paulmirel/STELLA-1/STELLA_1.2/Documentation/lab_spec_documents/photos/IMG_4180.jpeg

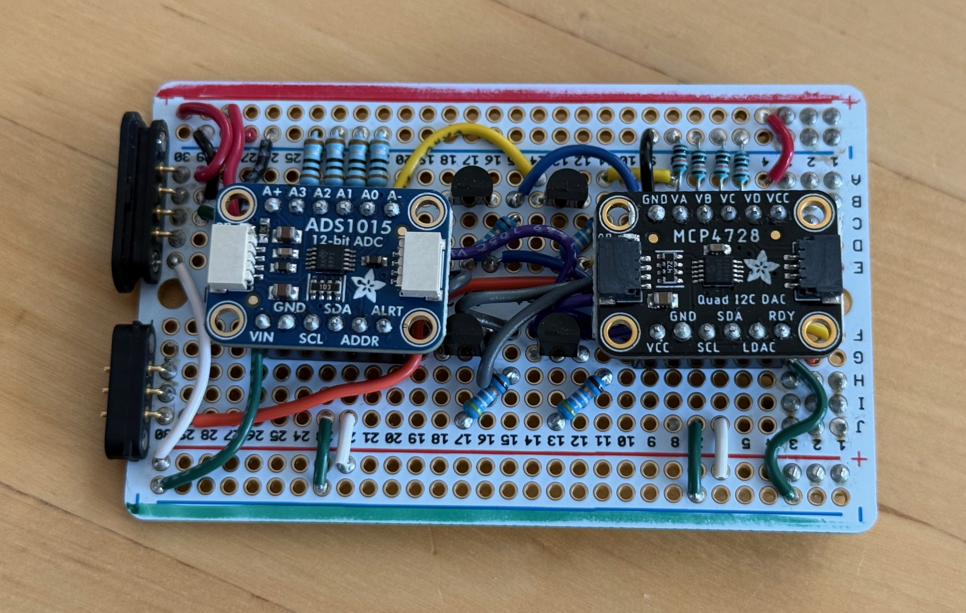
STELLA_1.2/Documentation/lab_spec_documents/photos/IMG_4180.jpeg
