paulmirel/STELLA-1/Everything_else/sparkfun_triad library earlier versions/AS7265X_sparkfun_circuitpython-main AWGrover/README.md

# AS7265X_sparkfun_micropython
CircuitPython driver for the AS7265X 18-channels spectral sensor

Install: 
* download the .zip
* copy the folder `AS7265X_sparkfun/` inside `CIRCUITPY/lib`.
* you can try the `examples/code.py` by copying it to `CIRCUITPY`

Usage is very similar to https://github.com/sparkfun/SparkFun_AS7265x_Arduino_Library

See the `__init__.py` and `examples/` for usage.

This is a python library for the AS7265X 18-channels spectral sensor designed to operate with Sparkfun's boards. It is based on 
[NPC1399's circuitpython library](https://github.com/NPC1399/AS7265X_sparkfun_micropython) which was based on
SparkFun_AS7265x_Arduino_Library : https://github.com/sparkfun/SparkFun_AS7265x_Arduino_Library.

Issues: https://github.com/awgrover/AS7265X_sparkfun_circuitpython
