paulmirel/STELLA-1/STELLA_1.2/Documentation/lab_spec_documents/photos/IMG_4187.jpeg

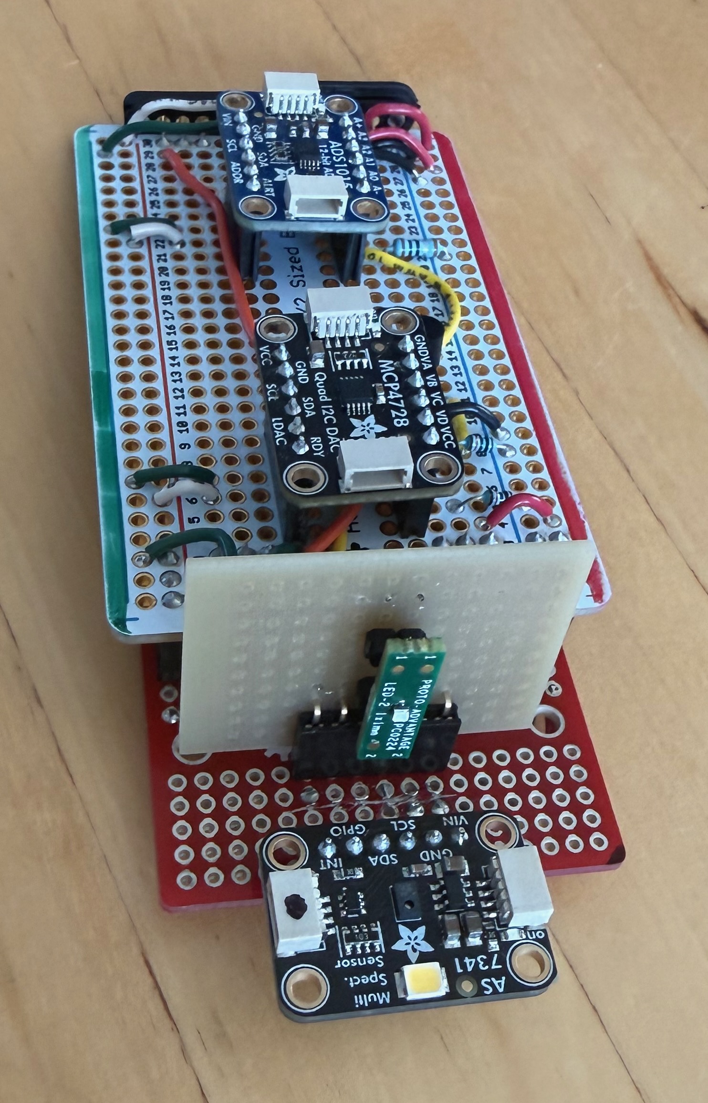
STELLA_1.2/Documentation/lab_spec_documents/photos/IMG_4187.jpeg
