paulmirel/STELLA-1/STELLA_1.2/Documentation/STELLA-1.2 package control lists 20251022.xlsx

Sheet: Control List
Document control list
Line | Type | Item | Module | Filename | Exists | Included in Z_S12 | Notes
1 | Document | Build Instructions Checklist | Main Unit | STELLA-1.2_main_board_build.pdf | TRUE | TRUE
2 | Document | Build Photos Series | Main Unit |  | FALSE | FALSE
3 | Document | Commercial Components List | Main Unit | in this document | TRUE | TRUE
4 | Document | Electronics Schematic | Main Unit | stella-1_2_schematic.pdf | TRUE | TRUE
5 | Document | Print Parts List | Main Unit | in this document | TRUE | TRUE
6 | Zip file | S12 Print parts | Main Unit | S12_print_parts.zip | TRUE | TRUE
7 | Document | Supported Sensors list | Software | in this document | TRUE | TRUE
8 | Code | Instrument Code, v0.2.7 alpha | Software | STELLA-1.2 version 0.2.7 alpha.zip | TRUE | TRUE
9 | Libraries | lib file | Software | lib.zip | TRUE | TRUE
10 | Document | Build Instructions Checklist | Remote Sensing Module |  | FALSE | FALSE
11 | Document | Commercial Components List | Remote Sensing Module | in this document | TRUE | TRUE
12 | Document | Electronics Schematic | Remote Sensing Module | S12-RS-remote-sensing-plugin-schematic.pdf | TRUE | TRUE
13 | Document | Print Parts List | Remote Sensing Module | in this document | TRUE | TRUE
14 | Zip file | Remote Sensing Print Parts | Remote Sensing Module | S12 RS print parts.zip | TRUE | TRUE
15 | Document | Build Instructions Checklist | Air Analyzer Module |  | FALSE | FALSE
16 | Document | Commercial Components List | Air Analyzer Module | in this document | TRUE | TRUE
17 | Document | Electronics Schematic | Air Analyzer Module |  | TRUE | TRUE
18 | Document | Print Parts List | Air Analyzer Module |  | FALSE | FALSE
19 | Zip file | Air Analyzer Print Parts | Air Analyzer Module |  | FALSE | FALSE
20 | Document | Electronics Schematic | Differential Liquid Spectroscopy Module |  | TRUE | TRUE

Sheet: Main Print List
Main Unit Print Parts List
 |  | color1 | color2 | color3 | color4
1 | S12 assembly fixture _ print w supports on build plate.STL | body
2 | S12 aux sensor retainer.STL | body
3 | S12 battery spacer.STL | body
4 | S12 clock spacer.STL | body
5 | S12 GPS window color change at 0.4 and 0.8 and 1.5.STL | body | clear | text | body
6 | S12 lower housing.STL | body
7 | S12 magnet coupler alignment fixture for main body w flats.STL | body
8 | S12 magnet coupler alignment fixture for plugins w pins.STL | body
9 | S12 QT alignment fixture.STL | body
10 | S12 REC window change color at 0.4 and 0.8 and 1.5.STL | body | clear | text | body
11 | S12 sd card swing door.STL | body
12 | S12 sdcard alignment fixture.STL | body
13 | S12 tail lights window change color at 0.4 and 0.8 and 1.5.STL | body | clear | text | body
14 | S12 UID side tag change color at 1.6.STL | body
15 | S12 UID side tag.STEP | body
16 | S12 upper housing change color at 0.8 and 1.6.STL | body | text

Sheet: Supported Devices
STELLA-1.2 supported devices list
Updated: | 20250714
 | Device | Address | Read time, ms | Link | Notes
1 | ads1015_12_bit_adc | 0x48 |  | https://www.adafruit.com/product/1083
2 | ads1115_16_bit_adc | 0x4a* |  | https://www.adafruit.com/product/1085
3 | as7265x_spectrometer | 0x49 | 900 | https://www.sparkfun.com/sparkfun-triad-spectroscopy-sensor-as7265x-qwiic.html | Reading the sensor temperatures takes 44ms, counts takes 260ms, fcal, 534ms
4 | as7331_spectrometer | 0x74 |  | https://www.sparkfun.com/sparkfun-spectral-uv-sensor-as7331-qwiic.html
5 | as7341_spectrometer | 0x39 |  | https://www.adafruit.com/product/4698
6 | bme280_air_sensor | 0x77 |  | https://www.adafruit.com/product/2652
7 | capacitive_soil_moisture_sensor | 0x37* |  | https://www.adafruit.com/product/4026
8 | ds2484_1_wire_thermometer | 0x18 |  | https://www.adafruit.com/product/5976 with https://www.sparkfun.com/temperature-sensor-waterproof-ds18b20.html
9 | gps_PA1616D | uart |  | housed in main unit: https://www.adafruit.com/product/5440
10 | hdc3022_air_sensor | 0x44 | 4 | https://www.adafruit.com/product/5989
11 | lis2mdl_magnetic_field_sensor * | 0x1e |  | https://www.adafruit.com/product/4413
12 | lis3mdl_magnetic_field_sensor * | 0x1c |  | https://www.adafruit.com/product/4517
13 | lsm303_acceleration_sensor * | 0x19 |  | https://www.adafruit.com/product/4413
14 | lsm6ds_accel_gyro_sensor * | 0x6a |  | https://www.adafruit.com/product/4517
15 | ltr390_uva_sensor | 0x53 |  | https://www.adafruit.com/product/4831
16 | max1704x_battery_monitor | 0x36 | 4 | built-in on the processor board
17 | mcp9808_air_thermometer | 0x1f* |  | https://www.adafruit.com/product/5027
18 | mlx90614_surface_thermometer | 0x5a | 2 | https://www.digikey.com/en/products/detail/melexis-technologies-nv/MLX90614ESF-BCC-000-SP/5416203
19 | mlx90640_thermal_camera | 0x33 |  | https://www.adafruit.com/product/4407
20 | pcf8523_real_time_clock | 0x68 |  | housed in main unit: https://www.adafruit.com/product/5189
21 | pcf8591_8_bit_adc_dac | 0x4f* |  | https://www.adafruit.com/product/4648
22 | pmsa0031_particulates_sensor | 0x12 |  | https://www.adafruit.com/product/4632
23 | qwiic buzzer | 0x34 |  | https://www.sparkfun.com/sparkfun-qwiic-buzzer.html
24 | scd30_co2_sensor | 0x61 |  | https://www.adafruit.com/product/4867
25 | scd4x_co2_sensor | 0x62 |  | https://www.adafruit.com/product/5187, https://www.adafruit.com/product/5190
26 | vl53l1x_4m_range_sensor | 0x29 |  | https://www.adafruit.com/product/3967
27 | mcp4725_1ch_12bit_dac | 0x63* |  | https://www.adafruit.com/product/935
 | * two elements in one unit | * mod address

Sheet: Main Menu Choices
Table 1
 | Choice name | length
 | Air Analyzer | 12
 | Liquid Color | 12
 | Liquid Fluor | 12
 | Spectrum Fan | 12
 | Time / Place | 12
 | Soil Moist’r | 12
 | Electronics | 11
 | Rmt Mapping | 11
1 | Rmt Sensing | 11
 | Soil Water | 10
 | Sky Light | 9
3 | Sensors | 7
 | * future use | 12
 | Heat | 4
 |  | 0
 | Status | More… | Return

Sheet: All Headers
line | Sensor | Part number | Parameter | Units | Header
1 | instrument |  | unique_identifier |  | unique_identifier
2 | instrument |  | unique_measurement_number |  | unique_measurement_number
3 | instrument |  | timestamp | iso8601utc | timestamp-!-iso8601utc
4 | instrument |  | batch_number |  | batch_number
5 | instrument |  | burst_counter |  | burst_counter
6 | instrument |  | decimal_time | hour | decimal_time-!-hour
7 | ads1015_12_bit_adc | ads1015 | channel_0_voltage | V | ads1015_channel_0_voltage-!-V
8 | ads1015_12_bit_adc | ads1015 | channel_1_voltage | V | ads1015_channel_1_voltage-!-V
9 | ads1015_12_bit_adc | ads1015 | channel_2_voltage | V | ads1015_channel_2_voltage-!-V
10 | ads1015_12_bit_adc | ads1015 | channel_3_voltage | V | ads1015_channel_3_voltage-!-V
11 | ads1015_12_bit_adc | ads1015 | channel_0_digital_number | counts | ads1015_channel_0_digital_number-!-counts
12 | ads1015_12_bit_adc | ads1015 | channel_1_digital_number | counts | ads1015_channel_1_digital_number-!-counts
13 | ads1015_12_bit_adc | ads1015 | channel_2_digital_number | counts | ads1015_channel_2_digital_number-!-counts
14 | ads1015_12_bit_adc | ads1015 | channel_3_digital_number | counts | ads1015_channel_3_digital_number-!-counts
15 | ads1015_12_bit_adc | ads1015 | gain |  | ads1015_gain-!-
16 | ads1115_16_bit_adc | ads1115 | channel_0_voltage | V | ads1115_channel_0_voltage-!-V
17 | ads1115_16_bit_adc | ads1115 | channel_1_voltage | V | ads1115_channel_1_voltage-!-V
18 | ads1115_16_bit_adc | ads1115 | channel_2_voltage | V | ads1115_channel_2_voltage-!-V
19 | ads1115_16_bit_adc | ads1115 | channel_3_voltage | V | ads1115_channel_3_voltage-!-V
20 | ads1115_16_bit_adc | ads1115 | channel_0_digital_number | counts | ads1115_channel_0_digital_number-!-counts
21 | ads1115_16_bit_adc | ads1115 | channel_1_digital_number | counts | ads1115_channel_1_digital_number-!-counts
22 | ads1115_16_bit_adc | ads1115 | channel_2_digital_number | counts | ads1115_channel_2_digital_number-!-counts
23 | ads1115_16_bit_adc | ads1115 | channel_3_digital_number | counts | ads1115_channel_3_digital_number-!-counts
24 | ads1115_16_bit_adc | ads1115 | gain |  | ads1115_gain-!-
25 | bme280_air_sensor | bme280 | barometric_pressure | hPa | bme280_barometric_pressure-!-hPa
26 | bme280_air_sensor | bme280 | altitude_relative | m | bme280_altitude_relative-!-m
27 | bme280_air_sensor | bme280 | humidity_relative | percent | bme280_humidity_relative-!-percent
28 | bme280_air_sensor | bme280 | temperature_ambient | C | bme280_temperature_ambient-!-C
29 | capacitive_soil_moisture_sensor | capacitive_soil | moisture_signal |  | capacitive_soil_moisture_signal-!-
30 | conductive_soil_moisture_sensor | conductive_soil | moisture_signal |  | conductive_soil_moisture_signal-!-
31 | ds2484_1_wire_thermometer | ds2484 | temperature_material | C | ds2484_temperature_material-!-C
32 | gps_PA1616D | gps | fix | boolean | gps_fix-!-boolean
33 | gps_PA1616D | gps | latitude | degrees | gps_latitude-!-degrees
34 | gps_PA1616D | gps | longitude | degrees | gps_longitude-!-degrees
35 | gps_PA1616D | gps | altitude | m | gps_altitude-!-m
36 | gps_PA1616D | gps | timestamp | iso8601utc | gps_timestamp-!-iso8601utc
37 | hdc3022_air_sensor | hdc3022 | temperature_ambient | C | hdc3022_temperature_ambient-!-C
38 | hdc3022_air_sensor | hdc3022 | humidity_relative | percent | hdc3022_humidity_relative-!-percent
39 | hrlv-ez-mb1013_rangefinder | hrlv-ez-mb1013 | range | m | hrlv-ez-mb1013_range-!-m
40 | lis2mdl_magnetic_field_sensor | lis2mdl | magnetic_field_x | uT | lis2mdl_magnetic_field_x-!-uT
41 | lis2mdl_magnetic_field_sensor | lis2mdl | magnetic_field_y | uT | lis2mdl_magnetic_field_y-!-uT
42 | lis2mdl_magnetic_field_sensor | lis2mdl | magnetic_field_z | uT | lis2mdl_magnetic_field_z-!-uT
43 | lis3mdl_magnetic_field_sensor | lis3mdl | magnetic_field_x | uT | lis3mdl_magnetic_field_x-!-uT
44 | lis3mdl_magnetic_field_sensor | lis3mdl | magnetic_field_y | uT | lis3mdl_magnetic_field_y-!-uT
45 | lis3mdl_magnetic_field_sensor | lis3mdl | magnetic_field_z | uT | lis3mdl_magnetic_field_z-!-uT
46 | lsm303_acceleration_sensor | lsm303 | acceleration_x | m_per_s_sq | lsm303_acceleration_x-!-m_per_s_sq
47 | lsm303_acceleration_sensor | lsm303 | acceleration_y | m_per_s_sq | lsm303_acceleration_y-!-m_per_s_sq
48 | lsm303_acceleration_sensor | lsm303 | acceleration_z | m_per_s_sq | lsm303_acceleration_z-!-m_per_s_sq
49 | lsm6ds_accel_gyro_sensor | lsm6ds | acceleration_x | m_per_s_sq | lsm6ds_acceleration_x-!-m_per_s_sq
50 | lsm6ds_accel_gyro_sensor | lsm6ds | acceleration_y | m_per_s_sq | lsm6ds_acceleration_y-!-m_per_s_sq
51 | lsm6ds_accel_gyro_sensor | lsm6ds | acceleration_z | m_per_s_sq | lsm6ds_acceleration_z-!-m_per_s_sq
52 | lsm6ds_accel_gyro_sensor | lsm6ds | rotation_x | degrees_per_s | lsm6ds_rotation_x-!-degrees_per_s
53 | lsm6ds_accel_gyro_sensor | lsm6ds | rotation_x | degrees_per_s | lsm6ds_rotation_x-!-degrees_per_s
54 | lsm6ds_accel_gyro_sensor | lsm6ds | rotation_x | degrees_per_s | lsm6ds_rotation_x-!-degrees_per_s
55 | ltr390_uva_sensor | ltr390 | illumination | counts | ltr390_illumination-!-counts
56 | ltr390_uva_sensor | ltr390 | illumination | lux | ltr390_illumination-!-lux
57 | ltr390_uva_sensor | ltr390 | uva | counts | ltr390_uva-!-counts
58 | ltr390_uva_sensor | ltr390 | uv_index |  | ltr390_uv_index-!-
59 | max1704x_battery_monitor | max1704x | battery_voltage | V | max1704x_battery_voltage-!-V
60 | max1704x_battery_monitor | max1704x | battery_energy | percent | max1704x_battery_energy-!-percent
61 | mcp9808_air_thermometer | mcp9808 | temperature_ambient | C | mcp9808_temperature_ambient-!-C
62 | mlx90614_surface_thermometer | mlx90614 | temperature_surface | C | mlx90614_temperature_surface-!-C
63 | mlx90614_surface_thermometer | mlx90614 | temperature_local | C | mlx90614_temperature_local-!-C
64 | pcf8591_8_bit_adc_dac | pcf8591 | channel_0_digital_number | counts | pcf8591_channel_0_digital_number-!-counts
65 | pcf8591_8_bit_adc_dac | pcf8591 | channel_1_digital_number | counts | pcf8591_channel_1_digital_number-!-counts
66 | pcf8591_8_bit_adc_dac | pcf8591 | channel_2_digital_number | counts | pcf8591_channel_2_digital_number-!-counts
67 | pcf8591_8_bit_adc_dac | pcf8591 | channel_3_digital_number | counts | pcf8591_channel_3_digital_number-!-counts
68 | pcf8591_8_bit_adc_dac | pcf8591 | channel_0_voltage | V | pcf8591_channel_0_voltage-!-V
69 | pcf8591_8_bit_adc_dac | pcf8591 | channel_1_voltage | V | pcf8591_channel_1_voltage-!-V
70 | pcf8591_8_bit_adc_dac | pcf8591 | channel_2_voltage | V | pcf8591_channel_2_voltage-!-V
71 | pcf8591_8_bit_adc_dac | pcf8591 | channel_3_voltage | V | pcf8591_channel_3_voltage-!-V
72 | pmsa0031_particulates_sensor | pmsa0031 | air_quality_index_for_particulates |  | pmsa0031_air_quality_index_for_particulates-!-
73 | pmsa0031_particulates_sensor | pmsa0031 | pm2.5_over_pm10_ratio |  | pmsa0031_pm2.5_over_pm10_ratio-!-
74 | pmsa0031_particulates_sensor | pmsa0031 | pm1 | ug_per_m_cubed | pmsa0031_pm1-!-ug_per_m_cubed
75 | pmsa0031_particulates_sensor | pmsa0031 | pm2.5 | ug_per_m_cubed | pmsa0031_pm2.5-!-ug_per_m_cubed
76 | pmsa0031_particulates_sensor | pmsa0031 | pm10 | ug_per_m_cubed | pmsa0031_pm10-!-ug_per_m_cubed
77 | pmsa0031_particulates_sensor | pmsa0031 | particle_count_0.3m | count_per_100mL | pmsa0031_particle_count_0.3m-!-count_per_100mL
78 | pmsa0031_particulates_sensor | pmsa0031 | particle_count_0.5m | count_per_100mL | pmsa0031_particle_count_0.5m-!-count_per_100mL
79 | pmsa0031_particulates_sensor | pmsa0031 | particle_count_1m | count_per_100mL | pmsa0031_particle_count_1m-!-count_per_100mL
80 | pmsa0031_particulates_sensor | pmsa0031 | particle_count_2.5m | count_per_100mL | pmsa0031_particle_count_2.5m-!-count_per_100mL
81 | pmsa0031_particulates_sensor | pmsa0031 | particle_count_5m | count_per_100mL | pmsa0031_particle_count_5m-!-count_per_100mL
82 | pmsa0031_particulates_sensor | pmsa0031 | particle_count_10m | count_per_100mL | pmsa0031_particle_count_10m-!-count_per_100mL
83 | scd30_co2_sensor | scd30 | co2_ambient | ppm | scd30_co2_ambient-!-ppm
84 | scd30_co2_sensor | scd30 | co2_uncertainty | ppm | scd30_co2_uncertainty-!-ppm
85 | scd30_co2_sensor | scd30 | temperature_ambient | C | scd30_temperature_ambient-!-C
86 | scd30_co2_sensor | scd30 | humidity_relative | percent | scd30_humidity_relative-!-percent
87 | scd4x_co2_sensor | scd4x | co2_ambient | ppm | scd4x_co2_ambient-!-ppm
88 | scd4x_co2_sensor | scd4x | co2_uncertainty | ppm | scd4x_co2_uncertainty-!-ppm
89 | scd4x_co2_sensor | scd4x | temperature_ambient | C | scd4x_temperature_ambient-!-C
90 | scd4x_co2_sensor | scd4x | humidity_relative | percent | scd4x_humidity_relative-!-percent
91 | vl53l1x_4m_range_sensor | vl53l1x | distance | m | vl53l1x_distance-!-m
92 | analog_in | analog | input_0_digital_number | counts | analog_input_0_digital_number-!-counts
93 | analog_in | analog | input_0_voltage | V | analog_input_0_voltage-!-V
94 | mq-4_methane_sensor | mq-4 | methane_relative | ppm | mq-4_methane_relative-!-ppm
95 | spectral_headers | spectral | spectral_sensor_part_number |  | spectral_sensor_part_number
96 | spectral_headers | spectral | wavelength | nm | spectral_wavelength-!-nm
97 | spectral_headers | spectral | bandwidth | nm | spectral_bandwidth-!-nm
98 | spectral_headers | spectral | photodetector_digital_number | counts | spectral_photodetector_digital_number-!-counts
99 | spectral_headers | spectral | irradiance | uW_per_cm_sq | spectral_irradiance-!-uW_per_cm_sq
100 | spectral_headers | spectral | uncertainty_in_irradiance | uW_per_cm_sq | spectral_uncertainty_in_irradiance-!-uW_per_cm_sq
101 | spectral_headers | spectral | gain |  | spectral_gain-!-
102 | spectral_headers | spectral | integration_time | ms | spectral_integration_time-!-ms
103 | spectral_headers | spectral | detector_chip_number |  | spectral_detector_chip_number-!-
104 | spectral_headers | spectral | detector_chip_temperature | C | spectral_detector_chip_temperature-!-C
105 | spectral_headers | spectral | irradiance_future_source_calibrated | uW_per_cm_sq | spectral_irradiance_future_source_calibrated-!-uW_per_cm_sq
106 | spectral_headers | spectral | uncertainty_in_irradiance_future_source_calibrated | uW_per_cm_sq | spectral_uncertainty_in_irradiance_future_source_calibrated-!-uW_per_cm_sq
 | Created: 20250718
 | Updated: 20250729

Sheet: Sensor Page Fields
line | Sensor | Manufacturer | Name | Part number | First Column | Second Column | Third Column | About
 | ads1015_12_bit_adc | Texas Instruments | ADC 12 bit | ads1015 | Channel N | raw counts | voltage V
 | ads1115_16_bit_adc | Texas Instruments | ADC 16 bit | ads1115 | Channel N | raw counts | voltage V
 | bme280_air_sensor | Bosch Sensortec | Ambient Air | bme280 | Pressure | value | +/- 1 hPa | The BME280 measures pressure with a piezo-resistive Winston bridge, humidity with a capacitance change MEMs device, and temperature with a conduction band gap diode.
 | bme280_air_sensor | Bosch Sensortec | Ambient Air | bme280 | Altitude, relative | value | resolution 0.1 m
 | bme280_air_sensor | Bosch Sensortec | Ambient Air | bme280 | Temperature | value | +/- 0.5 C
 | bme280_air_sensor | Bosch Sensortec | Ambient Air | bme280 | Humidity | value | +/- 3 %
 | capacitive_soil_moisture_sensor | Adafruit Industries | Soil Moisture | capacitive_soil | Moisture Signal | value | uncalibrated | Adafruit uses the capacitive touch measurement system built into the ATSAMD10 chip, which will give you a reading ranging from about 200 (very dry) to 2000 (very wet).
 | conductive_soil_moisture_sensor | SparkFun Electronics | Soil Moisture | conductive_soil | Moisture Signal | value | uncalibrated | The two exposed pads function as probes, together acting as a variable resistor. The more water in the soil, the better the conductivity between the pads will be, resulting in lower resistance and a higher signal output.
 | ds2484_1_wire_thermometer | Dallas Semiconductor | Thermometer | DS18B20 | Temperature | value | +/- 0.5 C | The DS18B20-PAR digital thermometer provides 9 to 12–bit centigrade temperature measurements and does not need an external power supply because it derives power directly from the data line (“parasite power”). It communicates over a 1-Wire bus, which by definition requires only one data line (and ground) for communication with a central microprocessor. It has an operating temperature range of –55°C to +100°C and is accurate to ±0.5°C over a range of –10°C to +85°C.
 | gps_PA1616D | CD Technology | GPS | PA1616D | Has Fix | boolean |  | The CDTop CD-PA1616D module utilizes the MediaTek new generation GNSS Chipset MT3333 that support various location and navigation applications, including autonomous GPS, GLONASS, GALILEO, QZSS, SBAS(note) ranging (WAAS, EGNOS, GAGAN, MSAS),QZSS,DGPS(RTCM) and AGPS. It support up to 210 PRN channels with 99 search channels and 33 simultaneous tracking channels. It is the industry’s highest level of sensitivity (-165dBm) and instant Time-to-First Fix (TTFF). Precise GNSS signal processing give the ultra-precise positioning under low receptive, high velocity conditions. Up to 12 multi-tone active interference canceller (ISSCC2011 award).
 | gps_PA1616D | CD Technology | GPS | PA1616D | latitude | value | degrees +/-3 m
 | gps_PA1616D | CD Technology | GPS | PA1616D | longitude | value | degrees +/-3 m
 | gps_PA1616D | CD Technology | GPS | PA1616D | altitude | value | +/-3 m
 | gps_PA1616D | CD Technology | GPS | PA1616D | timestamp | value | iso8601
 | gps_PA1616D | CD Technology | GPS | PA1616D | number of satellites | value
 | gps_PA1616D | CD Technology | GPS | PA1616D | warm start battery | OK or LOW
 | hdc3022_air_sensor | Texas Instruments | Ambient Air | hdc3022 | Temperature | value | +/- 0.1 C | The HDC3022 measures relative humidity through variations in the capacitance of a polymer dielectric. Both the temperature and humidity sensors are 100% tested and trimmed on a production setup that is NIST traceable and verified with equipment that is calibrated to ISO/IEC 17025 standards.
 | hdc3022_air_sensor | Texas Instruments | Ambient Air | hdc3022 | Humidity | value | +/- 0.5 %
 | hrlv-ez-mb1013_rangefinder | Espressif | ADC 12 bits | ESP32-S3 | Raw
 | hrlv-ez-mb1013_rangefinder | Maxbotics | Ultrasonic Range | hrlv-ez-mb1013 | Range | value | +/- TBD m (calculate 1% of signal) | 42kHz ultrasonic sensor measures distance to objects. Distance = time from pulse send to echo received / speed of sound in air. Since the speed of sound in air varies with temperature, the probe is temperature compensated. For distance measurement, the useful range of the sensor is from 0.3m to 2.5m
 | lis2mdl_magnetic_field_sensor | STMicroelectronics | Magnetic Field | lis2mdl | magnetic_field_x | value | +/- 6 uT | The LIS2MDL is a high-performance 3-axis digital magnetic sensor. It has a magnetic field dynamic range of ±50 gauss = 5000 uT
 | lis2mdl_magnetic_field_sensor | STMicroelectronics | Magnetic Field | lis2mdl | magnetic_field_y | value | +/- 6 uT
 | lis2mdl_magnetic_field_sensor | STMicroelectronics | Magnetic Field | lis2mdl | magnetic_field_z | value | +/- 6 uT
 | lis3mdl_magnetic_field_sensor | STMicroelectronics | Magnetic Field | lis3mdl | magnetic_field_x | value | +/- 1 uT | The LIS3MDL is a high-performance 3-axis magnetic sensor with user-selectable full scales of ±4/±8/±12/±16 gauss. (400 to 1600 uT)
 | lis3mdl_magnetic_field_sensor | STMicroelectronics | Magnetic Field | lis3mdl | magnetic_field_y | value | +/- 1 uT
 | lis3mdl_magnetic_field_sensor | STMicroelectronics | Magnetic Field | lis3mdl | magnetic_field_z | value | +/- 1 uT
 | lsm303_acceleration_sensor | STMicroelectronics | Accelerometer | lsm303 | acceleration_x | value | m/s^2 | The LSM303 is a high-performance 3-axis digital linear acceleration sensor with linear acceleration full scales of ±2g/±4g/±8g/16g
 | lsm303_acceleration_sensor | STMicroelectronics | Accelerometer | lsm303 | acceleration_y | value | m/s^2
 | lsm303_acceleration_sensor | STMicroelectronics | Accelerometer | lsm303 | acceleration_z | value | m/s^2
 | lsm6ds_accel_gyro_sensor | STMicroelectronics | Accel-Gyro | lsm6ds | acceleration_x | value | m/s^2
 | lsm6ds_accel_gyro_sensor | STMicroelectronics | Accel-Gyro | lsm6ds | acceleration_y | value | m/s^2
 | lsm6ds_accel_gyro_sensor | STMicroelectronics | Accel-Gyro | lsm6ds | acceleration_z | value | m/s^2
 | lsm6ds_accel_gyro_sensor | STMicroelectronics | Accel-Gyro | lsm6ds | rotation_x | value | degrees_per_s
 | lsm6ds_accel_gyro_sensor | STMicroelectronics | Accel-Gyro | lsm6ds | rotation_x | value | degrees_per_s
 | lsm6ds_accel_gyro_sensor | STMicroelectronics | Accel-Gyro | lsm6ds | rotation_x | value | degrees_per_s
 | ltr390_uva_sensor |  |  | ltr390 | illumination | raw | value lux
 | ltr390_uva_sensor |  |  | ltr390 | uva | counts | value uv index
 | max1704x_battery_monitor |  |  | max1704x | battery_voltage | V
 | max1704x_battery_monitor |  |  | max1704x | battery_energy | percent
 | mcp9808_air_thermometer |  |  | mcp9808 | temperature_ambient | C
 | mlx90614_surface_thermometer |  |  | mlx90614 | temperature_surface | C
 | mlx90614_surface_thermometer |  |  | mlx90614 | temperature_local | C
 | pcf8591_8_bit_adc_dac |  |  | pcf8591 | Channel N | raw counts | voltage V
 | pmsa0031_particulates_sensor |  |  | pmsa0031 | AQIp | value | particulates only
 | pmsa0031_particulates_sensor |  |  | pmsa0031 | pm2.5/pm10 | value
 | pmsa0031_particulates_sensor |  |  | pmsa0031 | pm1 | value | ug/m^3
 | pmsa0031_particulates_sensor |  |  | pmsa0031 | pm2.5 | value | ug/m^3
 | pmsa0031_particulates_sensor |  |  | pmsa0031 | pm10 | value | ug/m^3
 | pmsa0031_particulates_sensor |  |  | pmsa0031 | particle_count_1m | value | count/100mL
 | pmsa0031_particulates_sensor |  |  | pmsa0031 | particle_count_2.5m | value | count/100mL
 | pmsa0031_particulates_sensor |  |  | pmsa0031 | particle_count_10m | value | count/100mL
 | scd30_co2_sensor |  |  | scd30 | CO2 | value | +/- TBD ppm
 | scd30_co2_sensor |  |  | scd30 | temperature_ambient | value | +/- TBD C
 | scd30_co2_sensor |  |  | scd30 | humidity_relative | value | +/- TBD %
 | scd4x_co2_sensor |  |  | scd4x | co2_ambient | value | +/- TBD ppm
 | scd4x_co2_sensor |  |  | scd4x | temperature_ambient | value | +/- TBD C
 | scd4x_co2_sensor |  |  | scd4x | humidity_relative | value | +/- TBD %
 | vl53l1x_4m_range_sensor |  |  | vl53l1x | distance | value | +/- 0.001 m
 | mq-4_methane_sensor |  |  | mq-4 | CH4 methane |  | ppm, relative

Sheet: TBD Thermal Image Headers
Table 1

Sheet: Main Components List
S12 Main Unit Components List
Line | Item | Quantity | Vendor/ Manufacturer | Part Number | $ each | qty to make N | packed
1 | Permaproto board, full size | 1 | Adafruit | 1606 | 11 |  | FALSE
2 | Feather ESP32-S3 | 1 | Adafruit | 5477 | 18 |  | FALSE
3 | rotary encoder with knob | 1 | Adafruit | 377 | 5 |  | FALSE
4 | Eyespi breakout board | 1 | Adafruit | 5613 | 2 |  | FALSE
5 | Eyespi cable, 100mm | 1 | Adafruit | 5239 | 1 |  | FALSE
6 | Capactive touch TFT display | 1 | Adafruit | 2090 | 30 |  | FALSE
7 | SD card module | 1 | Adafruit | 4682 | 4 |  | FALSE
8 | 8GB micro SD card | 1 | Adafruit | 1294 | 10 |  | FALSE
9 | Ultimate GPS breakout | 1 | Adafruit | 5440 | 30 |  | FALSE
10 | PCF8523 RTC clock module | 1 | Adafruit | 5189 | 5 |  | FALSE
11 | CR1220 coin cell battery | 2 | Adafruit | 380 | 2 |  | FALSE
12 | TPS61023 5V 1A boost | 1 | Adafruit | 4654 | 4 |  | FALSE
13 | 2200 mAh cylindrical battery — choose 1 of 3 | 1 | Adafruit | 1781 | 10 |  | FALSE
14 | 4400 mAh battery pack — choose 1 of 3 | 1 | Adafruit | 354 | 20 |  | FALSE
15 | 6600 mAh battery pack — choose 1 of 3 | 1 | Adafruit | 353 | 25 |  | FALSE
16 | magnet connector pair, RA, 4 positions | 1 | Adafruit | 5358 | 7 |  | FALSE
17 | magnet connector pair, RA, 3 positions | 1 | Adafruit | 5360 | 6 |  | FALSE
18 | Push on push off button switch | 1 | Digikey | CW181-ND | 2 |  | FALSE
19 | 0.1uF capacitor | 1 | Digikey | C315C104M5U5TA7303 | 1 |  | FALSE
20 | 10kΩ resistor | 3 | Digikey | RNF18FTD10K0CT-ND | 1 |  | FALSE

Sheet: RS Components List
Remote Sensing Plugin Components List
Line | Item | Quantity | Vendor/ Manufacturer | Part Number | $ each | packed
1 | Half size protoboard | 1 | Adafruit | 1609 | 5 | FALSE
2 | magnet connector pair, RA, 4 positions | 1 | Adafruit | 5358 | 7 | FALSE
3 | magnet connector pair, RA, 3 positions | 1 | Adafruit | 5360 | 6 | FALSE
4 | Precision Air Temperature and Humidity Sensor | 1 | Adafruit | 5989 | 9 | FALSE
5 | Ultrasonic Rangefinder - LV-EZ1 | 1 | Adafruit | 172 | 29 | FALSE
6 | Thermal Infrared Remote Surface Thermometer | 1 | Digikey | MLX90614ESF-BCC-000-SP-ND | 22 | FALSE
7 | 0.1uF capacitor | 1 | Digikey | C315C104M5U5TA7303 | 1 | FALSE
8 | 10kΩ resistor | 3 | Digikey | S10KCACT-ND | 1 | FALSE
9 | Triad Spectral Sensor, VIS and NIR | 1 | SparkFun | SEN-15050 | 70 | FALSE

Sheet: RS Print List
Remote Sensing Plugin Print Parts List
1 | S12 remote sensing plugin main housing | typically green
2 | S12 remote sensing plugin swing cover | recommend black

Sheet: AA Components List
Remote Sensing Plugin Components List
Line | Item | Quantity | Vendor/ Manufacturer | Part Number | $ each | packed
1 | Half size protoboard | 1 | Adafruit | 1609 | 5 | FALSE
2 | magnet connector pair, RA, 4 positions | 1 | Adafruit | 5358 | 7 | FALSE
3 | magnet connector pair, RA, 3 positions | 1 | Adafruit | 5360 | 6 | FALSE
4 | CO2 Sensor | 1 | Adafruit | 5187 or 5190 | 45 or 50 | FALSE
5 | Particulates Sensor | 1 | Adafruit | 4632 | 45 | FALSE
6 | Precision Air Temperature and Humidity Sensor | 1 | Adafruit | 5989 | 9 | FALSE
7 | Barometer w Temperature and Humidity | 1 | Adafruit | 2652 | 15 | FALSE
8 | 4.7kΩ resistor | 1 | Digikey | S4.7KCACT-ND | 1 | FALSE
9 | 100KΩ resistor | 2 | Digikey | S100KCACT-ND | 1 | FALSE
10 | methane sensor MQ-4 | 1 | SparkFun | SEN-09404 | 6 | FALSE
11 | methane sensor adapter board | 1 | SparkFun | BOB-08891 | 2 | FALSE
