paulmirel/STELLA-1/STELLA_1.2/Documentation/fixture_print_parts/full board magnet coupler fixture plate.STL

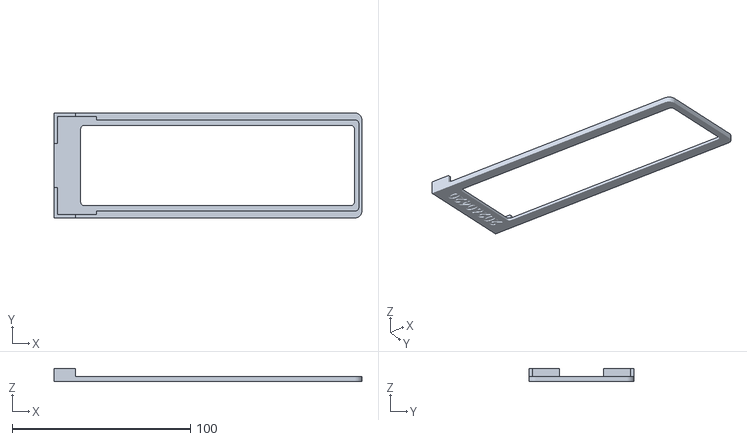
[picture p52: CAD file, 2026-04-20]
STELLA_1.2/Documentation/fixture_print_parts/full board magnet coupler fixture plate.STL
173.0 x 59.0 x 7.50
