paulmirel/STELLA-1/STELLA_1.2/Documentation/S12_print_parts/S12 remote sensing plugin main housing.STL

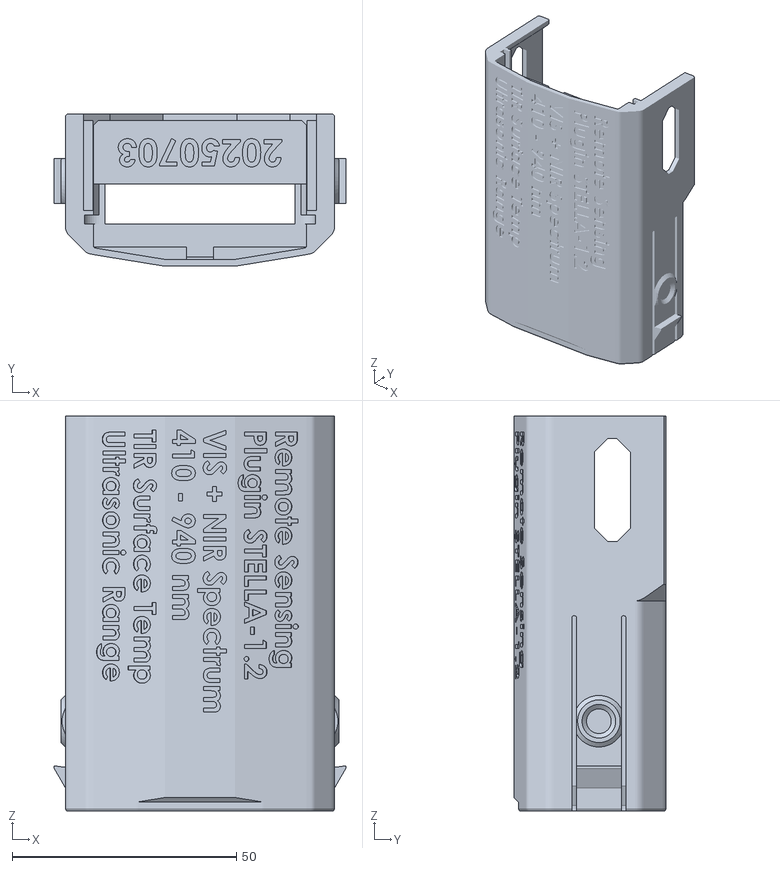
[picture p53: CAD file, 2025-10-20]
STELLA_1.2/Documentation/S12_print_parts/S12 remote sensing plugin main housing.STL
65.0 x 34.0 x 88.0
