paulmirel/STELLA-1/STELLA_1.2/Documentation/S12_print_parts/S12 assembly fixture _ print w supports on build plate.STL

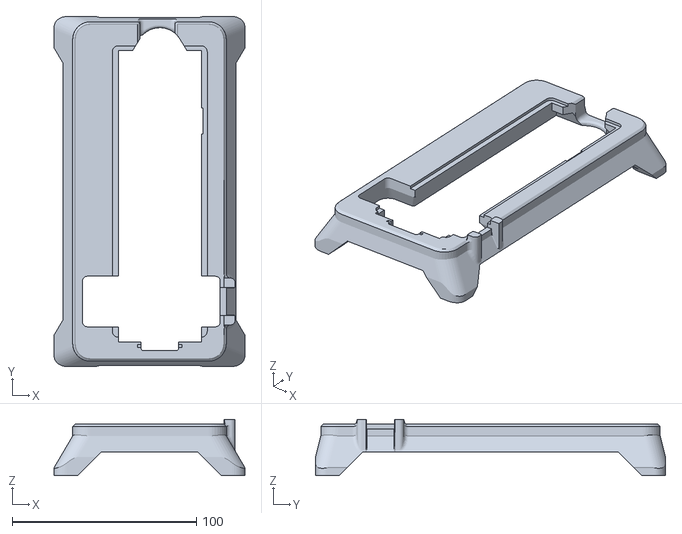
[picture p54: CAD file, 2025-10-20]
STELLA_1.2/Documentation/S12_print_parts/S12 assembly fixture _ print w supports on build plate.STL
103.6 x 189.9 x 30.5
