paulmirel/STELLA-1/STELLA_1.2/Documentation/lab_spec_documents/LS STL print files/LS-C2 detector block for cuvette - assembly fixture.STL

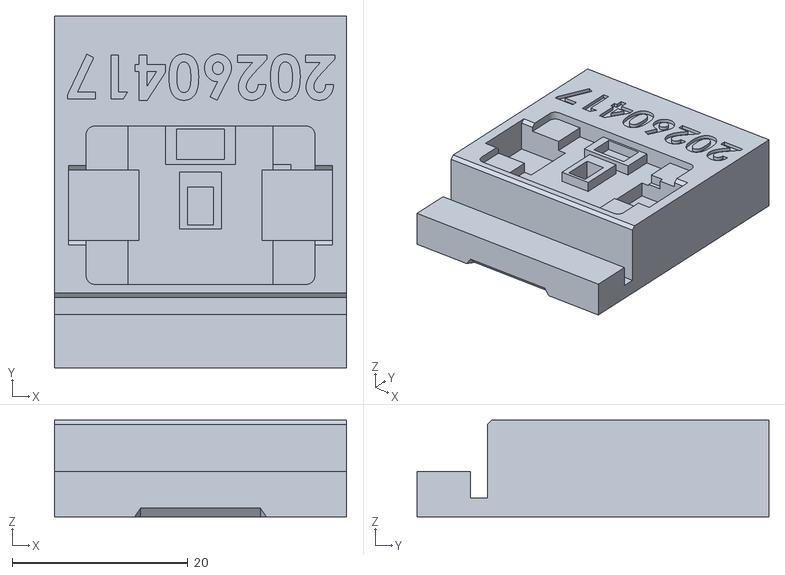
[picture p55: CAD file, 2026-04-18]
STELLA_1.2/Documentation/lab_spec_documents/LS STL print files/LS-C2 detector block for cuvette - assembly fixture.STL
33.2 x 40.0 x 11.0
