paulmirel/STELLA-1/STELLA_1.2/Documentation/S12_print_parts/S12 magnet coupler alignment fixture for main body w flats.STL

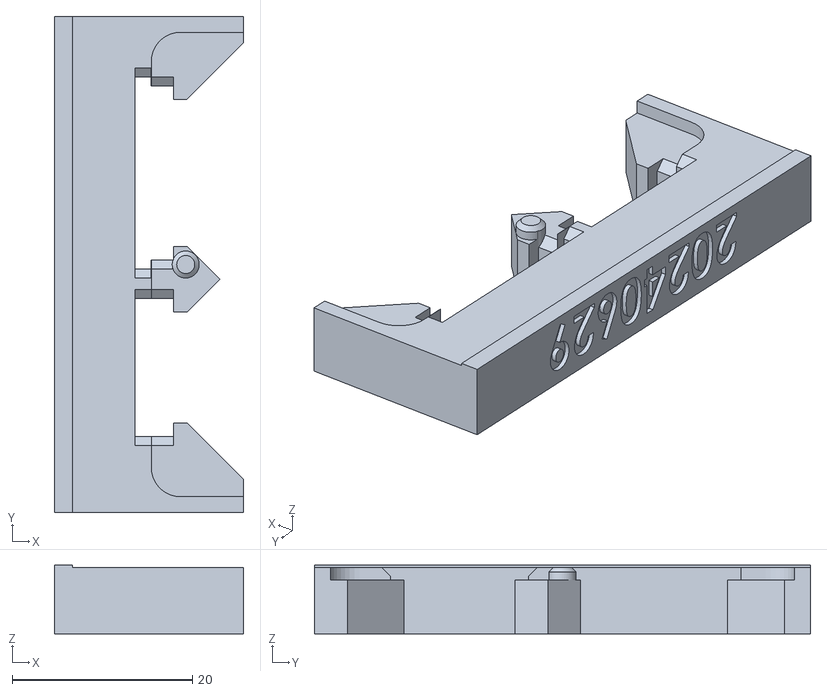
[picture p56: CAD file, 2025-10-20]
STELLA_1.2/Documentation/S12_print_parts/S12 magnet coupler alignment fixture for main body w flats.STL
21.0 x 55.0 x 7.65
