paulmirel/STELLA-1/Everything_else/Circuitpython_10_libraries/adafruit-circuitpython-bundle-10.x-mpy-20260924/examples/bno055/bno055_webgl_demo/static/cat_top.stl

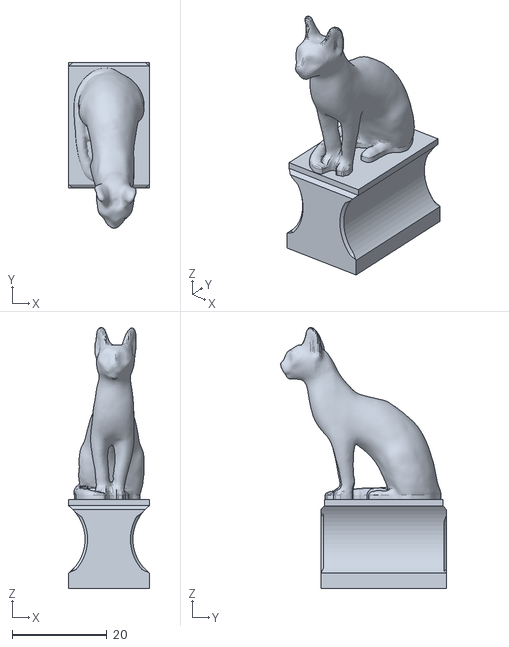
[picture p57: CAD file, 2026-01-07]
Everything_else/Circuitpython_10_libraries/adafruit-circuitpython-bundle-10.x-mpy-20260924/examples/bno055/bno055_webgl_demo/static/cat_top.stl
17.0 x 34.9 x 55.1
