paulmirel/STELLA-1/STELLA_1.2/Documentation/fixture_print_parts/magnet coupler alignment fixture mirror.STL

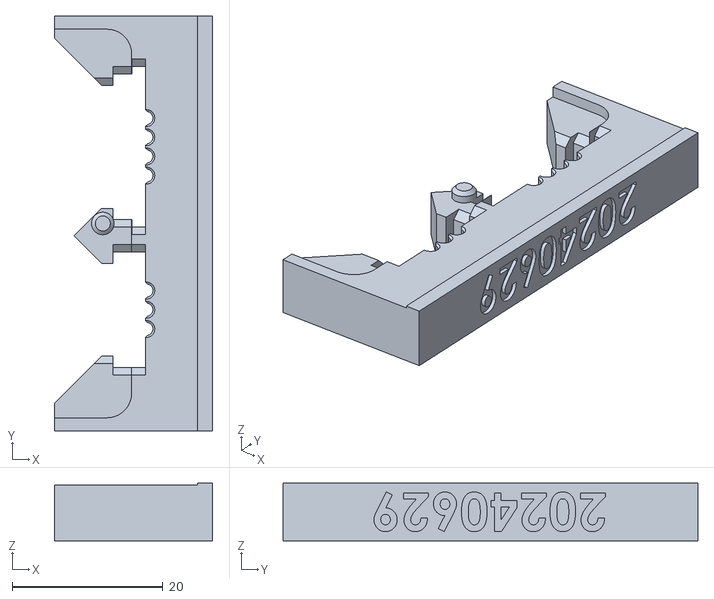
[picture p58: CAD file, 2026-04-20]
STELLA_1.2/Documentation/fixture_print_parts/magnet coupler alignment fixture mirror.STL
21.0 x 55.0 x 7.65
