paulmirel/STELLA-1/STELLA_1.2/Documentation/lab_spec_documents/LS STL print files/LS-C2 side led cover flag.STL

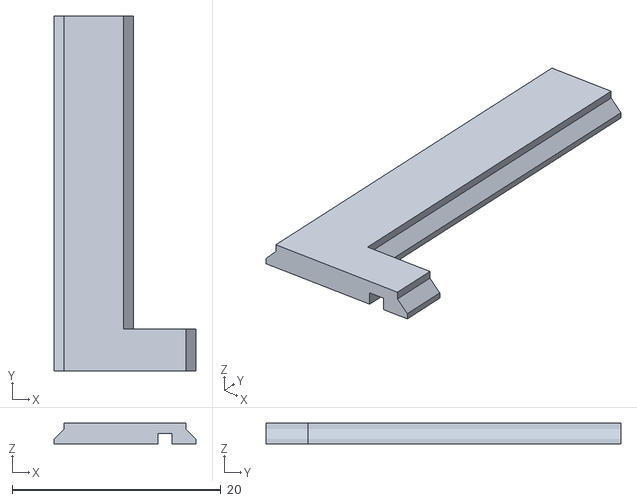
[picture p59: CAD file, 2026-04-22]
STELLA_1.2/Documentation/lab_spec_documents/LS STL print files/LS-C2 side led cover flag.STL
13.6 x 34.0 x 2.00
