paulmirel/STELLA-1/STELLA_1.2/Documentation/S12_print_parts/S12 remote sensing plugin swing cover.STL

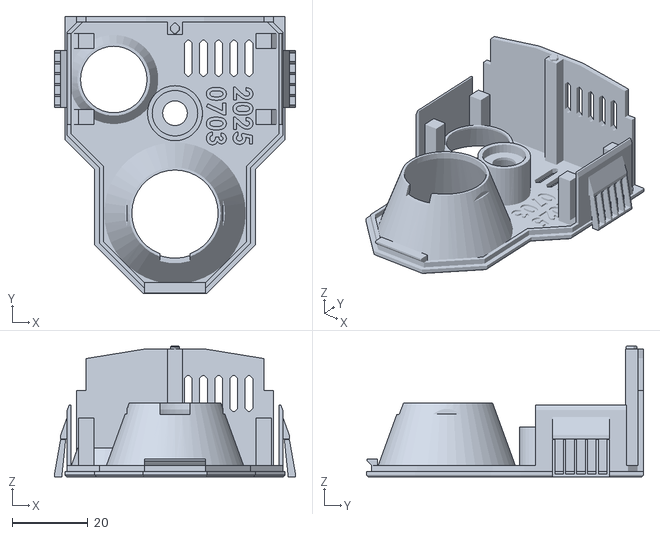
[picture p60: CAD file, 2025-10-20]
STELLA_1.2/Documentation/S12_print_parts/S12 remote sensing plugin swing cover.STL
63.5 x 73.0 x 34.5
