paulmirel/STELLA-1/Everything_else/Circuitpython_10_libraries/adafruit-circuitpython-bundle-10.x-mpy-20260924/examples/bno055/bno055_webgl_demo/static/bunny.obj

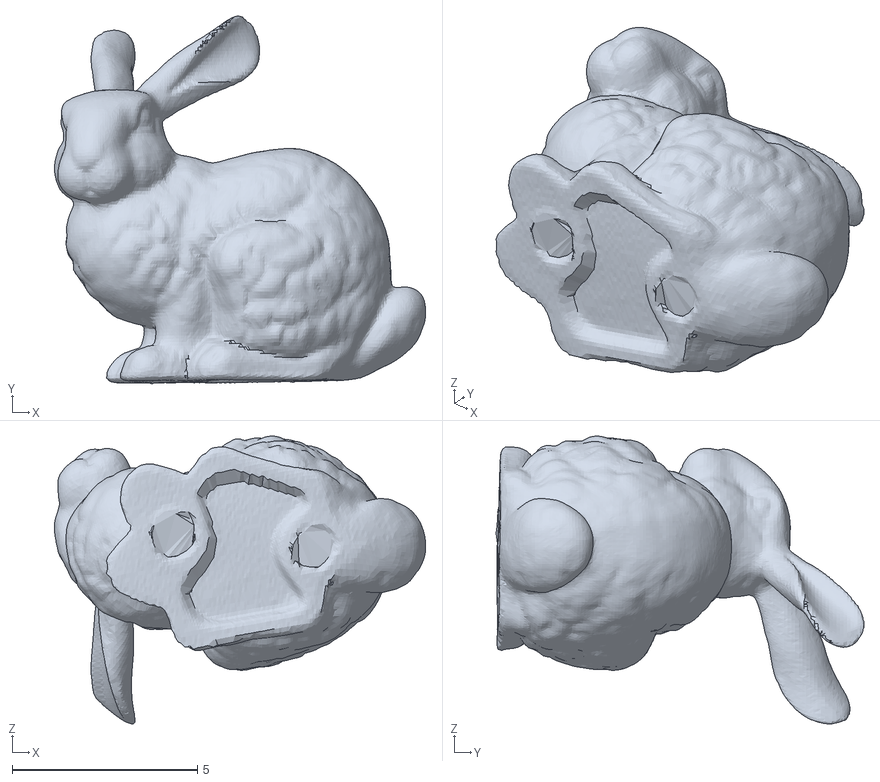
[picture p61: CAD file, 2026-01-07]
Everything_else/Circuitpython_10_libraries/adafruit-circuitpython-bundle-10.x-mpy-20260924/examples/bno055/bno055_webgl_demo/static/bunny.obj
10.0 x 9.94 x 7.77
