paulmirel/STELLA-1/STELLA_1.2/Documentation/lab_spec_documents/LS STL print files/LS-C2 detector block for cuvette.STL

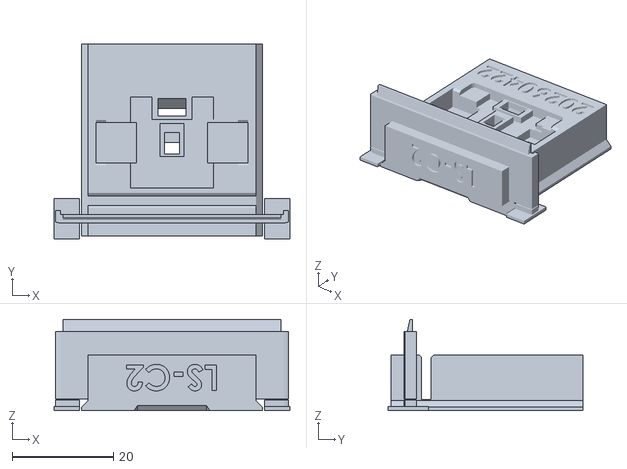
[picture p63: CAD file, 2026-04-22]
STELLA_1.2/Documentation/lab_spec_documents/LS STL print files/LS-C2 detector block for cuvette.STL
46.6 x 38.6 x 18.0
