paulmirel/STELLA-1/STELLA_1.2/Documentation/S12_print_parts/S12 aux sensor retainer.STL

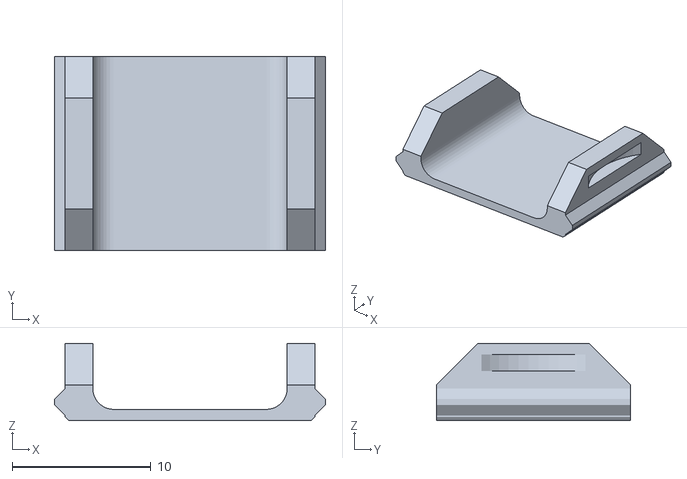
[picture p64: CAD file, 2025-10-20]
STELLA_1.2/Documentation/S12_print_parts/S12 aux sensor retainer.STL
19.5 x 14.0 x 5.55
