paulmirel/STELLA-1/STELLA_1.2/Documentation/fixture_print_parts/led2 stencil fixture.STL

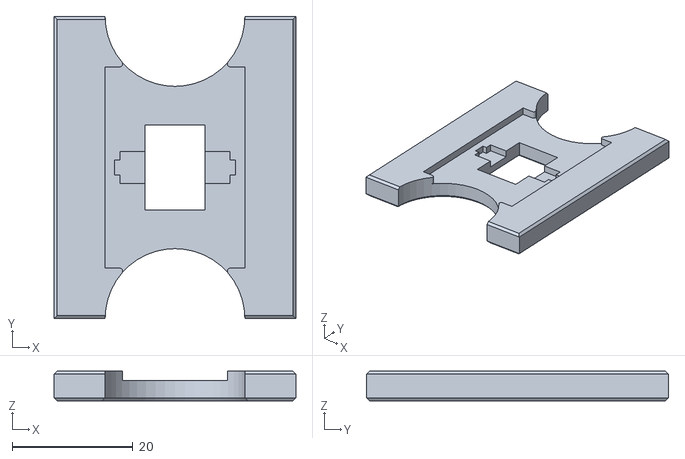
[picture p65: CAD file, 2026-04-19]
STELLA_1.2/Documentation/fixture_print_parts/led2 stencil fixture.STL
40.0 x 50.0 x 4.90
