paulmirel/STELLA-1/STELLA_1.2/Documentation/lab_spec_documents/LS STL print files/led2 dip pins fixture.STL

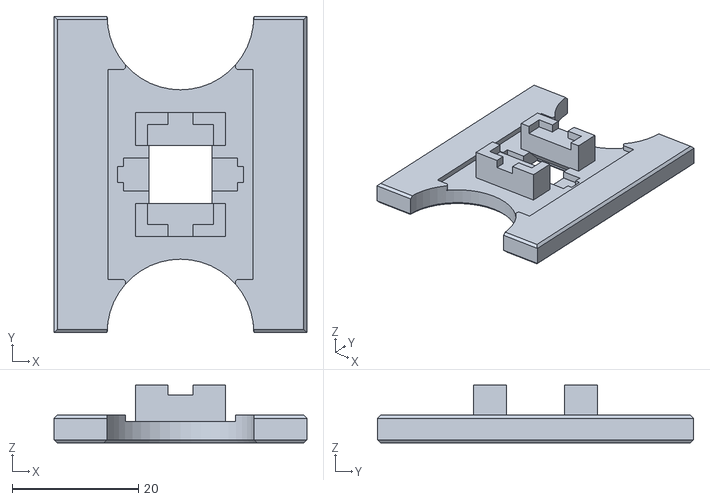
[picture p66: CAD file, 2026-04-19]
STELLA_1.2/Documentation/lab_spec_documents/LS STL print files/led2 dip pins fixture.STL
40.0 x 50.0 x 9.15
