paulmirel/STELLA-1/STELLA_1.2/Documentation/S12_print_parts/S12 sd card swing door.STL

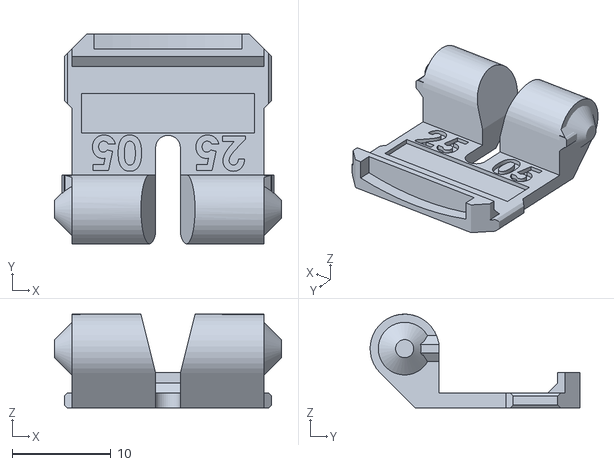
[picture p67: CAD file, 2025-10-20]
STELLA_1.2/Documentation/S12_print_parts/S12 sd card swing door.STL
23.0 x 21.2 x 9.50
