paulmirel/STELLA-1/STELLA_1.2/Documentation/lab_spec_documents/LS STL print files/LS-C2 cuvette swing lid.STL

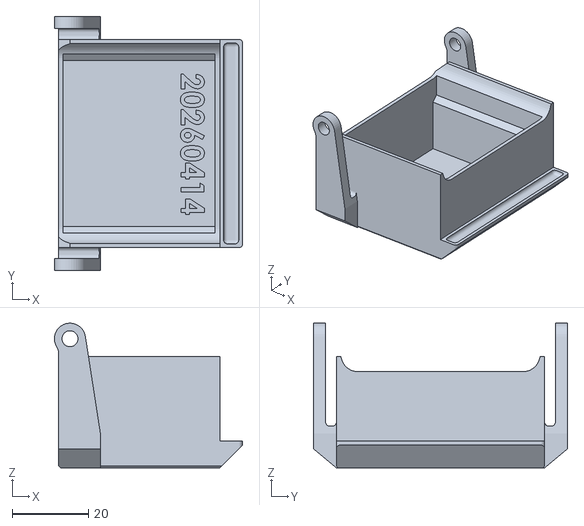
[picture p68: CAD file, 2026-04-19]
STELLA_1.2/Documentation/lab_spec_documents/LS STL print files/LS-C2 cuvette swing lid.STL
49.5 x 66.8 x 38.0
