paulmirel/STELLA-1/STELLA_1.2/Documentation/S12_print_parts/S12 GPS window color change at 0.4 and 0.8 and 1.5.STL

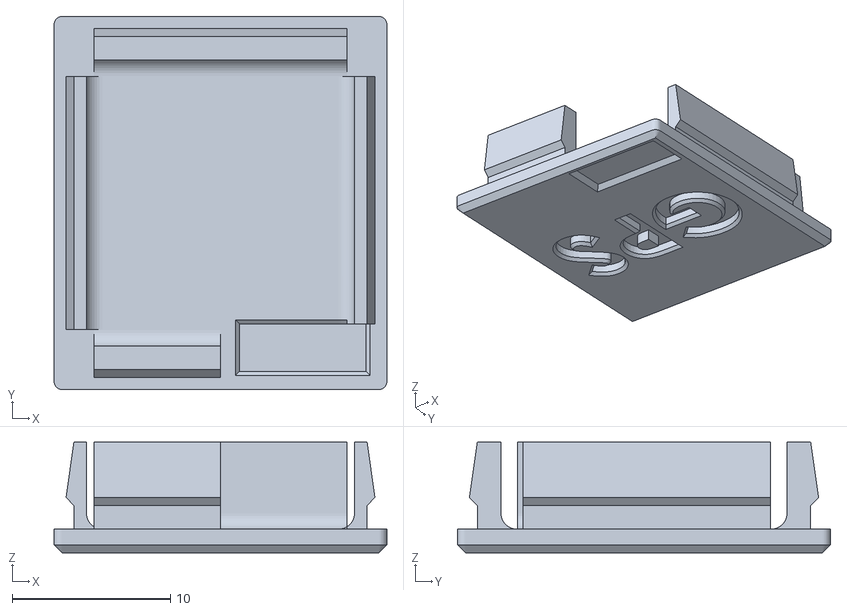
[picture p69: CAD file, 2025-10-20]
STELLA_1.2/Documentation/S12_print_parts/S12 GPS window color change at 0.4 and 0.8 and 1.5.STL
21.1 x 23.6 x 7.00
