paulmirel/STELLA-1/STELLA_1.2/Documentation/lab_spec_documents/LS STL print files/LS-P2 end cover.STL

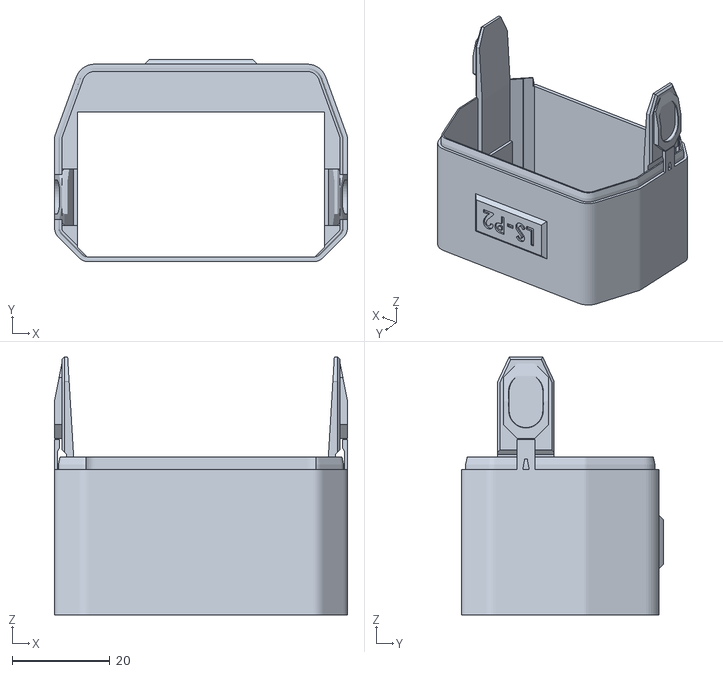
[picture p70: CAD file, 2026-04-19]
STELLA_1.2/Documentation/lab_spec_documents/LS STL print files/LS-P2 end cover.STL
60.0 x 41.5 x 52.8
