paulmirel/STELLA-1/STELLA_1.2/Documentation/S12_print_parts/S12 sdcard alignment fixture.STL

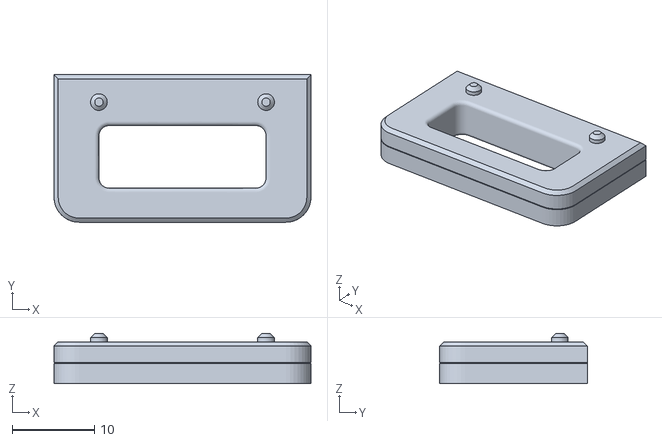
[picture p71: CAD file, 2025-10-20]
STELLA_1.2/Documentation/S12_print_parts/S12 sdcard alignment fixture.STL
31.2 x 17.9 x 6.10
