paulmirel/STELLA-1/STELLA_1.2/Documentation/S12_print_parts/S12 tail lights window change color at 0.4 and 0.8 and 1.5.STL

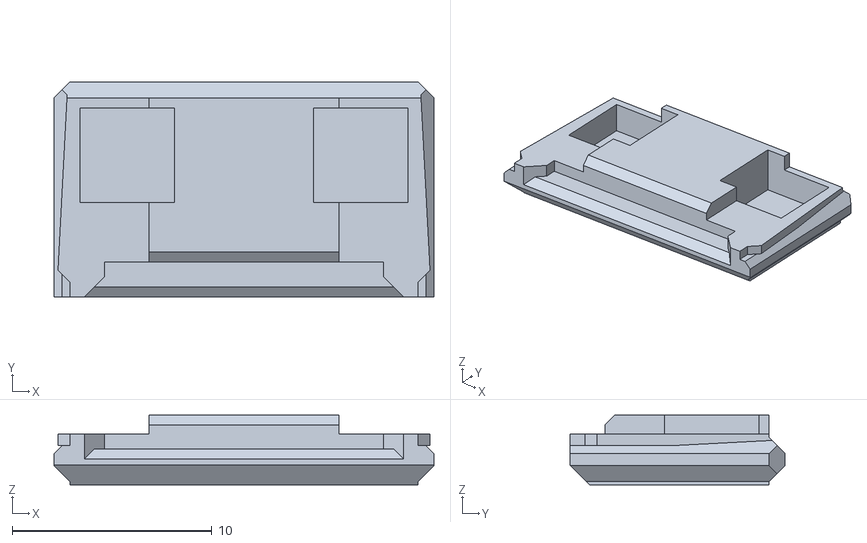
[picture p72: CAD file, 2025-10-20]
STELLA_1.2/Documentation/S12_print_parts/S12 tail lights window change color at 0.4 and 0.8 and 1.5.STL
19.0 x 10.8 x 3.50
