paulmirel/STELLA-1/STELLA_1.2/Documentation/lab_spec_documents/LS STL print files/LS-C2 cuvette block.STL

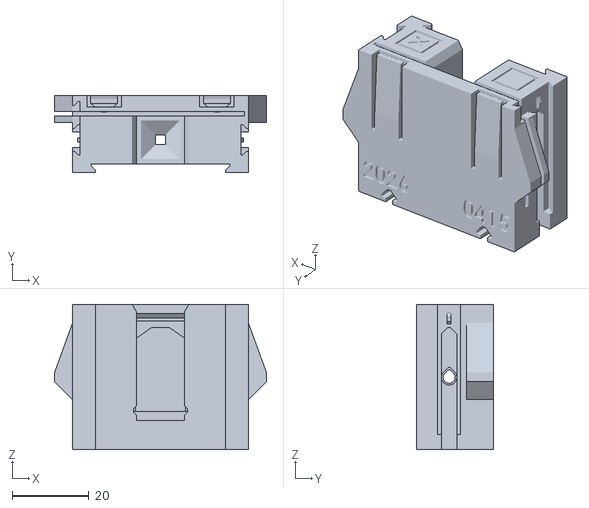
[picture p73: CAD file, 2026-04-18]
STELLA_1.2/Documentation/lab_spec_documents/LS STL print files/LS-C2 cuvette block.STL
55.4 x 20.0 x 38.0
