paulmirel/STELLA-1/STELLA_1.2/Documentation/S12_print_parts/S12 lower housing.STL

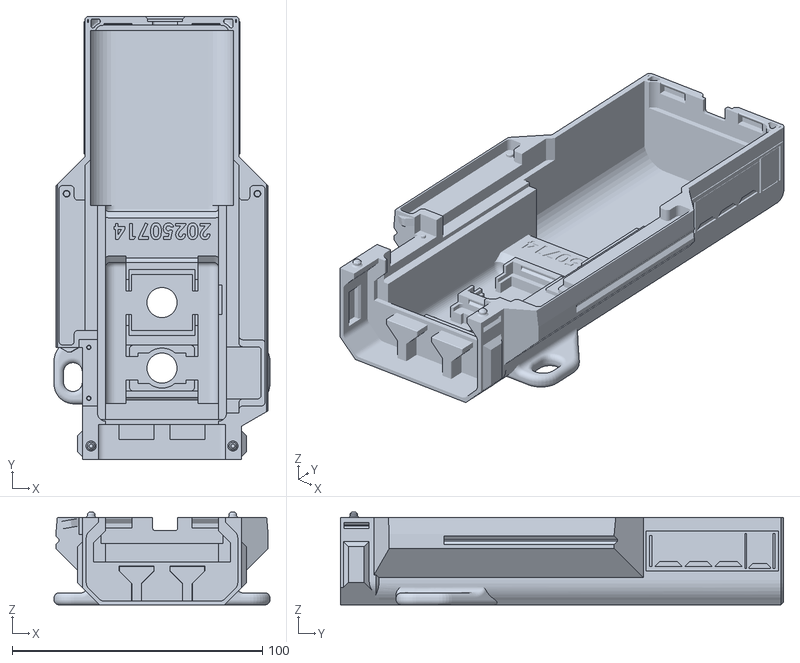
[picture p74: CAD file, 2025-10-20]
STELLA_1.2/Documentation/S12_print_parts/S12 lower housing.STL
86.2 x 177.0 x 37.0
