paulmirel/STELLA-1/STELLA_1.2/Documentation/lab_spec_documents/LS STL print files/LS-P2 sensor retainer.STL

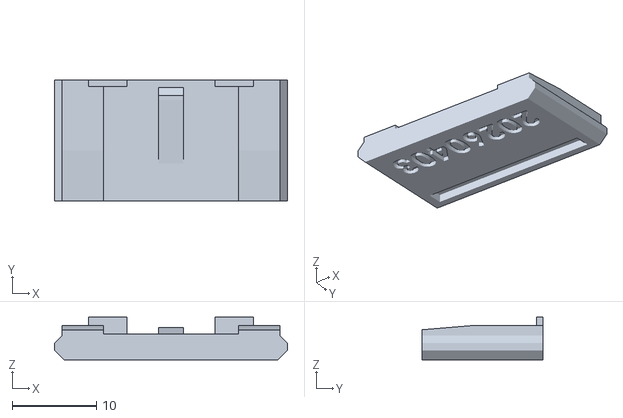
[picture p75: CAD file, 2026-04-18]
STELLA_1.2/Documentation/lab_spec_documents/LS STL print files/LS-P2 sensor retainer.STL
27.6 x 14.4 x 5.06
