paulmirel/STELLA-1/STELLA_1.2/Documentation/S12_print_parts/S12 qwiic buzzer retainer.STL

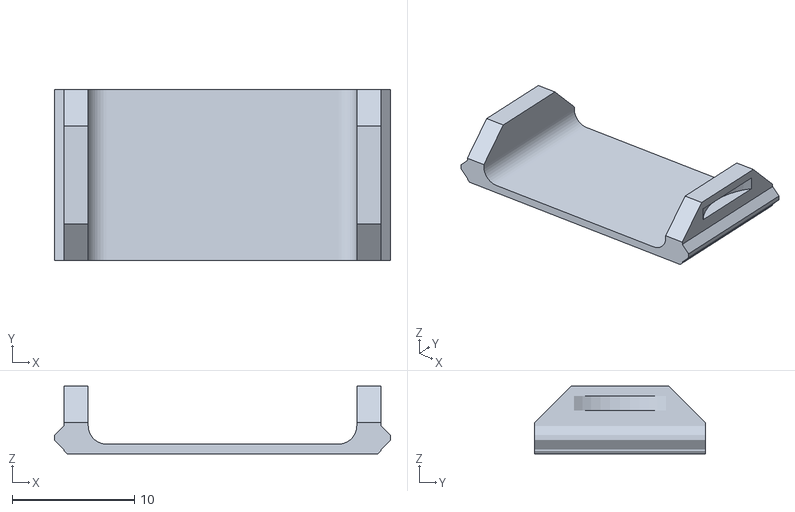
[picture p76: CAD file, 2025-10-20]
STELLA_1.2/Documentation/S12_print_parts/S12 qwiic buzzer retainer.STL
27.5 x 14.0 x 5.55
