paulmirel/STELLA-1/STELLA_1.2/Documentation/lab_spec_documents/LS STL print files/LS-C2 blackout shutter.STL

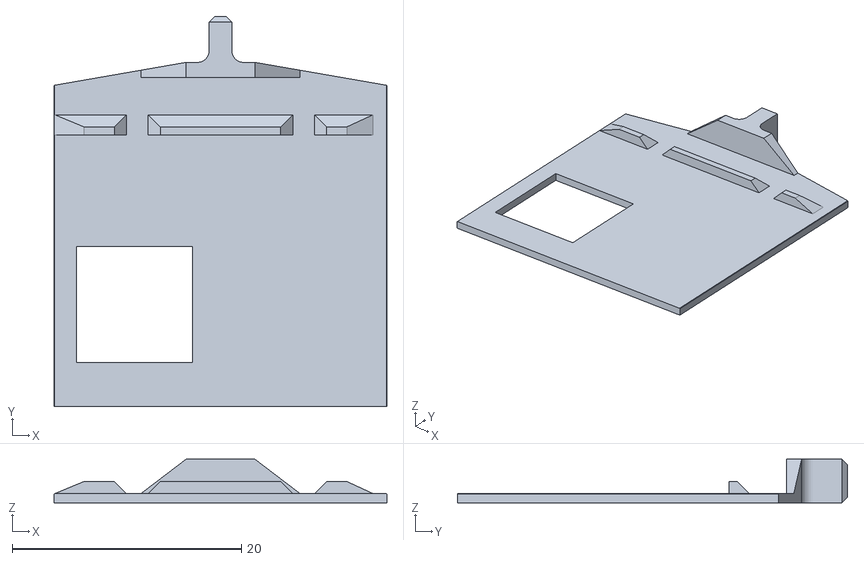
[picture p77: CAD file, 2026-04-18]
STELLA_1.2/Documentation/lab_spec_documents/LS STL print files/LS-C2 blackout shutter.STL
29.0 x 34.0 x 3.80
