paulmirel/STELLA-1/STELLA_1.2/Documentation/S12_print_parts/S12 REC window change color at 0.4 and 0.8 and 1.5.STL

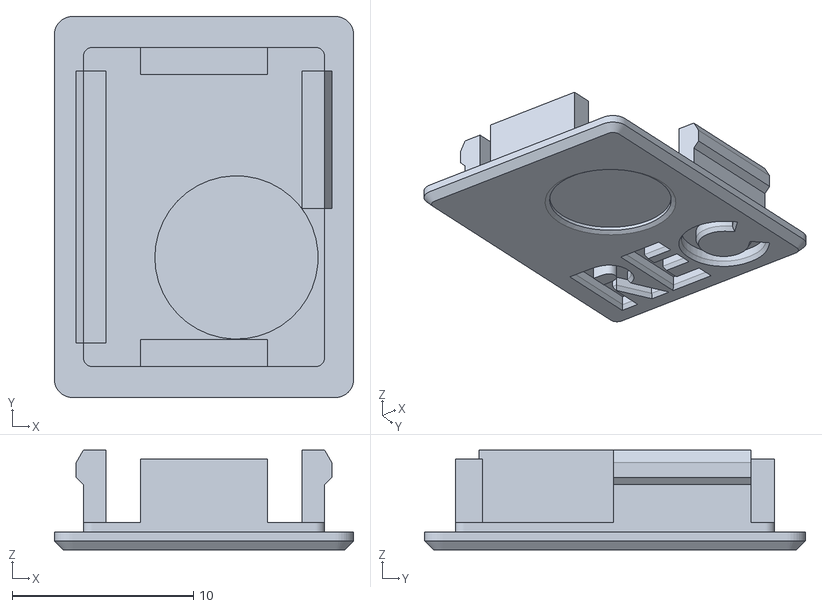
[picture p78: CAD file, 2025-10-20]
STELLA_1.2/Documentation/S12_print_parts/S12 REC window change color at 0.4 and 0.8 and 1.5.STL
16.5 x 21.0 x 5.50
