paulmirel/STELLA-1/STELLA_1.2/Documentation/lab_spec_documents/LS STL print files/LS_housing_base.STL

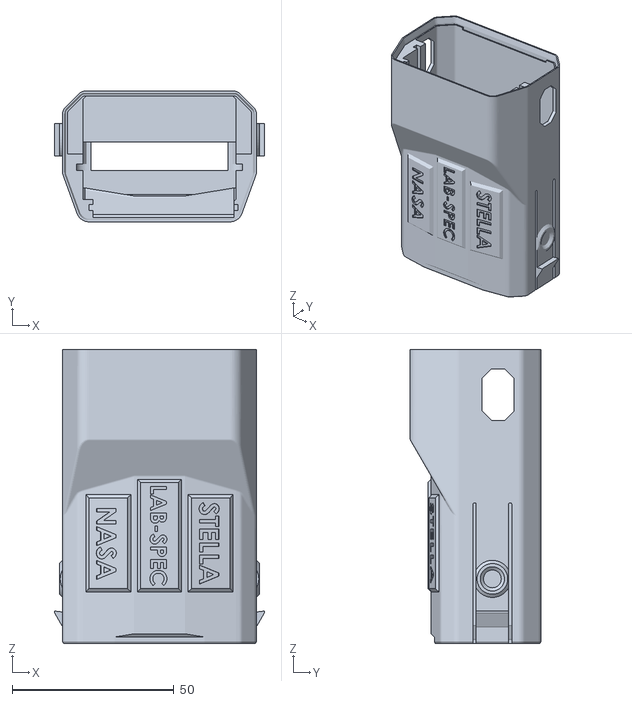
[picture p79: CAD file, 2026-04-18]
STELLA_1.2/Documentation/lab_spec_documents/LS STL print files/LS_housing_base.STL
65.0 x 40.5 x 91.0
