paulmirel/STELLA-1/STELLA_1.2/Documentation/S12_print_parts/S12 QT alignment fixture.STL

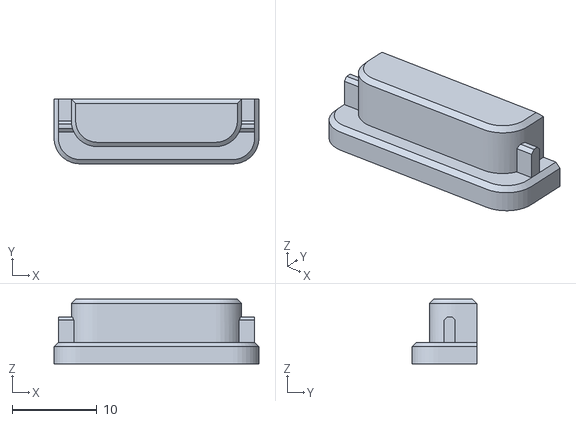
[picture p80: CAD file, 2025-10-20]
STELLA_1.2/Documentation/S12_print_parts/S12 QT alignment fixture.STL
24.1 x 7.62 x 7.62
