paulmirel/STELLA-1/STELLA_1.2/Documentation/lab_spec_documents/LS STL print files/LS-C2 cuvette pedestal.STL

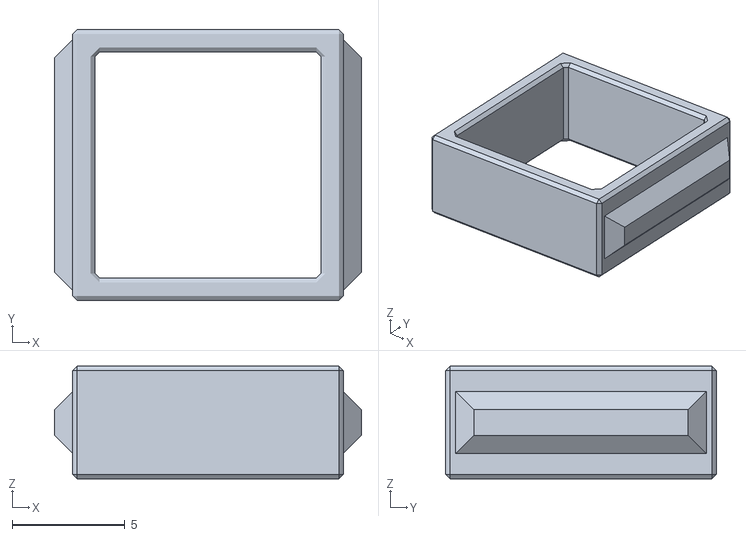
[picture p81: CAD file, 2026-04-18]
STELLA_1.2/Documentation/lab_spec_documents/LS STL print files/LS-C2 cuvette pedestal.STL
13.6 x 12.0 x 5.00
