paulmirel/STELLA-1/STELLA_1.2/Documentation/S12_print_parts/S12 battery spacer.STL

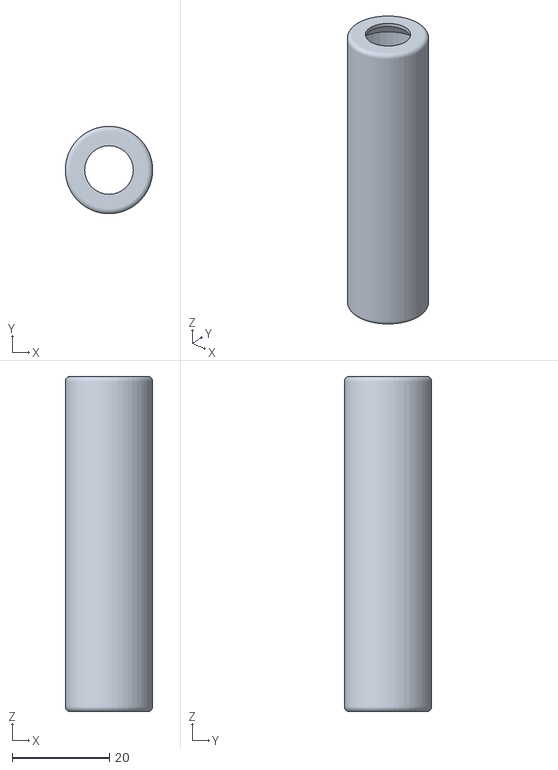
[picture p82: CAD file, 2025-10-20]
STELLA_1.2/Documentation/S12_print_parts/S12 battery spacer.STL
18.0 x 18.0 x 69.0
