paulmirel/STELLA-1/STELLA_1.2/Documentation/lab_spec_documents/LS STL print files/LS-P2 hinge pin.STL

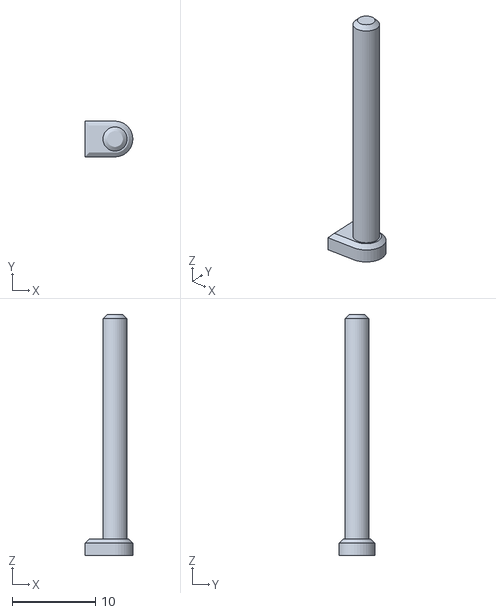
[picture p84: CAD file, 2026-04-18]
STELLA_1.2/Documentation/lab_spec_documents/LS STL print files/LS-P2 hinge pin.STL
5.75 x 4.30 x 29.0
