paulmirel/STELLA-1/STELLA_1.2/Documentation/S12_print_parts/S12 UID side tag change color at 1.6.STL

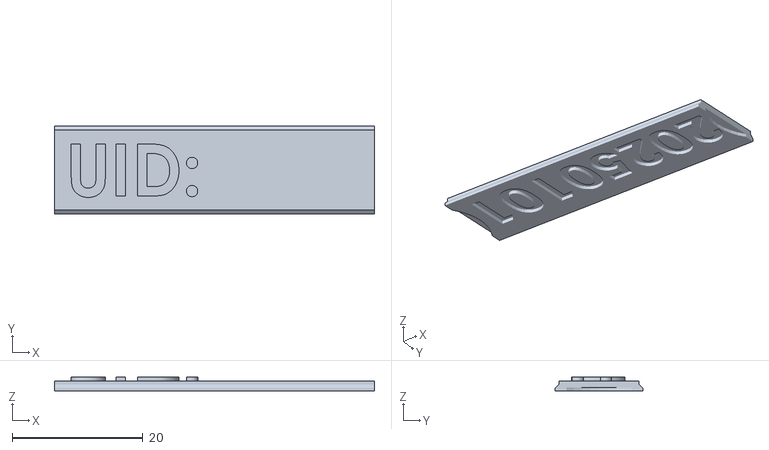
[picture p85: CAD file, 2025-10-20]
STELLA_1.2/Documentation/S12_print_parts/S12 UID side tag change color at 1.6.STL
49.0 x 13.5 x 2.10
