paulmirel/STELLA-1/STELLA_1.2/Documentation/lab_spec_documents/LS STL print files/LS-P2 test position - triple source.STL

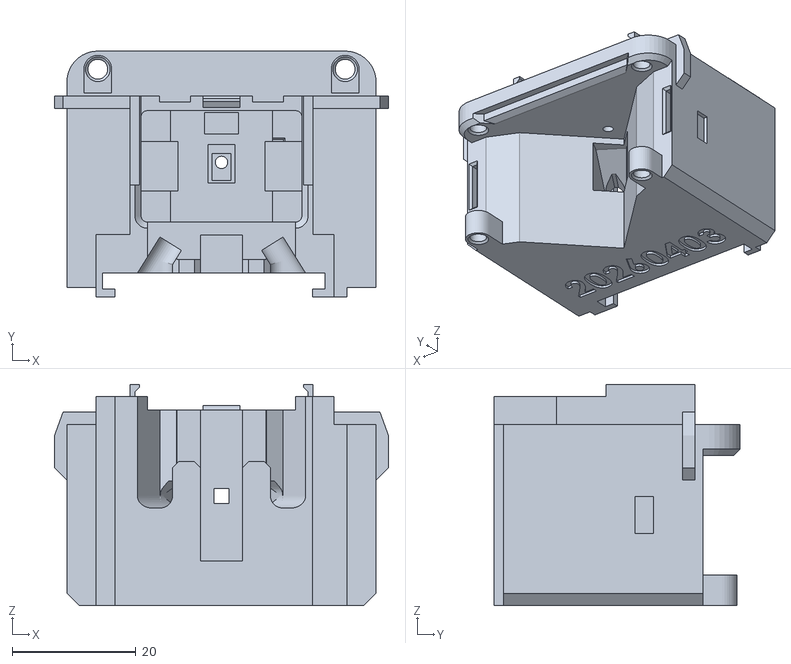
[picture p86: CAD file, 2026-04-18]
STELLA_1.2/Documentation/lab_spec_documents/LS STL print files/LS-P2 test position - triple source.STL
54.0 x 39.8 x 35.8
