paulmirel/STELLA-1/STELLA_1.2/Documentation/lab_spec_documents/LS STL print files/LS-P2 swing door.STL

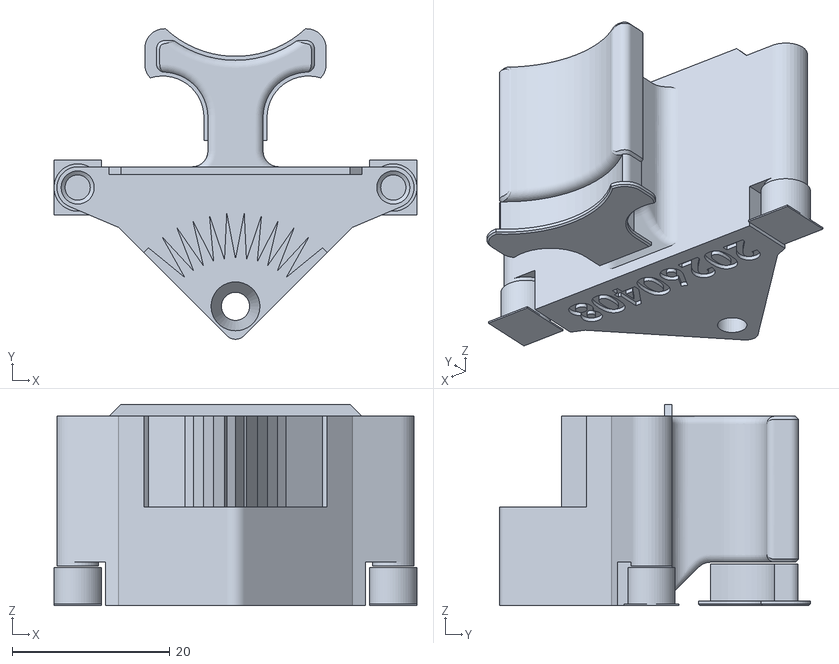
[picture p87: CAD file, 2026-04-18]
STELLA_1.2/Documentation/lab_spec_documents/LS STL print files/LS-P2 swing door.STL
46.0 x 39.4 x 25.5
