paulmirel/STELLA-1/STELLA_1.2/Documentation/lab_spec_documents/LS STL print files/LS-C2 cuvette block foot pair.STL

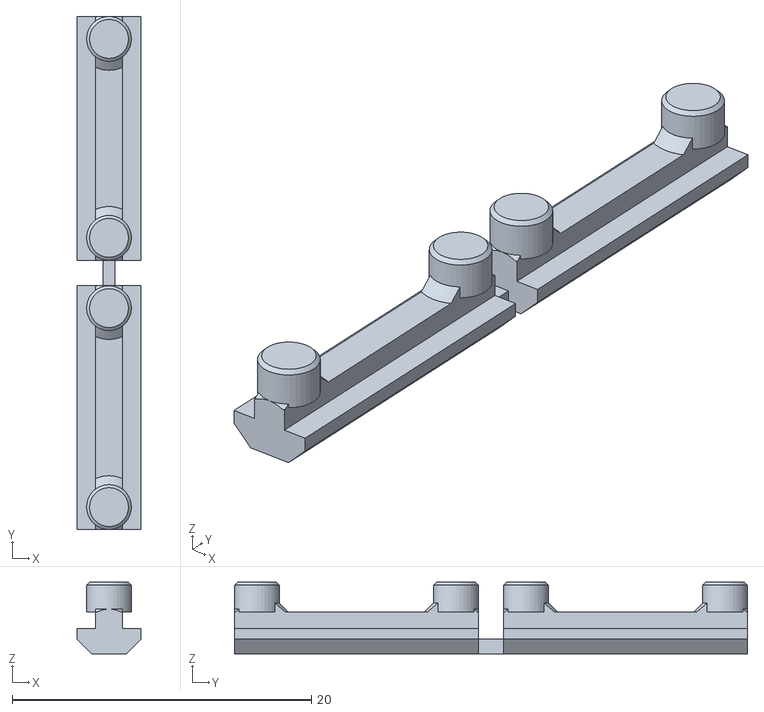
[picture p88: CAD file, 2026-04-18]
STELLA_1.2/Documentation/lab_spec_documents/LS STL print files/LS-C2 cuvette block foot pair.STL
4.30 x 34.3 x 4.80
