paulmirel/STELLA-1/STELLA_1.2/Documentation/S12_print_parts/S12 clock spacer.STL

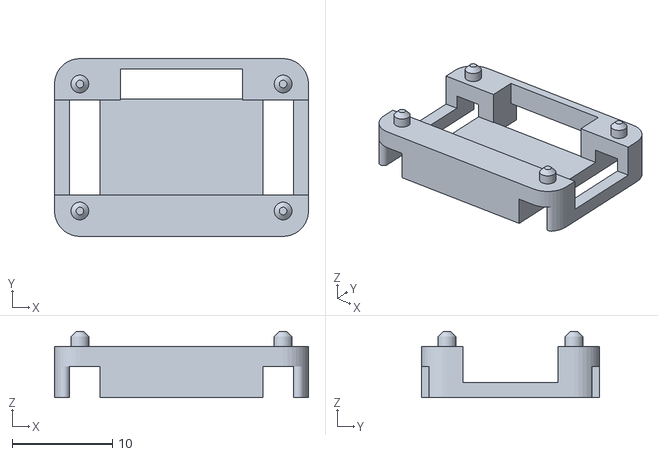
[picture p89: CAD file, 2025-10-20]
STELLA_1.2/Documentation/S12_print_parts/S12 clock spacer.STL
25.4 x 17.8 x 6.60
