paulmirel/STELLA-1/STELLA_1.2/Documentation/S12_print_parts/S12 upper housing change color at 0.8 and 1.6.STL

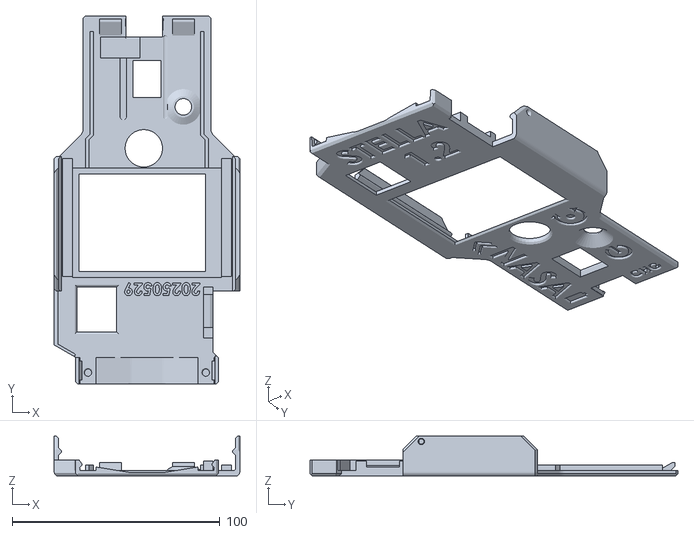
[picture p90: CAD file, 2025-10-20]
STELLA_1.2/Documentation/S12_print_parts/S12 upper housing change color at 0.8 and 1.6.STL
89.4 x 177.0 x 19.0
