paulmirel/STELLA-1/(list of files, cad)

Other CAD files:
STELLA_1.2/Documentation/fixture_print_parts/magnet coupler alignment fixture.STL
STELLA_1.2/Documentation/S12_print_parts/S12 UID side tag.STEP
STELLA_1.2/Documentation/S12_print_parts/S12 magnet coupler alignment fixture for plugins w pins.STL
