paulmirel/STELLA-1/STELLA_1.2/Documentation/STELLA-1.2-main-unit-schematic.pdf

### located off board

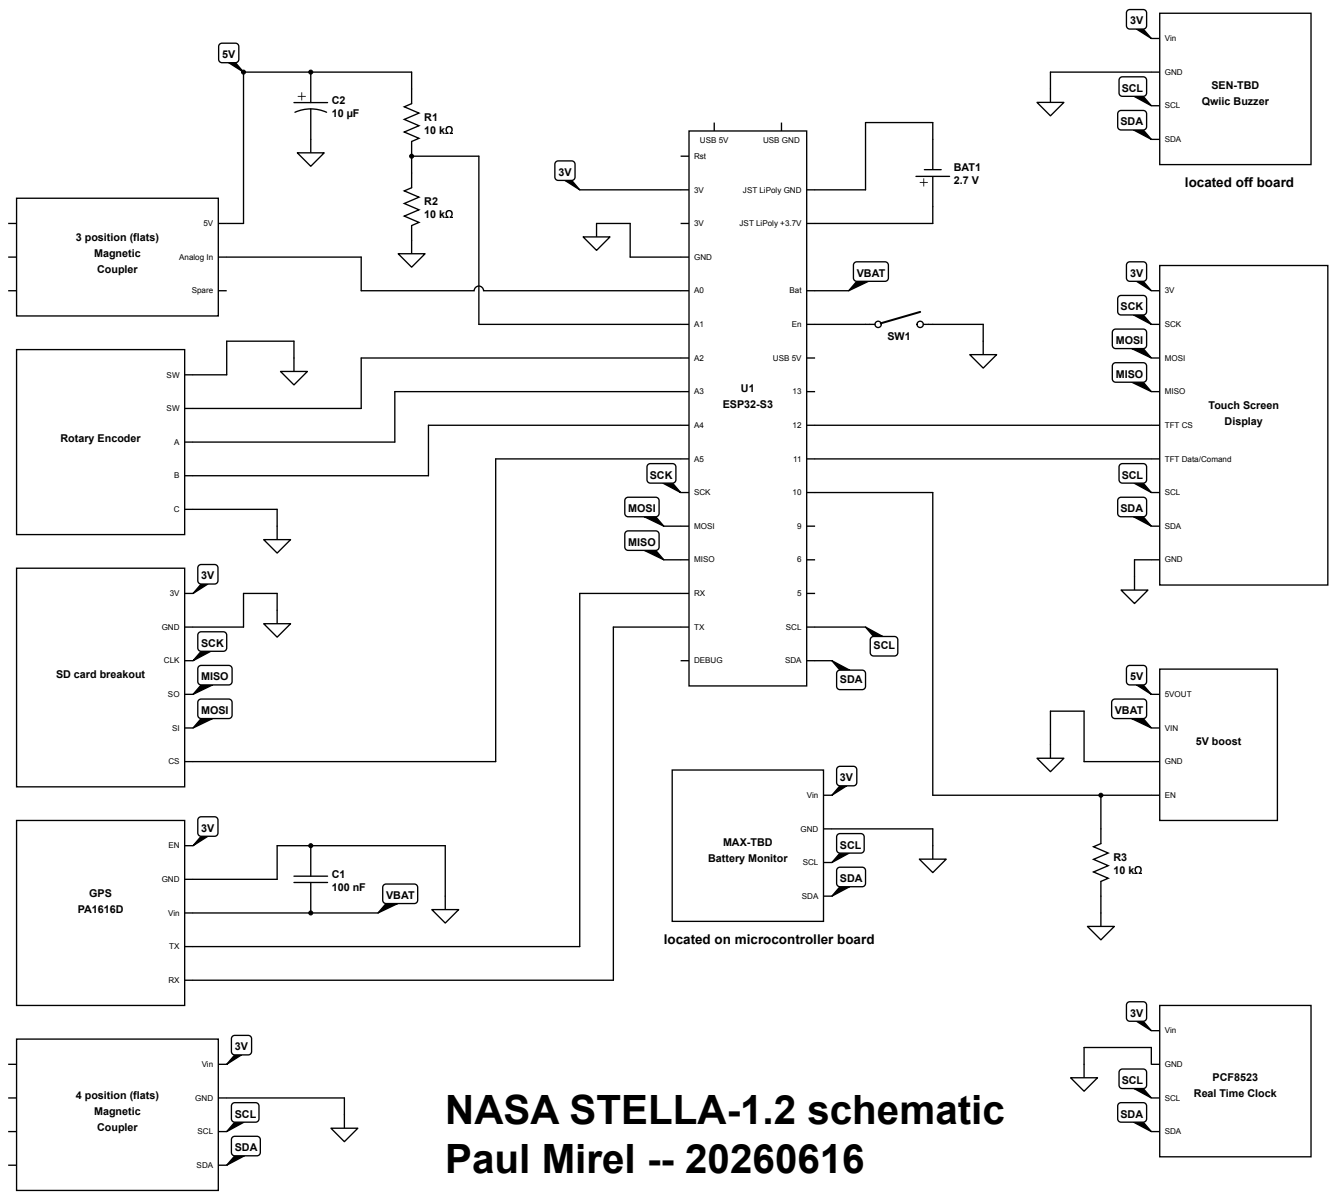
[picture p138: page 1]
SCL; ESP32-S3; Rst; GND; Bat; USB 5V; SCK; MOSI; MISO; DEBUG; SDA; USB GND; JST LiPoly +3.7V; BAT1 2.7 V; VBAT; Vin; MAX-TBD; Battery Monitor; 4 position (flats); Magnetic; Coupler; GPS; SEN-TBD; Qwiic Buzzer; 3 position (flats); Analog In; Spare; Rotary Encoder; CLK; 5V boost; VIN; 5VOUT; Touch Screen; Display; TFT CS

JST LiPoly GND

TFT Data/Comand

SD card breakout

located on microcontroller board

PCF8523
Real Time Clock

NASA STELLA-1.2 schematic
Paul Mirel -- 20260616
