paulmirel/STELLA-1/STELLA_1.2/Documentation/STELLA-1.2-remote-sensing-plugin-schematic.pdf

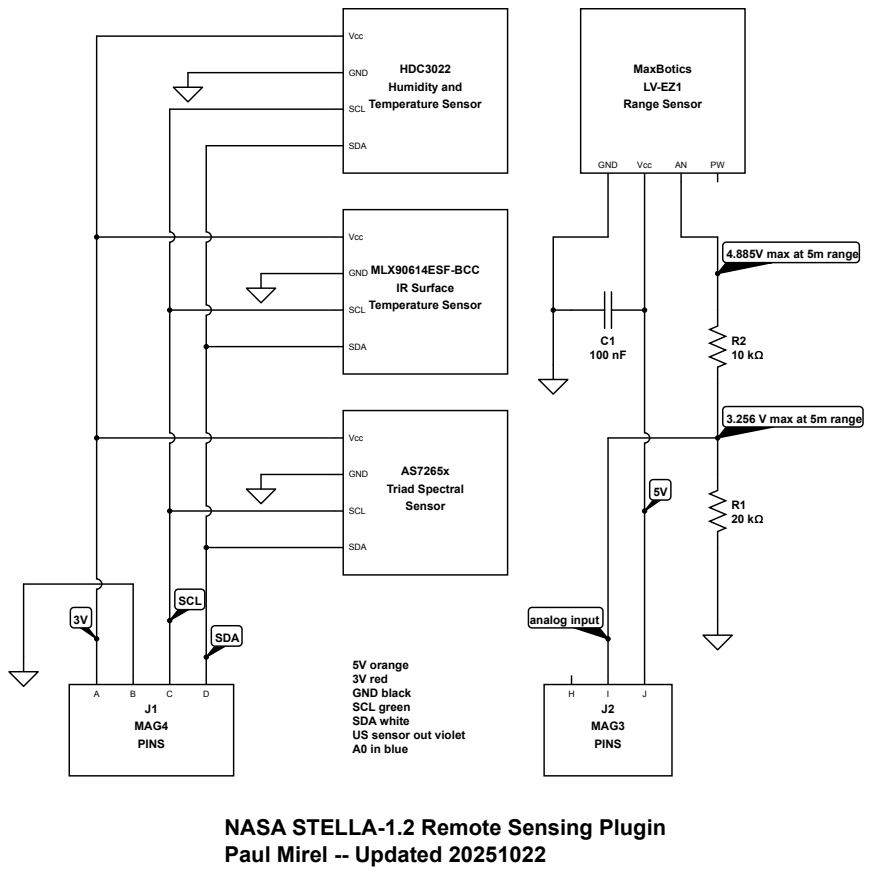
[picture p139: page 1]
MAG3; PINS; MAG4; SDA; SCL; MLX90614ESF-BCC; IR Surface; Temperature Sensor; Vcc; GND; HDC3022; Humidity and; Triad Spectral; Sensor; MaxBotics; Range Sensor; analog input

4.885V max at 5m range

3.256 V max at 5m range

5V orange
3V red
GND black
SCL green
SDA white
US sensor out violet
A0 in blue

NASA STELLA-1.2 Remote Sensing Plugin
Paul Mirel -- Updated 20251022
