paulmirel/STELLA-1/STELLA_1.2/Documentation/STELLA-1.2_main_unit_hybrid_layout_schematic.pdf

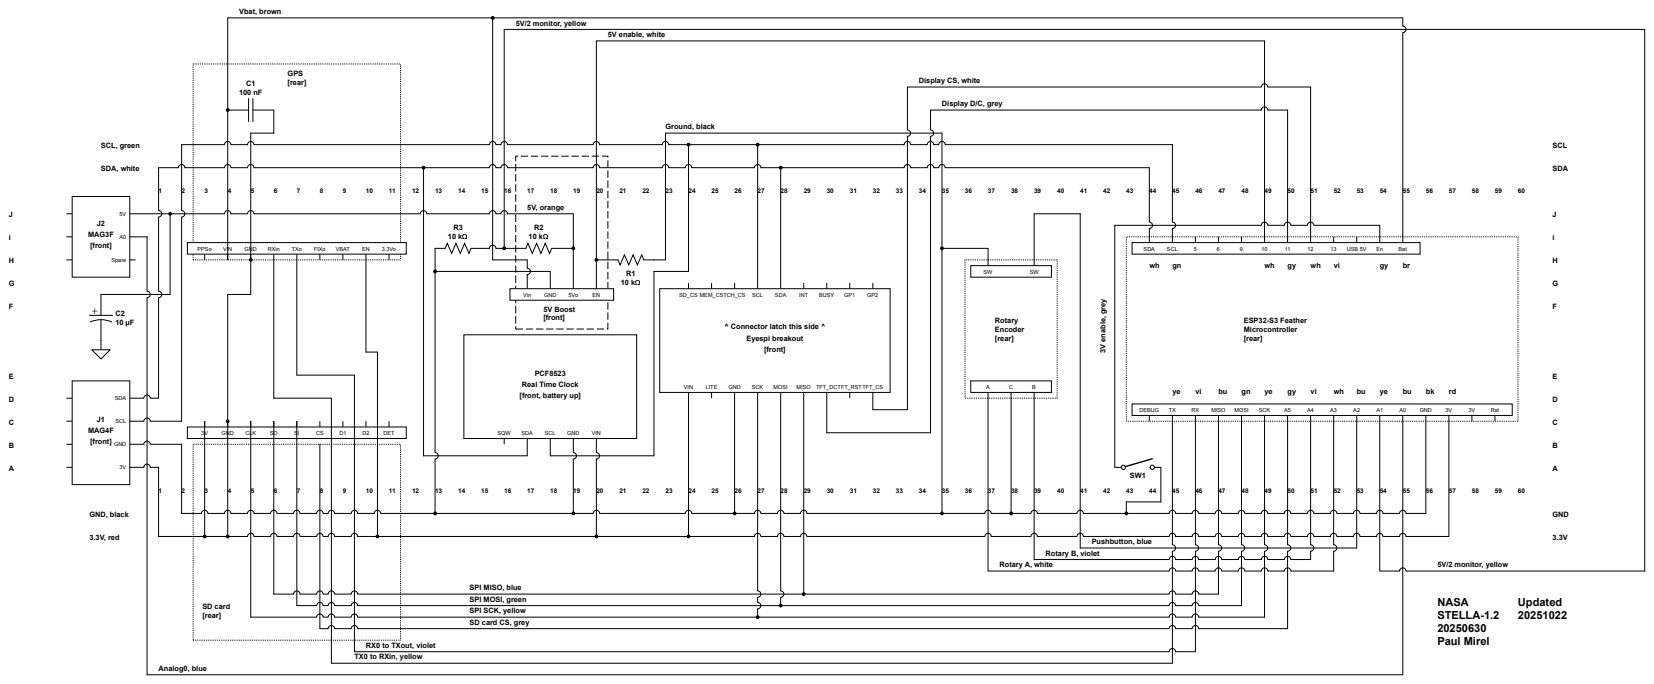
[picture p140: page 1]

^ Connector latch this side ^

SPI MISO, blue
SPI MOSI, green
SPI SCK, yellow
SD card CS, grey
