paulmirel/STELLA-1/Everything_else/z-early-designs/s12-aa-air-analyzer-plugin.pdf

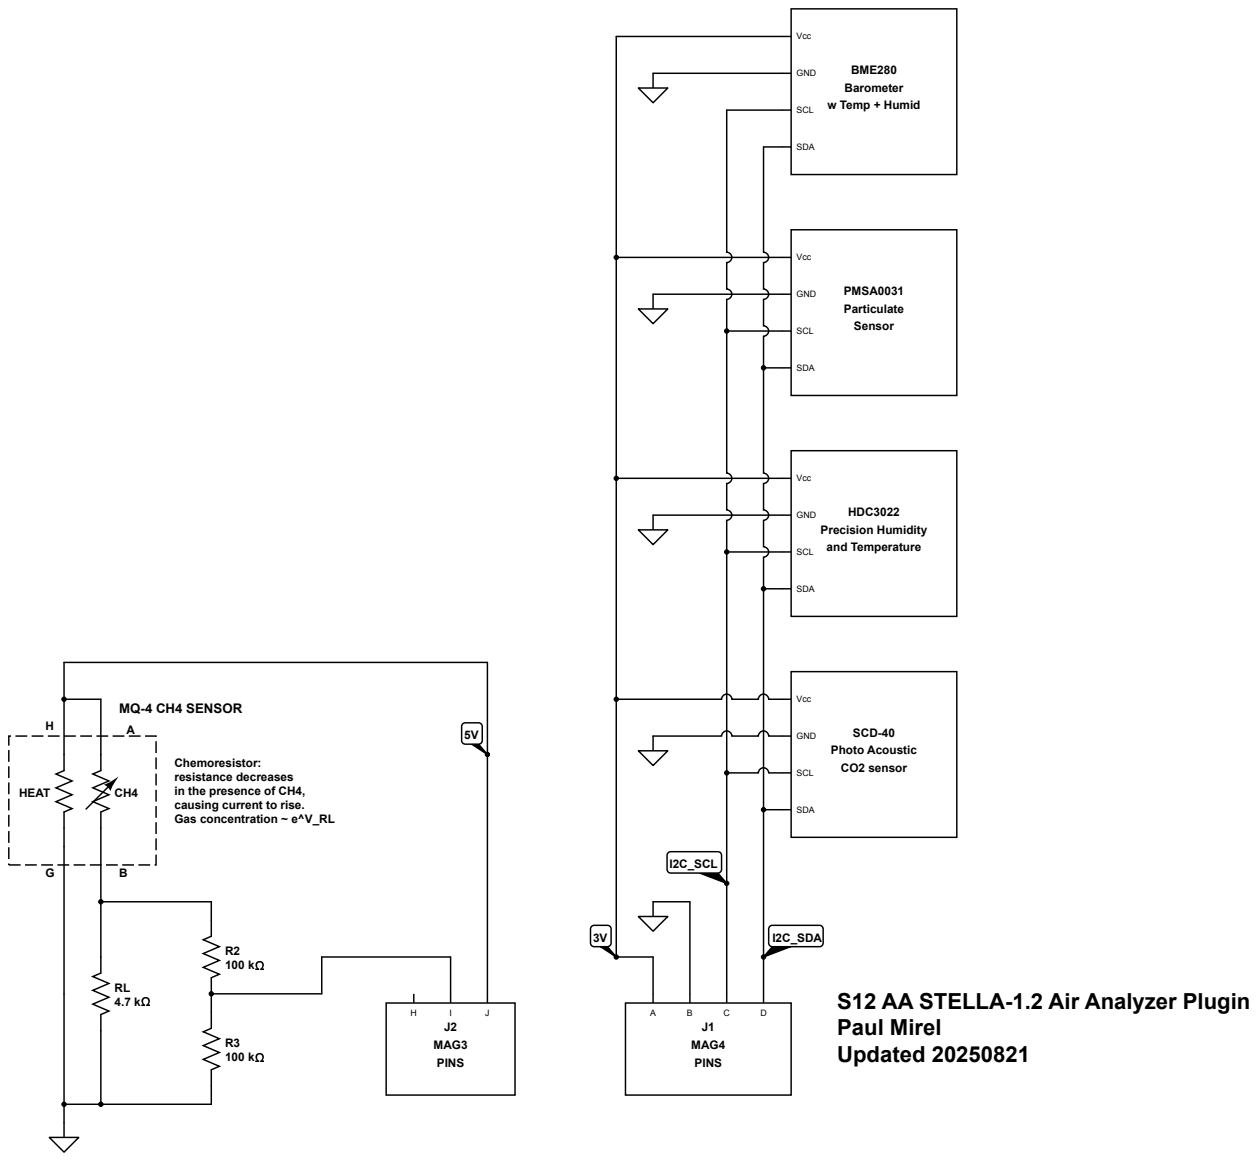
[picture p141: page 1]
MAG3; PINS; MAG4; I2C_SDA; SCD-40; Photo Acoustic; CO2 sensor; Vcc; GND; SCL; SDA; PMSA0031; Particulate; Sensor; I2C_SCL; HEAT; MQ-4 CH4 SENSOR; HDC3022; Precision Humidity; and Temperature; BME280; Barometer; w Temp + Humid

Chemoresistor:
resistance decreases
in the presence of CH4,
causing current to rise.
Gas concentration ~ e^V_RL

S12 AA STELLA-1.2 Air Analyzer Plugin
Paul Mirel
Updated 20250821
