paulmirel/STELLA-1/Everything_else/z-early-designs/s12-dls-plugin.pdf

# Lower Board

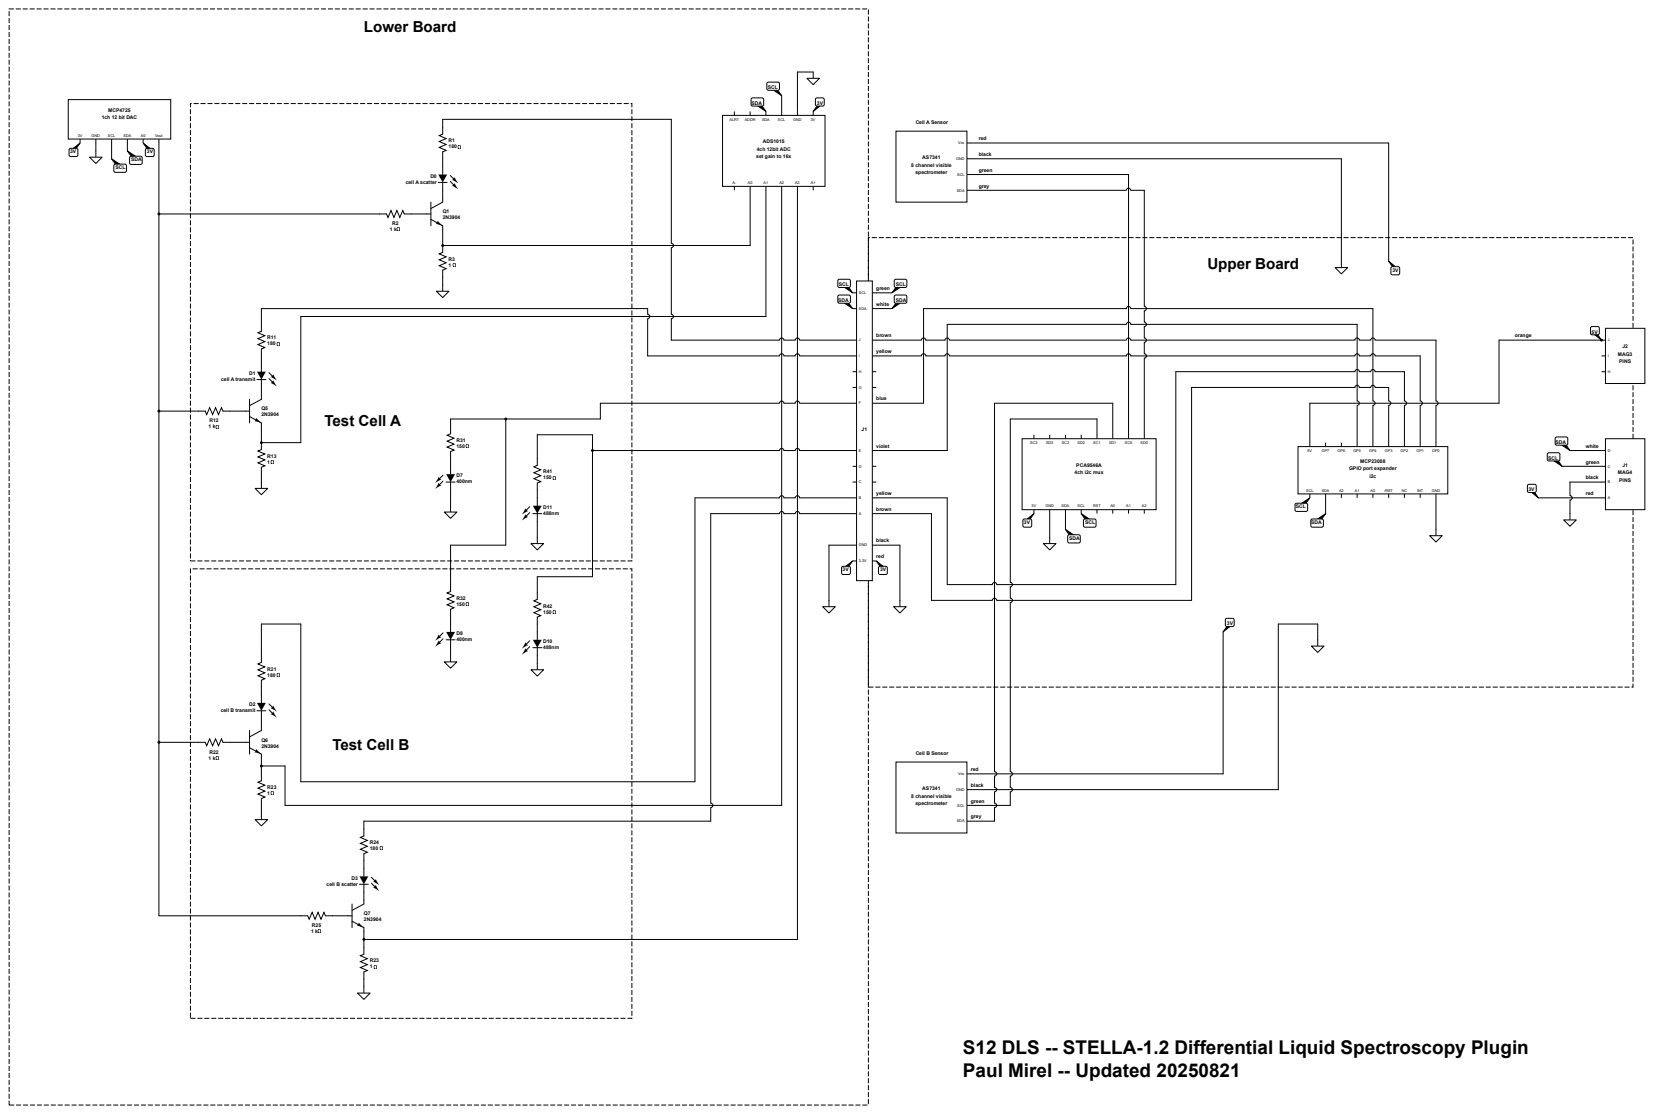
[picture p142: page 1]

S12 DLS -- STELLA-1.2 Differential Liquid Spectroscopy Plugin
Paul Mirel -- Updated 20250821
