paulmirel/STELLA-1/STELLA_1.2/Documentation/lab_spec_documents/stella-lab-spec-plugin-schematic.pdf

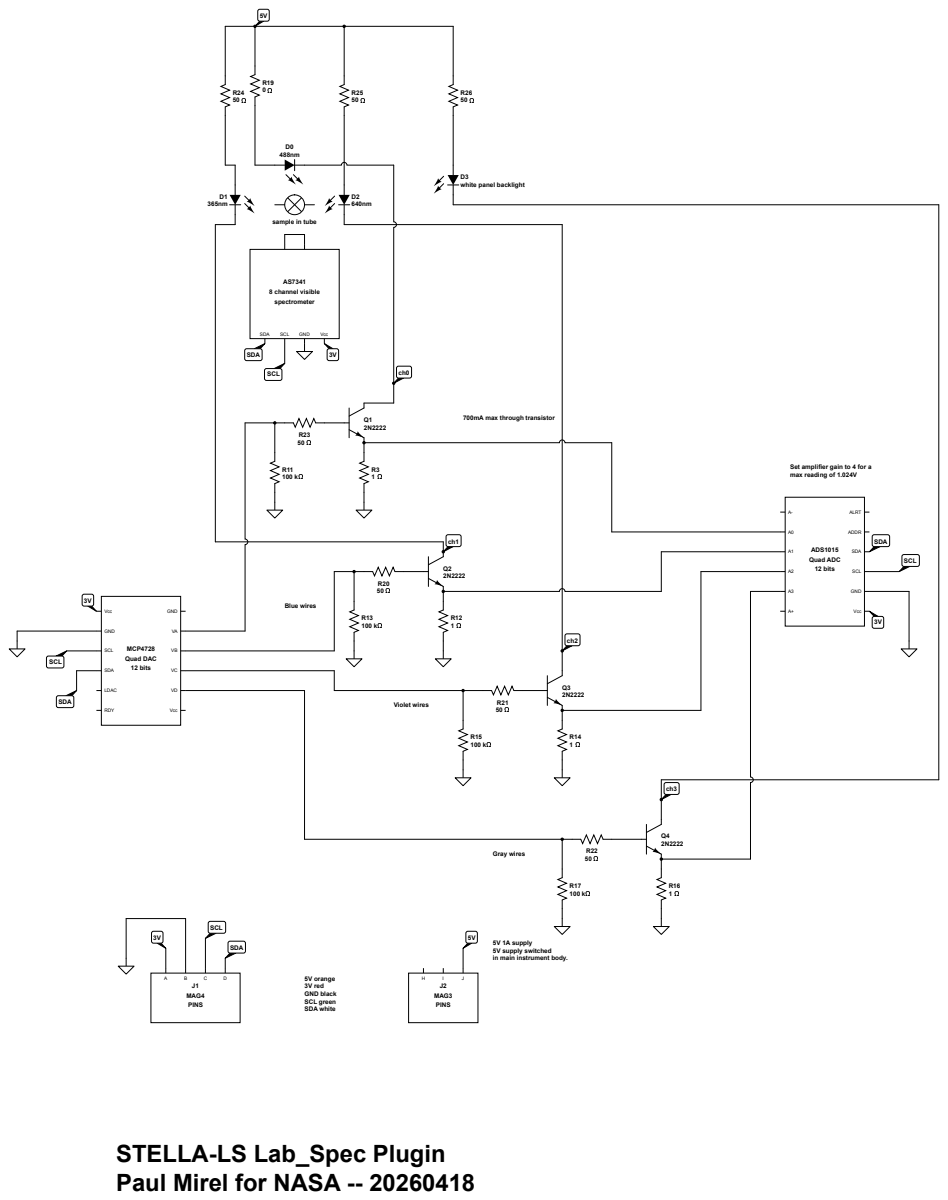
[picture p143: page 1]

Set amplifier gain to 4 for a
max reading of 1.024V

5V 1A supply
5V supply switched
in main instrument body.

STELLA-LS Lab_Spec Plugin
Paul Mirel for NASA -- 20260418
