paulmirel/STELLA-1/STELLA-1.2/lab_spec_documents/LS PDF drawings/LS - lab spec main board.pdf

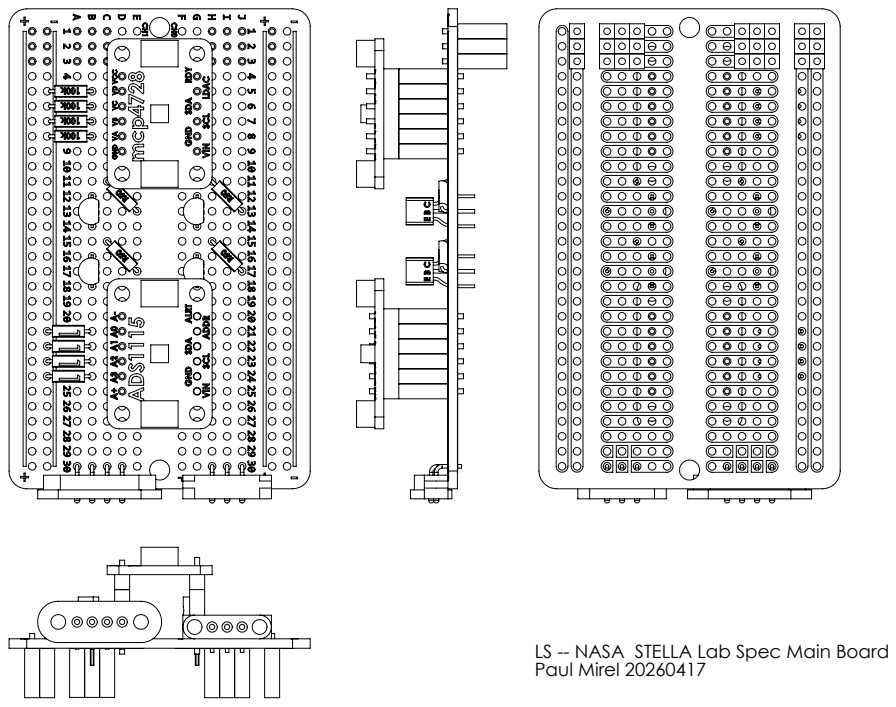
[picture p144: page 1]

LS -- NASA STELLA Lab Spec Main Board
Paul Mirel 20260417
