paulmirel/STELLA-1/STELLA-1.2/lab_spec_documents/LS PDF drawings/LS-C2 cuvette cantilever board w assembly fixture.pdf

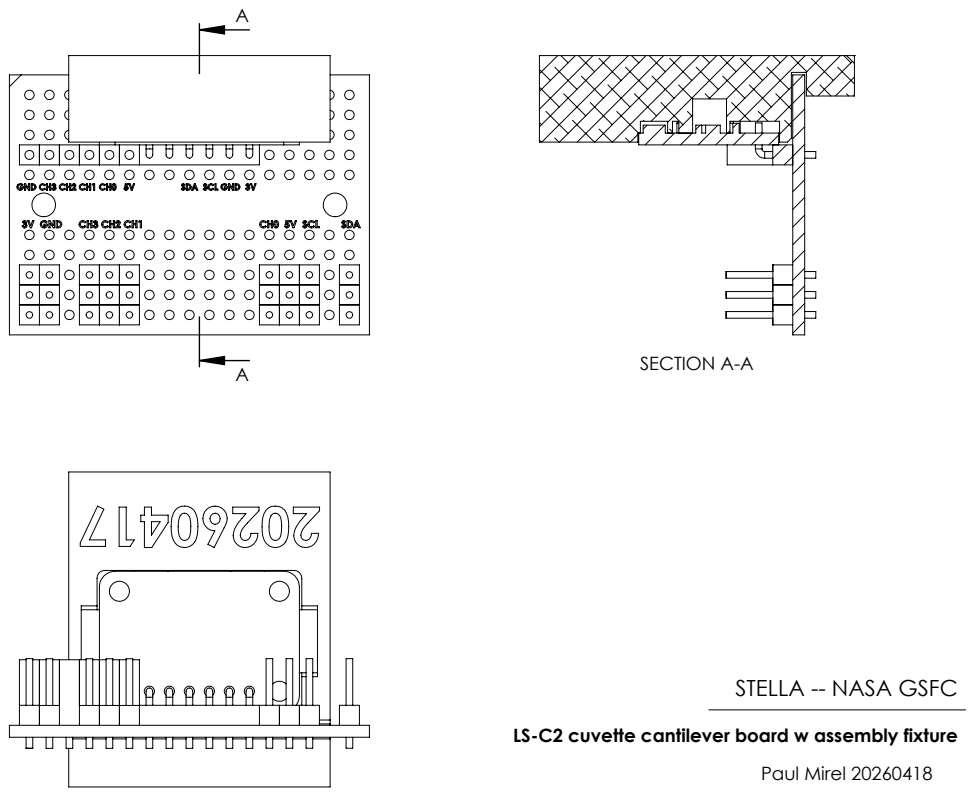
[picture p145: page 1]
SECTION A-A; Paul Mirel 20260418

STELLA -- NASA GSFC

LS-C2 cuvette cantilever board w assembly fixture
