paulmirel/STELLA-1/STELLA-1.2/lab_spec_documents/LS PDF drawings/LS-C2 cuvette drop board.pdf

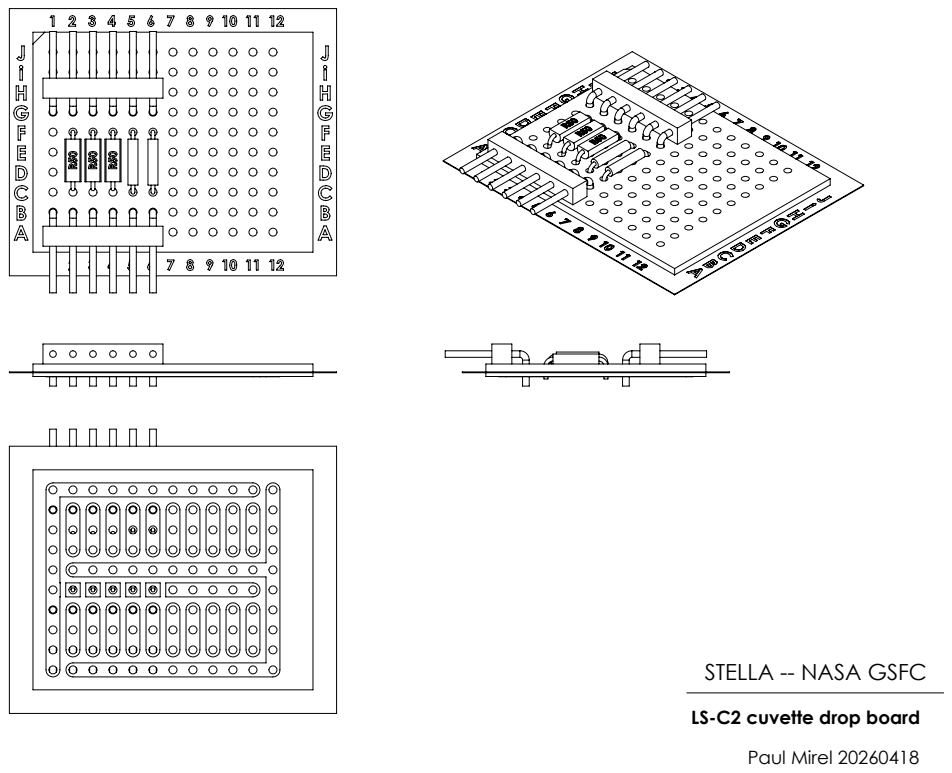
[picture p148: page 1]

STELLA -- NASA GSFC
LS-C2 cuvette drop board
Paul Mirel 20260418
