paulmirel/STELLA-1/STELLA-1.2/lab_spec_documents/LS PDF drawings/LS-C2 cuvette excitation board.pdf

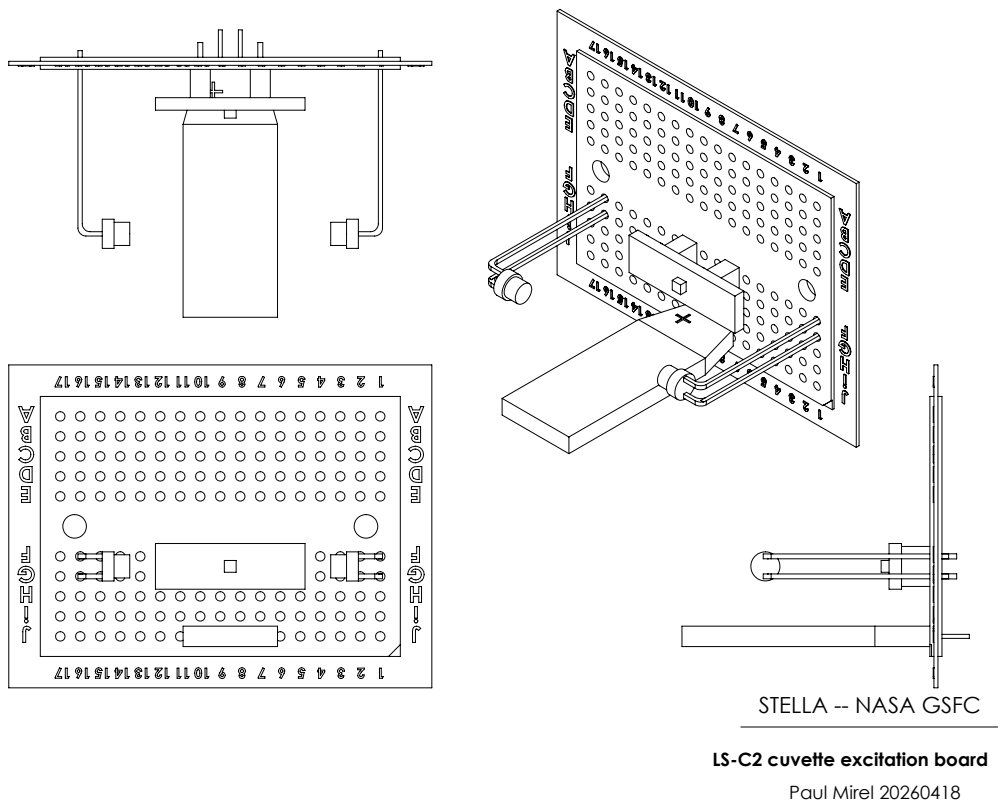
[picture p149: page 1]
Paul Mirel 20260418

STELLA -- NASA GSFC

LS-C2 cuvette excitation board
