paulmirel/STELLA-1/STELLA-1.2/lab_spec_documents/LS PDF drawings/LS-P2 cantilever board.pdf

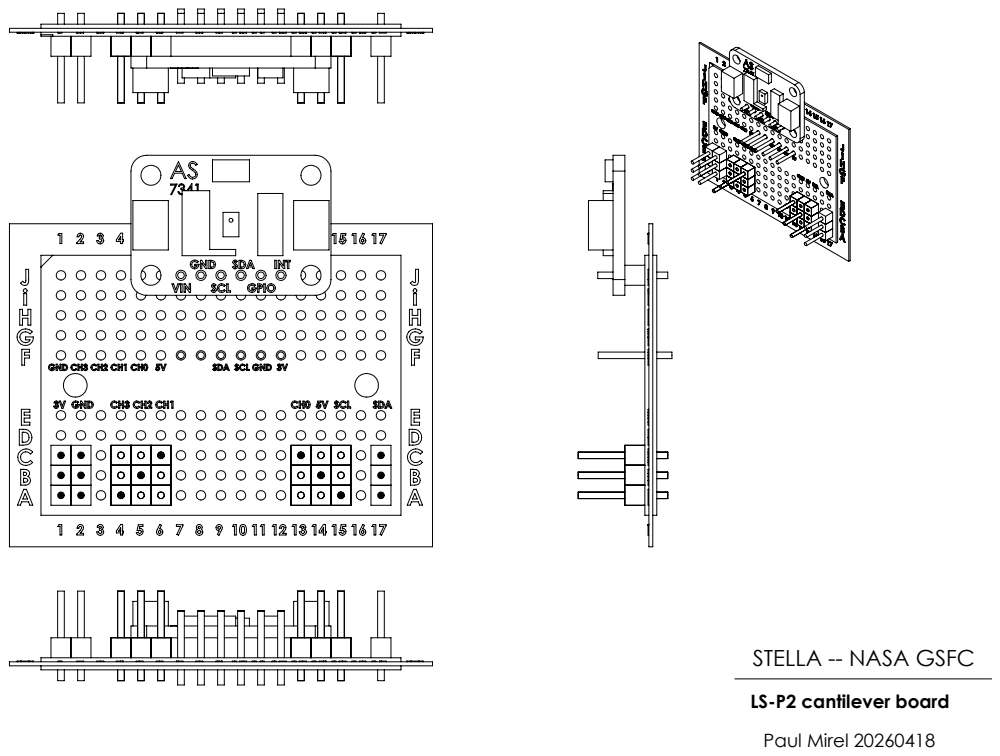
[picture p150: page 1]

STELLA -- NASA GSFC
LS-P2 cantilever board
Paul Mirel 20260418
