paulmirel/STELLA-1/STELLA-1.2/lab_spec_documents/LS PDF drawings/LS-P2 excitation board.pdf

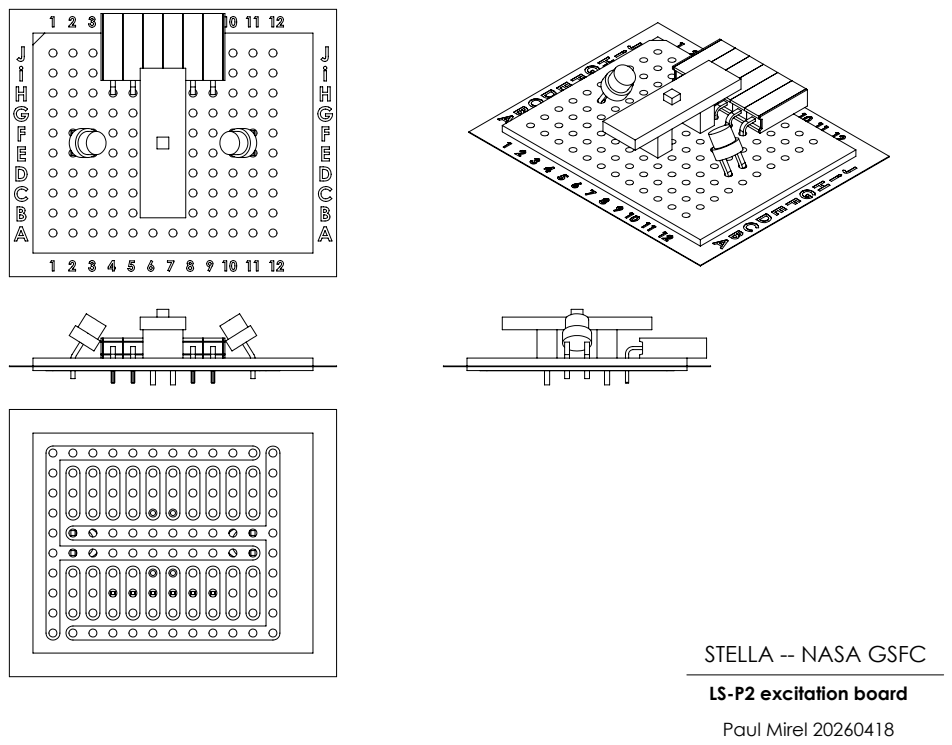
[picture p151: page 1]

STELLA -- NASA GSFC
LS-P2 excitation board
Paul Mirel 20260418
