paulmirel/STELLA-1/STELLA-1.2/lab_spec_documents/LS PDF drawings/LS-P2 optical geometry.pdf

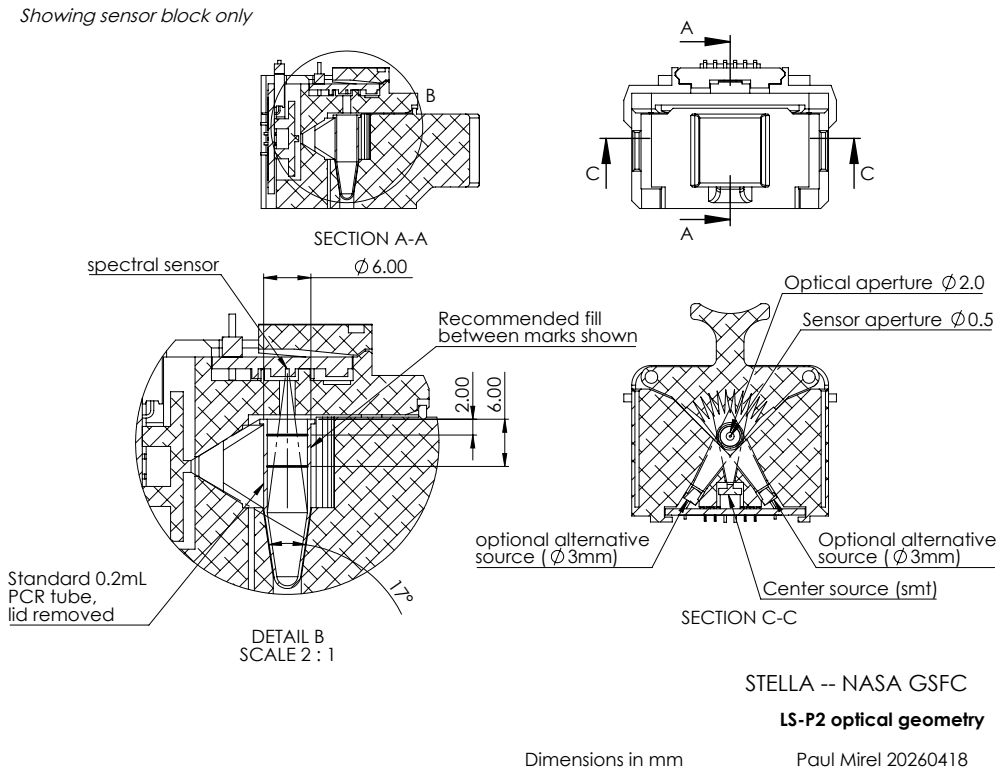
[picture p152: page 1]
SECTION A-A; DETAIL B SCALE 2 : 1; spectral sensor; SECTION C-C; optional alternative source ( 3mm); Optical aperture 2.0 Sensor aperture 0.5; Standard 0.2mL PCR tube, lid removed

Showing sensor block only

Recommended fill
between marks shown

Optional alternative
source ( 3mm)
Center source (smt)

STELLA -- NASA GSFC
LS-P2 optical geometry
Paul Mirel 20260418

Dimensions in mm
