paulmirel/STELLA-1/STELLA-1.2/lab_spec_documents/LS PDF drawings/LS-P2 sensor block board set.pdf

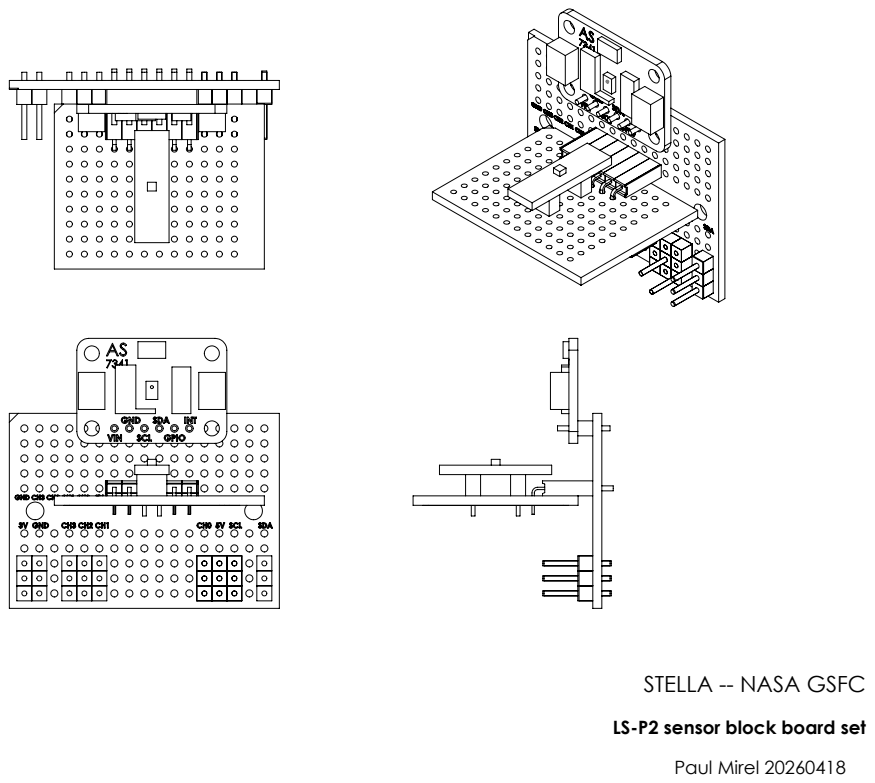
[picture p153: page 1]

STELLA -- NASA GSFC
LS-P2 sensor block board set
Paul Mirel 20260418
