paulmirel/STELLA-1/STELLA_1.2/Documentation/lab_spec_documents/C2 boards/lab spec C2 cantilever board detector join with alignment fixture.pdf

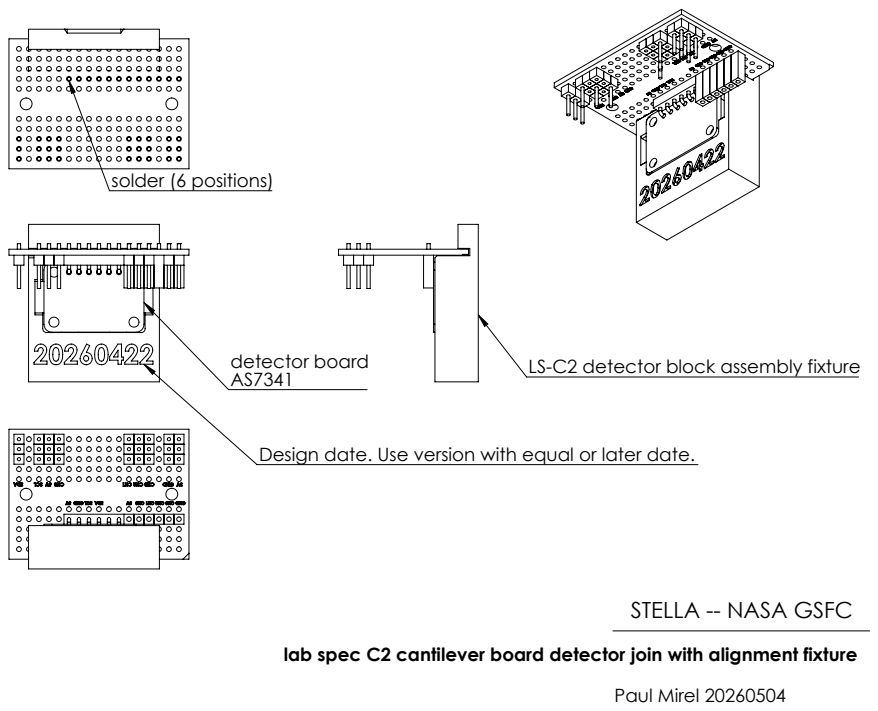
[picture p154: page 1]
detector board; solder (6 positions); Paul Mirel 20260504

LS-C2 detector block assembly fixture

Design date. Use version with equal or later date.

STELLA -- NASA GSFC

lab spec C2 cantilever board detector join with alignment fixture
