paulmirel/STELLA-1/STELLA_1.2/Documentation/lab_spec_documents/C2 boards/lab spec C2 cantilever board.pdf

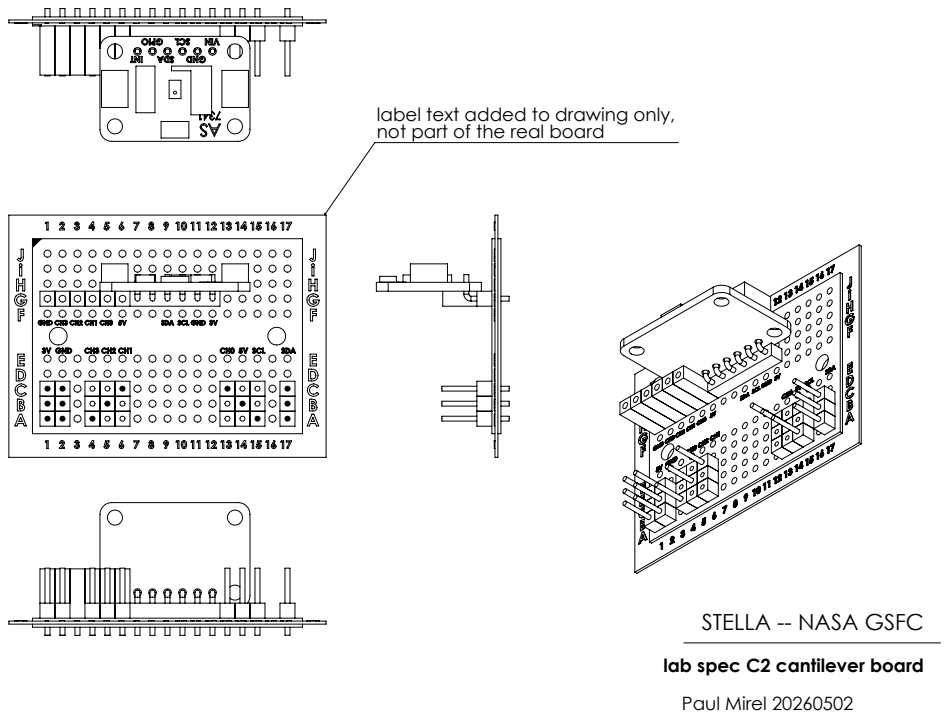
[picture p155: page 1]

label text added to drawing only,
not part of the real board

STELLA -- NASA GSFC
lab spec C2 cantilever board
Paul Mirel 20260502
