paulmirel/STELLA-1/STELLA_1.2/Documentation/lab_spec_documents/C2 boards/lab spec C2 drop and excitation join.pdf

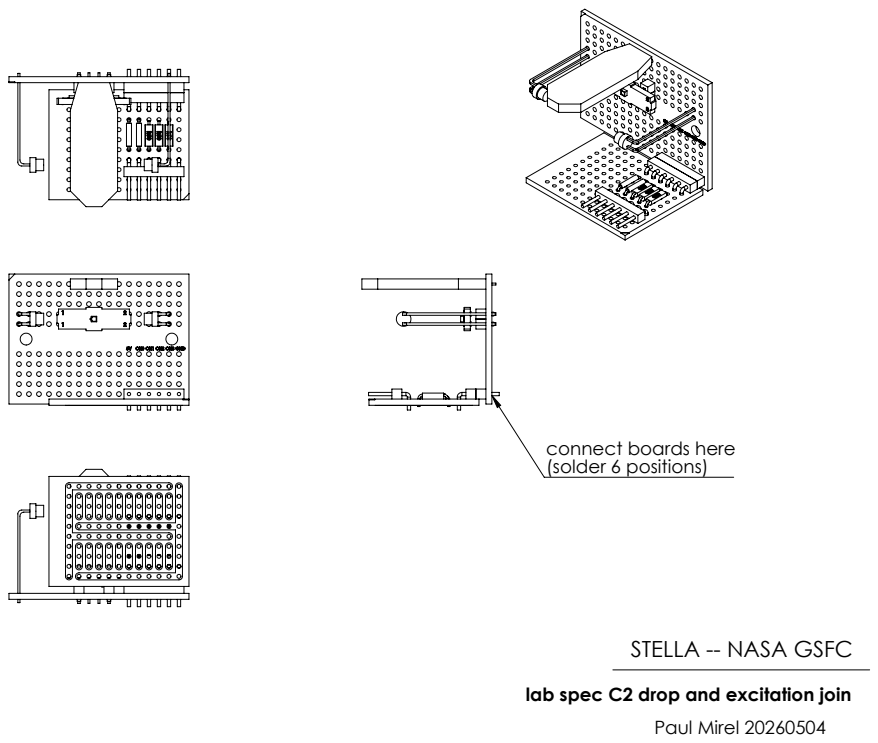
[picture p156: page 1]
Paul Mirel 20260504

connect boards here
(solder 6 positions)

STELLA -- NASA GSFC

lab spec C2 drop and excitation join
