paulmirel/STELLA-1/STELLA_1.2/Documentation/lab_spec_documents/C2 boards/lab spec C2 drop board.pdf

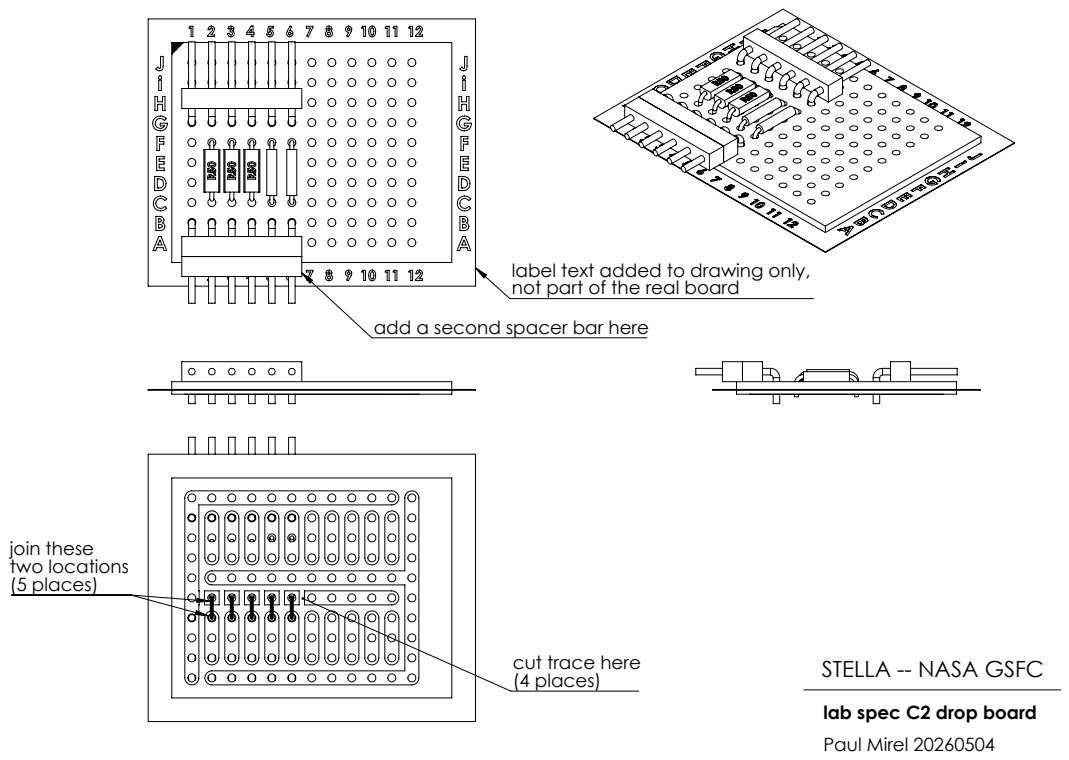
[picture p157: page 1]
join these two locations (5 places)

label text added to drawing only,
not part of the real board

add a second spacer bar here

cut trace here
(4 places)

STELLA -- NASA GSFC
lab spec C2 drop board
Paul Mirel 20260504
