paulmirel/STELLA-1/STELLA_1.2/Documentation/lab_spec_documents/C2 boards/lab spec C2 excitation board.pdf

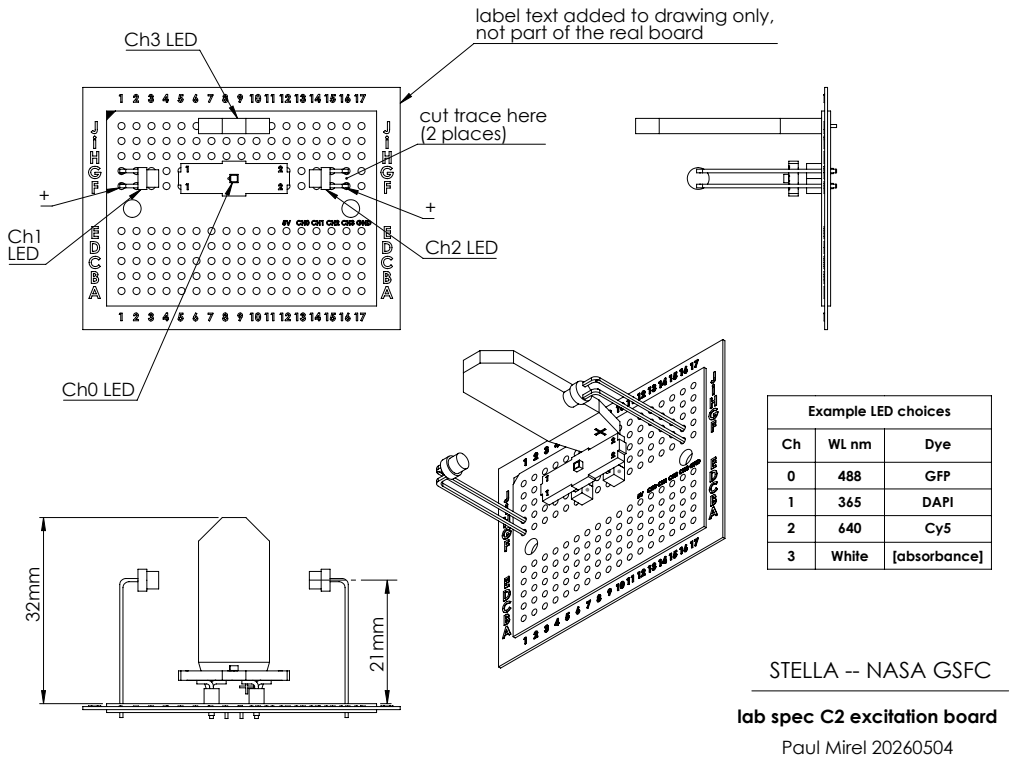
[picture p158: page 1]
Ch0 LED; Ch3 LED; LED; Ch2 LED

label text added to drawing only,
not part of the real board

cut trace here
(2 places)

Example LED choices

Ch | WL nm | Dye
0 | 488 | GFP
1 | 365 | DAPI
2 | 640 | Cy5
3 | White | [absorbance]

STELLA -- NASA GSFC
lab spec C2 excitation board
Paul Mirel 20260504
