paulmirel/STELLA-1/STELLA_1.2/Documentation/lab_spec_documents/main board/lab spec main board closeup.pdf

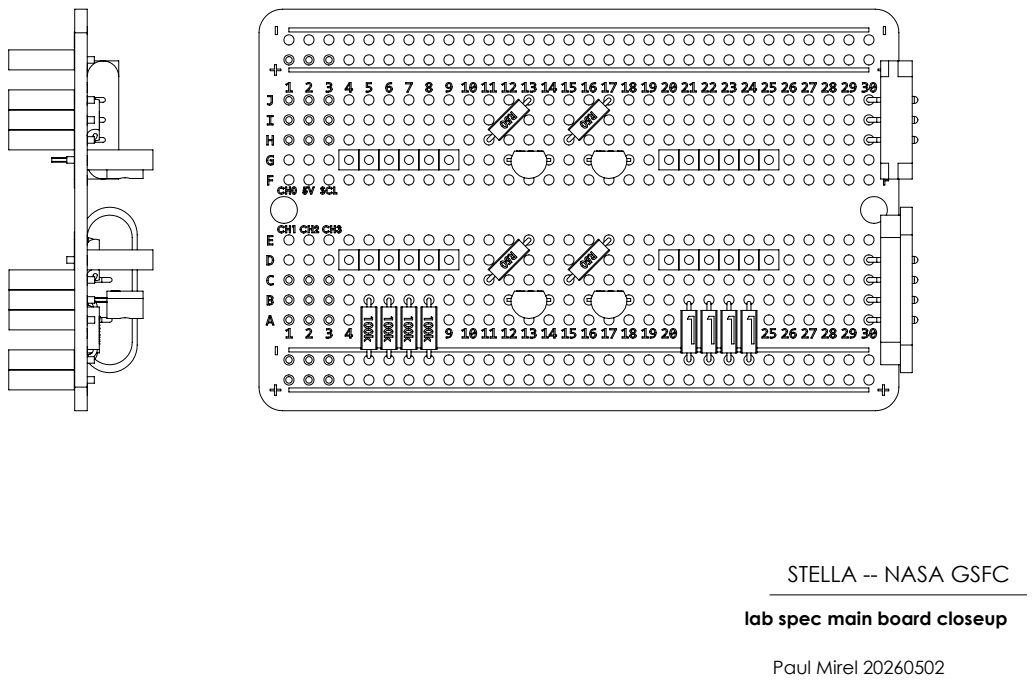
[picture p159: page 1]
Paul Mirel 20260502

STELLA -- NASA GSFC
lab spec main board closeup
