paulmirel/STELLA-1/STELLA_1.2/Documentation/lab_spec_documents/main board/lab spec main board.pdf

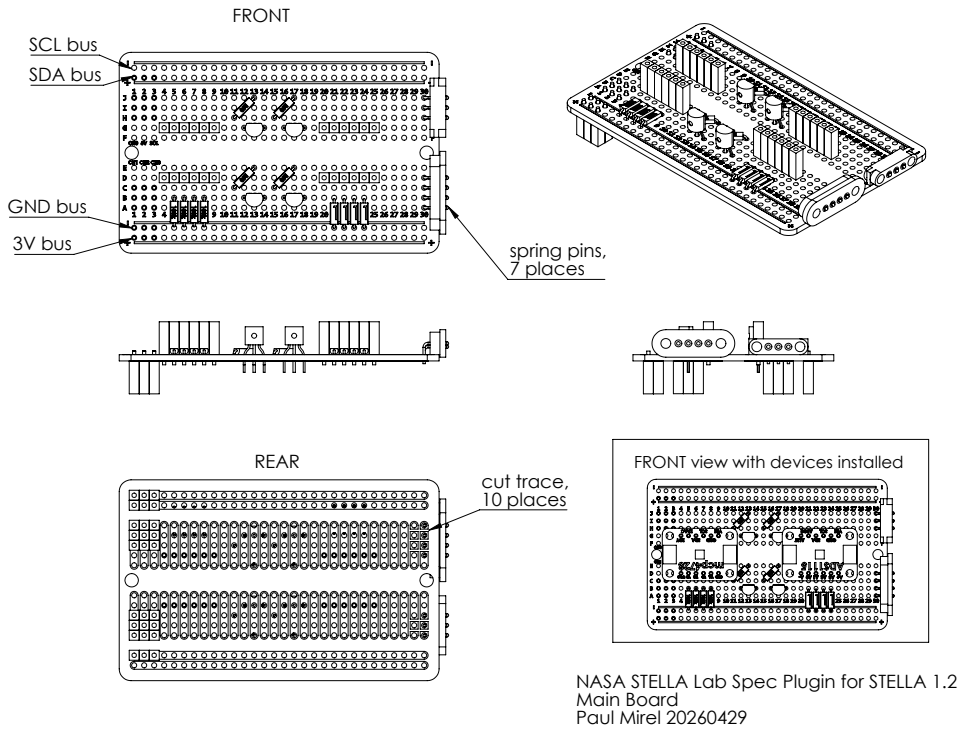
[picture p160: page 1]
SCL bus SDA bus; 3V bus; GND bus; spring pins, 7 places; cut trace, 10 places

FRONT view with devices installed

NASA STELLA Lab Spec Plugin for STELLA 1.2
Main Board
Paul Mirel 20260429
