paulmirel/STELLA-1/STELLA_1.2/Documentation/mp_spectrum_plugin.pdf

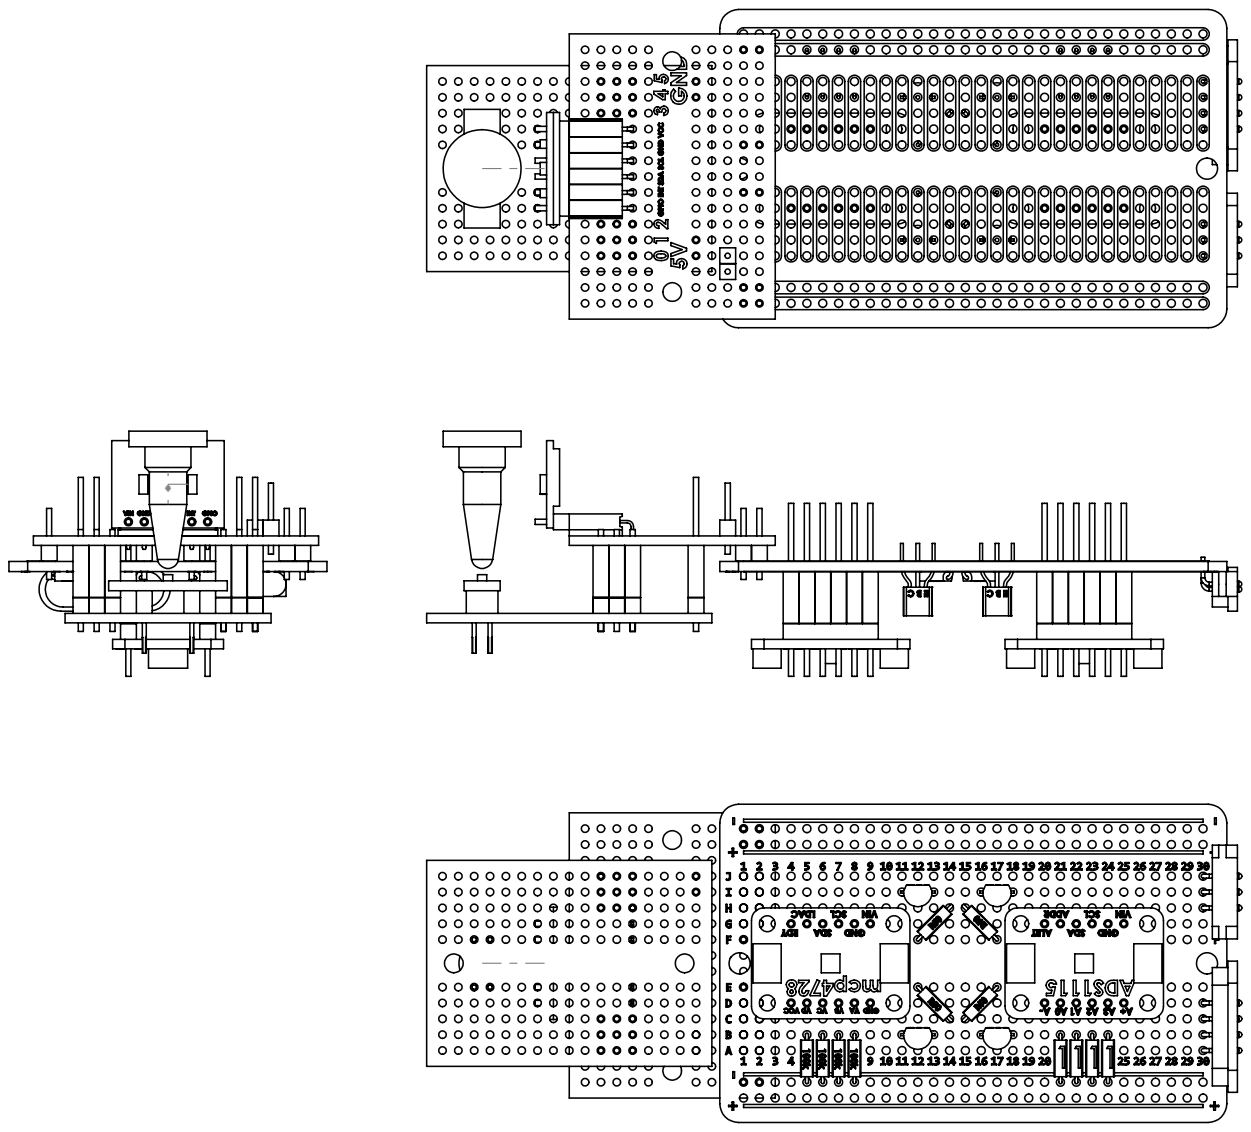
[picture p161: page 1]
