paulmirel/STELLA-1/STELLA_1.2/Documentation/fluorescence_plugin.pdf

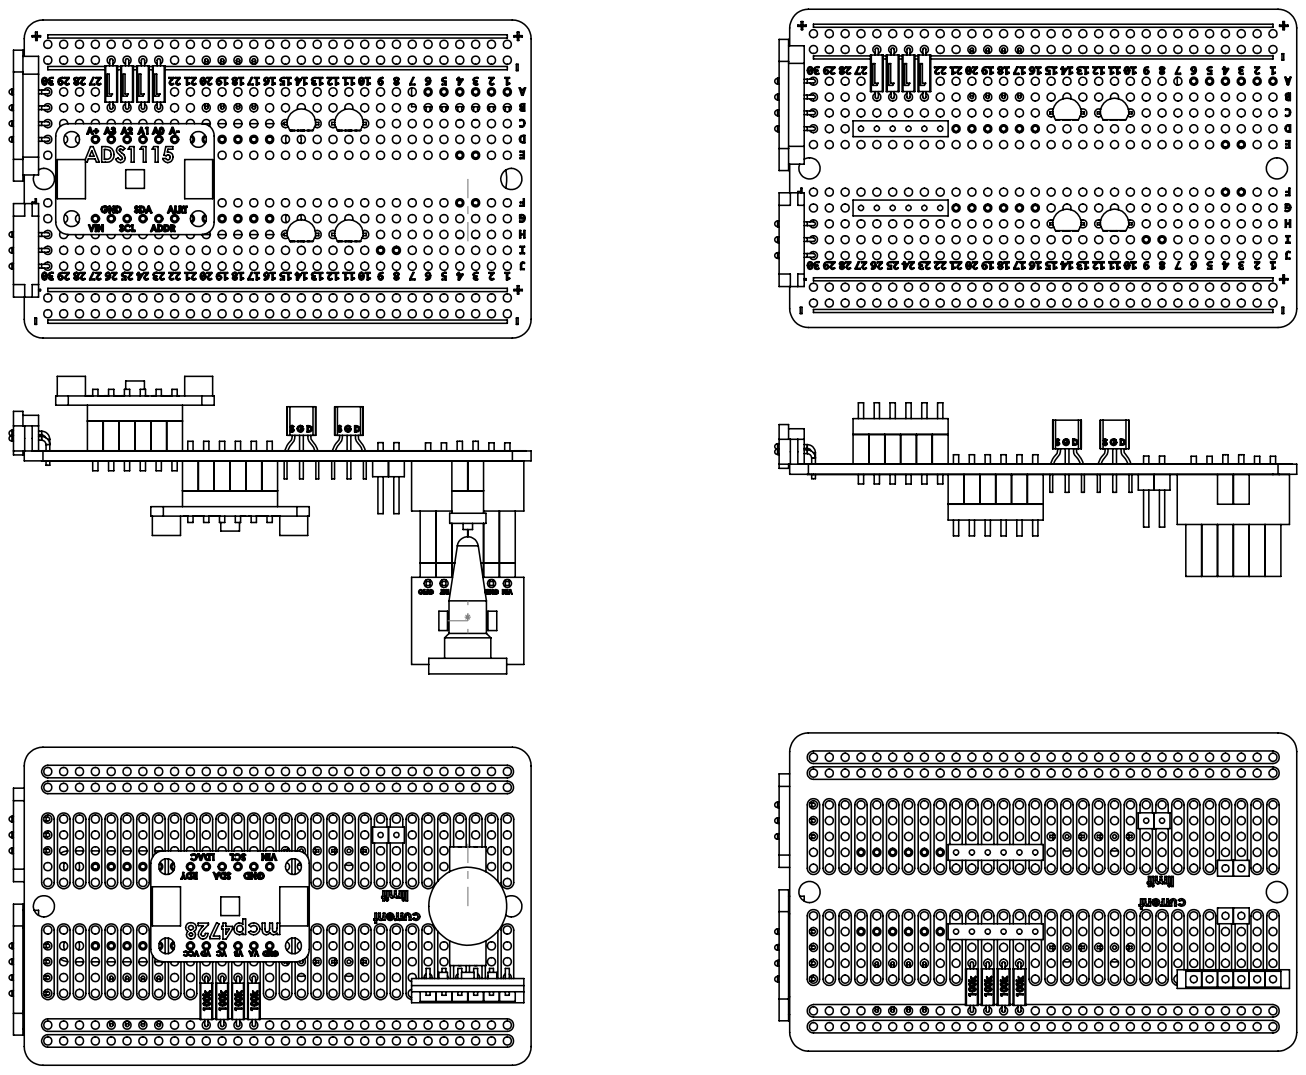
[picture p162: page 1]
