paulmirel/STELLA-1/STELLA_1.2/Documentation/fluorescence_plugin_2.PDF

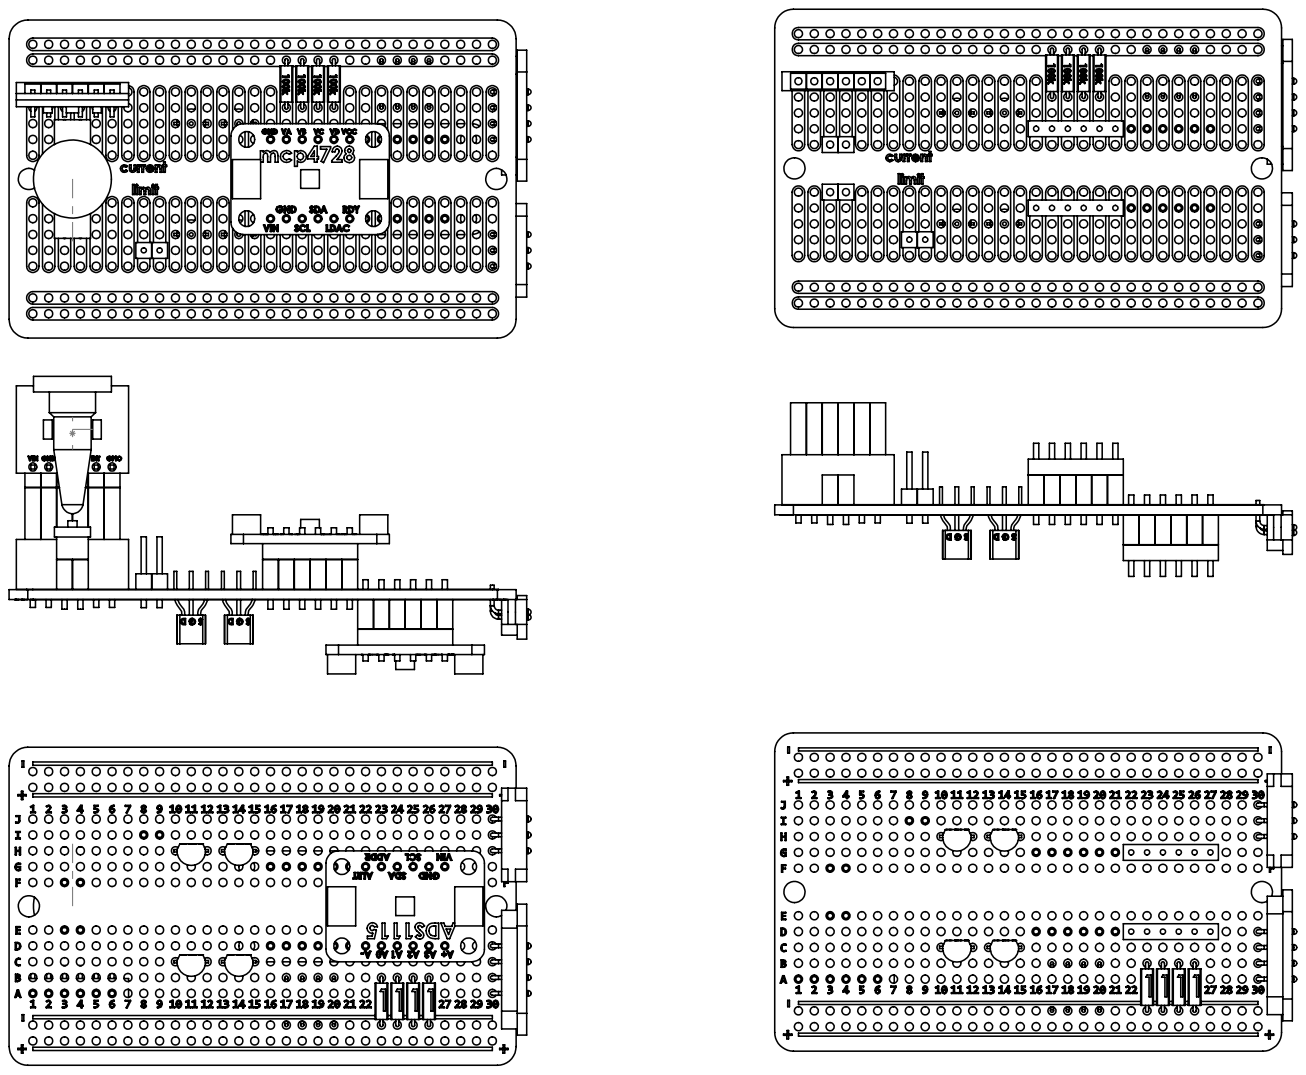
[picture p163: page 1]
