paulmirel/STELLA-1/STELLA_1.2/STELLA_1.2_code_and_libraries/1.3.3_version_unstable/software_modules/pagem_light.py

# light page module
# version 1.0
# Copyright NASA 2025 under MIT open source license
# Author Paul Mirel

import math
import displayio
from adafruit_display_text import label
import vectorio
import terminalio
from .classm_page import Page

class Spectral_Register:
    def __init__( self, instrument ):
        self.instrument = instrument
        self.scale_choices = ["linear", "log"]
        self.scale_index = 0
        self.units_y_choices = ["counts", "ct_per_s_nm" ]#, "uW_per_cm^2"]#"irradiance" ]
        self.units_y_index = 0
        self.visible_present = False
        self.ultraviolet_present = False
        self.near_infrared_present = False
        for sensor in self.instrument.spectral_sensors_present:
            if sensor.pn == "as7331":
                self.ultraviolet_present = True
            if sensor.pn == "as7265x":
                self.visible_present = True
                self.near_infrared_present = True
            if sensor.pn == "as7343":
                self.visible_present = True
                self.near_infrared_present = True
            if sensor.pn == "as7341":
                self.visible_present = True
            if sensor.pn == "tcs3448":
                self.visible_present = True
                self.near_infrared_present = True

        self.spectrum_choices = []
        self.wavelength_ranges = []
        if self.ultraviolet_present and self.visible_present and self.near_infrared_present:
            self.spectrum_choices.append("uv + vis + nir")
            self.wavelength_ranges.append((200,1000))
        if self.visible_present and self.near_infrared_present:
            self.spectrum_choices.append("vis + nir")
            self.wavelength_ranges.append((400,1000))
        if self.ultraviolet_present and self.visible_present:
            self.spectrum_choices.append("uv + vis")
            self.wavelength_ranges.append((200,700))
        if self.ultraviolet_present:
            self.spectrum_choices.append("ultraviolet")
            self.wavelength_ranges.append((200,400))
        if self.visible_present:
            self.spectrum_choices.append("visible")
            self.wavelength_ranges.append((400,700))
        if self.near_infrared_present:
            self.spectrum_choices.append("near infrared")
            self.wavelength_ranges.append((700,1000))

        self.spectrum_index = 0
        self.data_source_choices = ["sensors", "*future"]#"reference"]
        self.data_source_index = 0
        self.units_x_choices = ["wavelength nm", "frequency THz", "energy eV", "wavenumber/cm"]
        self.units_x_index = 0
        self.live = True
        self.distance_popup = False
        self.five_x_values = [[0,0,0,0,0],[0,0,0,0,0],[0,0,0,0,0],[0,0,0,0,0]]
        self.number_of_plot_points = 0
        self.wavelengths_to_plot = []
        self.wl_min = 200
        self.wl_max = 1000

    def calculate_five_x_values( self ):
        self.wavelengths_to_plot = []
        self.wl_min = self.wavelength_ranges[self.spectrum_index][0]
        self.wl_max = self.wavelength_ranges[self.spectrum_index][1]
        for item in self.instrument.wavelength_bands_list_sorted:
            if item in range (self.wl_min, self.wl_max):
                self.wavelengths_to_plot.append(item)
        self.five_x_values[0][0] = self.wavelength_ranges[self.spectrum_index][0]
        self.five_x_values[0][4] = self.wavelength_ranges[self.spectrum_index][1]
        c_m_per_s = 299792458
        nm_per_m = 10**9
        Hz_per_THz = 10**12
        h_e_V_per_Hz = 4.135667696/10**15
        self.five_x_values[0][2] = int( (self.five_x_values[0][0] + self.five_x_values[0][4])/2 )
        self.five_x_values[0][1] = int( (self.five_x_values[0][0] + self.five_x_values[0][2])/2 )
        self.five_x_values[0][3] = int( (self.five_x_values[0][2] + self.five_x_values[0][4])/2 )
        for index in range( 0, 5 ):
            self.five_x_values[1][index] = int((c_m_per_s / ((self.five_x_values[0][index])/nm_per_m))/Hz_per_THz) # frequency
            self.five_x_values[2][index] = round((self.five_x_values[1][index]* Hz_per_THz)*h_e_V_per_Hz,1)  # energy
            self.five_x_values[3][index] = int( 10000000/self.five_x_values[0][index] )  # wave number


def create_spectral_register( instrument ):
    spectral_register = Spectral_Register( instrument )
    return spectral_register

class Light_Page( Page ):
    def __init__( self, instrument):
        super().__init__()
        self.page_name = "Light"
        self.instrument = instrument
        self.palette = instrument.palette
        self.spectral_register = create_spectral_register(self.instrument)
        self.selection = 0
        self.last_selection = 0
        self.selection_rectangles = []
        self.field_selected_color_index = 5
        self.field_not_selected_color_index = 9
        self.field_selected = False
        self.points =[]
        for sensor in self.instrument.sensors_present:
            if sensor.pn == "lv_ez_mb1013":
                self.rangefinder = sensor

    def create_plot( self ):
        graph_x = 44#14
        graph_width = 320 - graph_x - 12
        graph_height = 240-124
        message_height = int( graph_height/4 )
        message_offset = 10
        graph_y = 80 +4
        self.graph_pix_y0 = graph_y + graph_height
        self.graph_pix_x0 = graph_x
        self.graph_pix_xn = self.graph_pix_x0 + graph_width
        self.graph_pix_yn = self.graph_pix_y0 - graph_height
        ## make all the plot points, store them on the x-axis
        self.pixels_per_point = 2 #4
        self.point_height = 2
        self.number_of_points = int(graph_width / self.pixels_per_point)
        #print( "number_of_points", self.number_of_points )
        for index in range (0, self.number_of_points):
            #color_index = index % 10 or color_index = 0
            point = vectorio.Rectangle( pixel_shader=self.palette, color_index = 0 , width=self.pixels_per_point, height=self.point_height,
                        x=self.graph_pix_x0 + index*self.pixels_per_point, y=self.graph_pix_y0 - self.point_height )
            self.points.append(point)
            self.group.append(point)


    def update_plot( self ):
        if self.spectral_register.live:
            #print( "update plot" )
            units_y = self.spectral_register.units_y_choices[ self.spectral_register.units_y_index ]
            spectral_graph_x_values_nm = []
            spectral_bandwidths_nm = []
            spectral_graph_y_values = []
            data_dict_to_plot = {}
            # make a data dict to plot of the form key=band, value = tuple( counts, normal_counts, irradiance, bandwidth )
            for sensor in self.instrument.sensors_present:
                if sensor.pn == "tcs3448" or sensor.pn == "as7331" or sensor.pn == "as7265x" or sensor.pn == "as7341" or sensor.pn == "as7343":
                    wl = sensor.get_wavelength()
                    values = sensor.get_plot_values()
                    data_dict_to_plot.update({wl:values})
            #print( data_dict_to_plot )
            linear_y_values = []
            linear_y_counts = []
            for band in self.instrument.wavelength_bands_list_sorted:
                if band in range ( self.spectral_register.wl_min, self.spectral_register.wl_max ):
                    self.instrument.handle_inputs()
                    spectral_graph_x_values_nm.append(band)
                    channel_values = data_dict_to_plot.get(band)
                    if channel_values is not None:
                        spectral_bandwidths_nm.append( channel_values[3] )
                        if units_y == "counts": #["counts", "cts_per_s", "irradiance" ]
                            linear_y_value = channel_values[0]
                        elif units_y == "ct_per_s_nm":
                            linear_y_value = channel_values[1]
                        elif units_y == "uW_per_cm^2":
                            linear_y_value = channel_values[2]
                        linear_y_values.append( linear_y_value )
                        linear_y_counts.append(channel_values[0])
                        scale_choice = self.spectral_register.scale_choices[ self.spectral_register.scale_index]
                        if scale_choice == "linear" :
                            spectral_graph_y_values.append( linear_y_value )
                        elif scale_choice == "log" :
                            if linear_y_value < 1:
                                spectral_graph_y_values.append( 0 )
                            else:
                                spectral_graph_y_values.append( math.log(linear_y_value,10))

            self.high_value_text_area.text = "{}".format(round(max(linear_y_values),2))
            self.low_value_text_area.text = "{}".format(round(min(linear_y_values),2))
            percent_dynamic_range = 100*max(linear_y_counts) / 65535
            if percent_dynamic_range < 100:
                if percent_dynamic_range < 10:
                    self.dynamic_range_value_text_area.text = "{}%".format(round(percent_dynamic_range,2))
                else:
                    self.dynamic_range_value_text_area.text = "{}%".format(int(percent_dynamic_range))
            else:
                self.dynamic_range_value_text_area.text = "SATURATED"
            #print(spectral_graph_x_values_nm)
            #print(spectral_graph_y_values)
            #print(spectral_bandwidths_nm)

            if spectral_graph_y_values:
                wavelength_nm_per_point = (self.spectral_register.wl_max  - self.spectral_register.wl_min)/(self.number_of_points - 1 )
                #wavelength_nm_per_point = (spectral_graph_x_values_nm[-1] - spectral_graph_x_values_nm[0])/(self.number_of_points - 1 )
                #print( wavelength_nm_per_point )

                inactive_point_color = 19
                indicies_of_active_points = []
                point_wavelengths_nm = []  # wavelength for each point
                point_active = []       # boolean list, true if there's real data for that point
                point_colors = []       # color index for each point
                point_bandwidths = []   # bandwidth for each point ( 0 for inactive points )
                point_y_values = []     # y value in counts or irradiance for each point
                point_y_location = []   # display position in y pixels for each point: plot this value

                for value in spectral_graph_x_values_nm:
                    indicies_of_active_points.append(int( round((value - self.spectral_register.wl_min) / wavelength_nm_per_point,0)))

                slopes_delta_y_per_point = []
                for index in range ( 0, len(indicies_of_active_points)-1):
                    index_span = indicies_of_active_points[index+1]-indicies_of_active_points[index]
                    if index_span == 0:
                        index_span = 1
                    slopes_delta_y_per_point.append( (spectral_graph_y_values[index+1]-spectral_graph_y_values[index])/ index_span)

                y_value_index = -1
                last_index = 0
                for index in range (0, self.number_of_points):
                    self.instrument.handle_inputs()
                    point_wavelengths_nm.append( spectral_graph_x_values_nm[0] + index * wavelength_nm_per_point)
                    #point_wavelengths_nm.append( self.spectral_register.wl_min + index * wavelength_nm_per_point)
                    if index in indicies_of_active_points:
                        y_value_index += 1
                        point_active.append( True )
                        bandwidth = spectral_bandwidths_nm[y_value_index]
                        wavelength = spectral_graph_x_values_nm[y_value_index]
                        if wavelength in range(390,420):
                            self.points[index].color_index = 25
                        if wavelength in range(420,450):
                            self.points[index].color_index = 26
                        if wavelength in range(450,470):
                            self.points[index].color_index = 27
                        if wavelength in range(470,500):
                            self.points[index].color_index = 28
                        if wavelength in range(500,520):
                            self.points[index].color_index = 29
                        if wavelength in range(520,550):
                            self.points[index].color_index = 30
                        if wavelength in range(550,570):
                            self.points[index].color_index = 31
                        if wavelength in range(570,600):
                            self.points[index].color_index = 32
                        if wavelength in range(600,630):
                            self.points[index].color_index = 33
                        if wavelength in range(630,660):
                            self.points[index].color_index = 34
                        if wavelength in range(660,690):
                            self.points[index].color_index = 35
                        if wavelength in range(690,720):
                            self.points[index].color_index = 36
                        if wavelength in range(720,745):
                            self.points[index].color_index = 37
                        if wavelength in range(745,785):
                            self.points[index].color_index = 38
                        if wavelength > 785 or wavelength < 390:
                            self.points[index].color_index = 0
                        bw_in_points = int( bandwidth/wavelength_nm_per_point )*self.pixels_per_point
                        self.points[index].width = bw_in_points
                        self.points[index].x = self.graph_pix_x0 + index*self.pixels_per_point - int(bw_in_points/2)
                        self.points[index].height = self.point_height *3
                        point_y_values.append( spectral_graph_y_values[ y_value_index ] )
                        last_index = index
                    elif index < indicies_of_active_points[0] or index > indicies_of_active_points[-1]: #elif points outside of active_min and active_max
                        point_y_values.append(0) #exile the point to the bottom of the graph
                        self.points[index].height = 1
                        self.points[index].color_index = 0
                    else:
                        if y_value_index < len( slopes_delta_y_per_point ) and  y_value_index < len( spectral_graph_y_values ) :
                            point_active.append( False )
                            self.points[index].color_index = 19
                            self.points[index].width = self.pixels_per_point
                            self.points[index].height = self.point_height
                            self.points[index].x=self.graph_pix_x0 + index*self.pixels_per_point
                            point_y_values.append( (index-last_index)*slopes_delta_y_per_point[y_value_index] + spectral_graph_y_values[ y_value_index ] )
                y_pixel_span = self.graph_pix_y0 - self.graph_pix_yn
                y_value_span = max( point_y_values ) -  min( point_y_values )
                if y_value_span > 0:
                    y_pix_per_value = y_pixel_span / y_value_span
                else:
                    y_pix_per_value = 1

                y_pix_coords = []
                for item in point_y_values:
                    self.instrument.handle_inputs()
                    y_pix_coords.append( self.graph_pix_y0 - self.point_height - int( y_pix_per_value *(item - min(point_y_values))) )

                for index in range (0, self.number_of_points):
                    self.instrument.handle_inputs()
                    #print( index, y_pix_coords[index] )
                    if index < len(y_pix_coords):
                        self.points[index].y = y_pix_coords[index]
        else:
            pass

    def update_values( self ):
        self.scale_text_area.text = self.spectral_register.scale_choices[ self.spectral_register.scale_index ]
        self.units_y_text_area.text = self.spectral_register.units_y_choices[ self.spectral_register.units_y_index ]
        self.spectrum_text_area.text = self.spectral_register.spectrum_choices[ self.spectral_register.spectrum_index ]
        self.data_source_text_area.text = self.spectral_register.data_source_choices[ self.spectral_register.data_source_index ]
        self.units_x_text_area.text = self.spectral_register.units_x_choices[ self.spectral_register.units_x_index ]
        if self.spectral_register.distance_popup:
            self.distance_text_area.scale = 2
            self.distance_text_area.text = self.rangefinder.range_text
        else:
            self.distance_text_area.scale = 1
            self.distance_text_area.text = "standoff"
        if self.spectral_register.live:
            self.live_text_area.text = "LIVE"
        else:
            self.live_text_area.text = "HOLD"

        self.spectral_register.calculate_five_x_values()
        self.left_value_text_area.text = "{}".format(self.spectral_register.five_x_values[self.spectral_register.units_x_index][0])
        self.left_mid_value_text_area.text = "{}".format(self.spectral_register.five_x_values[self.spectral_register.units_x_index][1])
        self.mid_value_text_area.text = "{}".format(self.spectral_register.five_x_values[self.spectral_register.units_x_index][2])
        self.right_mid_value_text_area.text = "{}".format(self.spectral_register.five_x_values[self.spectral_register.units_x_index][3])
        self.right_value_text_area.text = "{}".format(self.spectral_register.five_x_values[self.spectral_register.units_x_index][4])


    def update_selection( self ):
        self.selection_rectangles[self.last_selection].hidden = True
        self.selection_rectangles[self.selection].hidden = False

    def action( self ):
        if self.instrument.encoder_increment != 0:
            if self.field_selected:
                if self.selection == 1:
                   self.spectral_register.scale_index = (self.spectral_register.scale_index + self.instrument.encoder_increment) % len(self.spectral_register.scale_choices)
                if self.selection == 0:
                   self.spectral_register.units_y_index = (self.spectral_register.units_y_index + self.instrument.encoder_increment) % len(self.spectral_register.units_y_choices)
                if self.selection == 2:
                    last_spectrum_index = self.spectral_register.spectrum_index
                    self.spectral_register.spectrum_index = (self.spectral_register.spectrum_index + self.instrument.encoder_increment) % len(self.spectral_register.spectrum_choices)
                    self.spectral_register.calculate_five_x_values()
                if self.selection == 5:
                   self.spectral_register.data_source_index = (self.spectral_register.data_source_index + self.instrument.encoder_increment) % len(self.spectral_register.data_source_choices)
                if self.selection == 6:
                    self.spectral_register.units_x_index = (self.spectral_register.units_x_index + self.instrument.encoder_increment) % len(self.spectral_register.units_x_choices)
                if self.selection == 7:
                    self.spectral_register.distance_popup = not self.spectral_register.distance_popup
                if self.selection == 8:
                    self.spectral_register.live = not self.spectral_register.live
            self.instrument.encoder_increment = 0
            self.update_values()

        if self.instrument.button_pressed:
            if self.selection == 9:
                self.instrument.active_page_number = self.instrument.pages_dict["Main"]
            elif self.selection == 3:
                print( "go to exposure control" )
                self.instrument.active_page_number = self.instrument.pages_dict["Exposure"]
            elif self.selection == 4:
                self.instrument.active_page_number = self.instrument.pages_dict["Heat"]
            else:
                self.field_selected = not self.field_selected
                if self.selection == 1:
                    if self.field_selected:
                        self.scale_color.color_index = self.field_selected_color_index
                    else:
                        self.scale_color.color_index = self.field_not_selected_color_index
                if self.selection == 0:
                    if self.field_selected:
                        self.units_y_color.color_index = self.field_selected_color_index
                    else:
                        self.units_y_color.color_index = self.field_not_selected_color_index
                if self.selection == 2:
                    if self.field_selected:
                        self.spectrum_color.color_index = self.field_selected_color_index
                    else:
                        self.spectrum_color.color_index = self.field_not_selected_color_index
                if self.selection == 5:
                    if self.field_selected:
                        self.data_source_color.color_index = self.field_selected_color_index
                    else:
                        self.data_source_color.color_index = self.field_not_selected_color_index
                if self.selection == 6:
                    if self.field_selected:
                        self.units_x_color.color_index = self.field_selected_color_index
                    else:
                        self.units_x_color.color_index = self.field_not_selected_color_index
                if self.selection == 7:
                    print( "open range tab" )
                    if self.field_selected:
                        self.distance_color.color_index = self.field_selected_color_index
                    else:
                        self.distance_color.color_index = self.field_not_selected_color_index
                if self.selection == 8:
                    if self.field_selected:
                        self.live_color.color_index = self.field_selected_color_index
                    else:
                        self.live_color.color_index = self.field_not_selected_color_index
            self.instrument.button_pressed = False
            self.update_values()



    def make_group( self ):
        extra_space = 8
        self.group = displayio.Group()
        separator_bar_height = 2
        light_background_y = 54 + separator_bar_height
        light_background_height = 240 - light_background_y
        upper_text_y = light_background_y + 10
        select_width = 4
        offset = 4
        upper_select_y = light_background_y
        upper_control_height = 14
        upper_select_height = upper_control_height + 2*select_width
        upper_control_y = upper_select_y + select_width
        light_background = vectorio.Rectangle(pixel_shader=self.palette, color_index=9, width=320, height=light_background_height, x=0, y=light_background_y)
        self.group.append( light_background )

        # units
        units_y_select_x = 0
        units_y_color_x = units_y_select_x + select_width
        units_y_select_width = 77
        self.units_y_select = vectorio.Rectangle(pixel_shader=self.palette, color_index=0, width=units_y_select_width, height=upper_select_height, x=units_y_select_x, y=upper_select_y)
        self.group.append( self.units_y_select )
        self.selection_rectangles.append(self.units_y_select)

        self.units_y_select.hidden = True
        units_y_control_width = units_y_select_width - 2 * select_width
        self.units_y_color = vectorio.Rectangle(pixel_shader=self.palette, color_index=9, width=units_y_control_width, height=upper_control_height, x=units_y_color_x, y=upper_control_y)
        self.group.append( self.units_y_color )
        units_y_text_x = units_y_color_x + 2
        units_y_group = displayio.Group(scale=1, x=units_y_text_x, y=upper_text_y)
        units_y_text = "  --"#"counts" #"irradiance"
                                #"cts_per_ms
        self.units_y_text_area = label.Label(terminalio.FONT, text=units_y_text, color=self.palette[0])
        units_y_group.append(self.units_y_text_area)
        self.group.append(units_y_group)

        # scale
        scale_select_x = 78
        scale_color_x = scale_select_x + select_width
        scale_select_width = 49
        self.scale_select = vectorio.Rectangle(pixel_shader=self.palette, color_index=0, width=scale_select_width, height=upper_select_height, x=scale_select_x, y=upper_select_y)
        self.group.append( self.scale_select )
        self.selection_rectangles.append(self.scale_select)

        self.scale_select.hidden = True
        scale_control_width = scale_select_width - 2 * select_width
        self.scale_color = vectorio.Rectangle(pixel_shader=self.palette, color_index=9, width=scale_control_width, height=upper_control_height, x=scale_color_x, y=upper_control_y)
        self.group.append( self.scale_color )
        scale_text_x = scale_color_x + 3
        scale_group = displayio.Group(scale=1, x=scale_text_x, y=upper_text_y)
        scale_text = " --"
        self.scale_text_area = label.Label(terminalio.FONT, text=scale_text, color=self.palette[0])
        scale_group.append(self.scale_text_area)
        self.group.append(scale_group)



        # spectrum
        spectrum_select_x = 126
        spectrum_color_x = spectrum_select_x + select_width
        spectrum_select_width = 96
        self.spectrum_select = vectorio.Rectangle(pixel_shader=self.palette, color_index=0, width=spectrum_select_width, height=upper_select_height, x=spectrum_select_x, y=upper_select_y)
        self.group.append( self.spectrum_select )
        self.selection_rectangles.append(self.spectrum_select)

        self.spectrum_select.hidden = True
        spectrum_control_width = spectrum_select_width - 2 * select_width
        self.spectrum_color = vectorio.Rectangle(pixel_shader=self.palette, color_index=9, width=spectrum_control_width, height=upper_control_height, x=spectrum_color_x, y=upper_control_y)
        self.group.append( self.spectrum_color )
        spectrum_text_x = spectrum_color_x + 3
        spectrum_group = displayio.Group(scale=1, x=spectrum_text_x, y=upper_text_y)
        spectrum_text = "    --"
        #spectrum_text = "near infrared"
        #spectrum_text = "ultraviolet"
        #spectrum_text = "visible"
        #spectrum_text = "uv + visible"
        self.spectrum_text_area = label.Label(terminalio.FONT, text=spectrum_text, color=self.palette[0])
        spectrum_group.append(self.spectrum_text_area)
        self.group.append(spectrum_group)

        # exposure
        exposure_select_x = 220 #offset + scale_select_width + units_y_select_width + spectrum_select_width - 3*select_width
        exposure_color_x = exposure_select_x + select_width
        exposure_select_width = 62
        self.exposure_select = vectorio.Rectangle(pixel_shader=self.palette, color_index=0, width=exposure_select_width, height=upper_select_height, x=exposure_select_x, y=upper_select_y)
        self.group.append( self.exposure_select )
        self.selection_rectangles.append(self.exposure_select)

        self.exposure_select.hidden = True
        exposure_control_width = exposure_select_width - 2 * select_width
        self.exposure_color = vectorio.Rectangle(pixel_shader=self.palette, color_index=9, width=exposure_control_width, height=upper_control_height, x=exposure_color_x, y=upper_control_y)
        self.group.append( self.exposure_color )
        exposure_text_x = exposure_color_x + 3
        exposure_group = displayio.Group(scale=1, x=exposure_text_x, y=upper_text_y)
        exposure_text = "exposure"
        self.exposure_text_area = label.Label(terminalio.FONT, text=exposure_text, color=self.palette[0])
        exposure_group.append(self.exposure_text_area)
        self.group.append(exposure_group)

        # heat
        heat_select_x = 282 #offset + scale_select_width + units_y_select_width + spectrum_select_width - 3*select_width
        heat_color_x = heat_select_x + select_width
        heat_select_width = 36
        self.heat_select = vectorio.Rectangle(pixel_shader=self.palette, color_index=0, width=heat_select_width, height=upper_select_height, x=heat_select_x, y=upper_select_y)
        self.group.append( self.heat_select )
        self.selection_rectangles.append(self.heat_select)

        self.heat_select.hidden = True
        heat_control_width = heat_select_width - 2 * select_width
        self.heat_color = vectorio.Rectangle(pixel_shader=self.palette, color_index=9, width=heat_control_width, height=upper_control_height, x=heat_color_x, y=upper_control_y)
        self.group.append( self.heat_color )
        heat_text_x = heat_color_x + 3
        heat_group = displayio.Group(scale=1, x=heat_text_x, y=upper_text_y)
        heat_text = "heat"
        self.heat_text_area = label.Label(terminalio.FONT, text=heat_text, color=self.palette[0])
        heat_group.append(self.heat_text_area)
        self.group.append(heat_group)

        y_values_x = 4
        high_value_y = upper_text_y + 16
        dynamic_range_value_y = high_value_y + 16 #102
        low_value_y = 194


        high_value_group = displayio.Group(scale=1, x=y_values_x, y=high_value_y)
        high_value_text = "--"#"186"#
        self.high_value_text_area = label.Label(terminalio.FONT, text=high_value_text, color=self.palette[0])
        high_value_group.append(self.high_value_text_area)
        self.group.append(high_value_group)

        dynamic_range_value_group = displayio.Group(scale=1, x=y_values_x, y=dynamic_range_value_y)
        dynamic_range_value_text = "--"#"99%dr"#
        self.dynamic_range_value_text_area = label.Label(terminalio.FONT, text=dynamic_range_value_text, color=self.palette[0])
        dynamic_range_value_group.append(self.dynamic_range_value_text_area)
        self.group.append(dynamic_range_value_group)

        dynamic_range_legend_group = displayio.Group(scale=1, x=y_values_x, y=dynamic_range_value_y+16)
        dynamic_range_legend_text = "of DR"
        self.dynamic_range_legend_text_area = label.Label(terminalio.FONT, text=dynamic_range_legend_text, color=self.palette[0])
        dynamic_range_legend_group.append(self.dynamic_range_legend_text_area)
        self.group.append(dynamic_range_legend_group)

        low_value_group = displayio.Group(scale=1, x=y_values_x, y=low_value_y)
        low_value_text = "--"#"20"#
        self.low_value_text_area = label.Label(terminalio.FONT, text=low_value_text, color=self.palette[0])
        low_value_group.append(self.low_value_text_area)
        self.group.append(low_value_group)

        origin_x = 36
        origin_y = 198
        height_y = 124

        y_axis_line = vectorio.Rectangle(pixel_shader=self.palette, color_index=0, width=2, height= height_y, x=origin_x, y=origin_y - height_y )
        self.group.append( y_axis_line )

        x_axis_line = vectorio.Rectangle(pixel_shader=self.palette, color_index=0, width=280, height=2, x=origin_x, y=origin_y)
        self.group.append( x_axis_line )


        # lower controls
        lower_control_height = 14
        lower_select_y = 240 - offset - separator_bar_height - lower_control_height - select_width
        lower_select_height = lower_control_height + 2*select_width
        lower_control_y = lower_select_y + select_width
        lower_text_y = lower_control_y + 6
        # data_source
        data_source_select_x = offset
        data_source_color_x = data_source_select_x + select_width
        data_source_select_width = 68
        self.data_source_select = vectorio.Rectangle(pixel_shader=self.palette, color_index=0, width=data_source_select_width, height=lower_select_height, x=data_source_select_x, y=lower_select_y)
        self.group.append( self.data_source_select )
        self.selection_rectangles.append(self.data_source_select)

        self.data_source_select.hidden = True
        data_source_control_width = data_source_select_width - 2 * select_width
        self.data_source_color = vectorio.Rectangle(pixel_shader=self.palette, color_index=9, width=data_source_control_width, height=lower_control_height, x=data_source_color_x, y=lower_control_y)
        self.group.append( self.data_source_color )
        data_source_text_x = data_source_color_x + 3
        data_source_group = displayio.Group(scale=1, x=data_source_text_x, y=lower_text_y)
        data_source_text = "  --" #"cal " #"active", "file"
        self.data_source_text_area = label.Label(terminalio.FONT, text=data_source_text, color=self.palette[0])
        data_source_group.append(self.data_source_text_area)
        self.group.append(data_source_group)

        # units_x
        units_x_select_x = 68
        units_x_color_x = units_x_select_x + select_width
        units_x_select_width = 96
        self.units_x_select = vectorio.Rectangle(pixel_shader=self.palette, color_index=0, width=units_x_select_width, height=lower_select_height, x=units_x_select_x, y=lower_select_y)
        self.group.append( self.units_x_select )
        self.selection_rectangles.append(self.units_x_select)

        self.units_x_select.hidden = True
        units_x_control_width = units_x_select_width - 2 * select_width
        self.units_x_color = vectorio.Rectangle(pixel_shader=self.palette, color_index=9, width=units_x_control_width, height=lower_control_height, x=units_x_color_x, y=lower_control_y)
        self.group.append( self.units_x_color )
        units_x_text_x = units_x_color_x + 4
        units_x_group = displayio.Group(scale=1, x=units_x_text_x, y=lower_text_y)
        units_x_text = "   --"
        self.units_x_text_area = label.Label(terminalio.FONT, text=units_x_text, color=self.palette[0])
        units_x_group.append(self.units_x_text_area)
        self.group.append(units_x_group)

        # distance
        distance_select_x = 160
        distance_select_width = 70

        distance_color_x = distance_select_x + select_width
        self.distance_select = vectorio.Rectangle(pixel_shader=self.palette, color_index=0, width=distance_select_width, height=lower_select_height, x=distance_select_x, y=lower_select_y)
        self.group.append( self.distance_select )
        self.selection_rectangles.append(self.distance_select)

        self.distance_select.hidden = True
        distance_control_width = distance_select_width - 2 * select_width
        self.distance_color = vectorio.Rectangle(pixel_shader=self.palette, color_index=9, width=distance_control_width, height=lower_control_height, x=distance_color_x, y=lower_control_y)
        self.group.append( self.distance_color )
        distance_text_x = distance_color_x + 3
        distance_group = displayio.Group(scale=1, x=distance_text_x, y=lower_text_y)
        distance_text = "   -- "
        self.distance_text_area = label.Label(terminalio.FONT, text=distance_text, color=self.palette[0])
        distance_group.append(self.distance_text_area)
        self.group.append(distance_group)


        # live
        live_select_width = 36
        live_select_x = 226
        live_color_x = live_select_x + select_width
        self.live_select = vectorio.Rectangle(pixel_shader=self.palette, color_index=0, width=live_select_width, height=lower_select_height, x=live_select_x, y=lower_select_y)
        self.group.append( self.live_select )
        self.selection_rectangles.append(self.live_select)

        self.live_select.hidden = True
        live_control_width = live_select_width - 2 * select_width
        self.live_color = vectorio.Rectangle(pixel_shader=self.palette, color_index=9, width=live_control_width, height=lower_control_height, x=live_color_x, y=lower_control_y)
        self.group.append( self.live_color )
        live_text_x = live_color_x + 3
        live_group = displayio.Group(scale=1, x=live_text_x, y=lower_text_y)
        live_text = " -- "
        self.live_text_area = label.Label(terminalio.FONT, text=live_text, color=self.palette[0])
        live_group.append(self.live_text_area)
        self.group.append(live_group)


        # RETURN

        return_select_width = 50
        return_select_x = 320 - offset - return_select_width
        return_color_x = return_select_x + select_width
        self.return_select = vectorio.Rectangle(pixel_shader=self.palette, color_index=0, width=return_select_width, height=lower_select_height, x=return_select_x, y=lower_select_y)
        self.group.append( self.return_select )
        self.selection_rectangles.append(self.return_select)
        self.selection_count = len( self.selection_rectangles )
        self.return_select.hidden = True
        return_control_width = return_select_width - 2 * select_width
        self.return_color = vectorio.Rectangle(pixel_shader=self.palette, color_index=19, width=return_control_width, height=lower_control_height, x=return_color_x, y=lower_control_y)
        self.group.append( self.return_color )
        return_text_x = return_color_x + 3
        return_group = displayio.Group(scale=1, x=return_text_x, y=lower_text_y)
        return_text = "RETURN"
        self.return_text_area = label.Label(terminalio.FONT, text=return_text, color=self.palette[0])
        return_group.append(self.return_text_area)
        self.group.append(return_group)

        # values bar
        values_bar_height = 14
        values_bar_y = 240 - offset - values_bar_height - lower_control_height
        values_bar_text_y = values_bar_y + 6
        values_width = 20
        left_value_x = 30
        values_spacing = int((290 - values_width ) / 4)
        # left_value
        left_value_group = displayio.Group(scale=1, x=left_value_x, y=values_bar_y)
        left_value_text = "000"
        self.left_value_text_area = label.Label(terminalio.FONT, text=left_value_text, color=self.palette[0])
        left_value_group.append(self.left_value_text_area)
        self.group.append(left_value_group)
        # left_mid_value
        left_mid_value_x = left_value_x + values_spacing
        left_mid_value_group = displayio.Group(scale=1, x=left_mid_value_x, y=values_bar_y)
        left_mid_value_text = "000"
        self.left_mid_value_text_area = label.Label(terminalio.FONT, text=left_mid_value_text, color=self.palette[0])
        left_mid_value_group.append(self.left_mid_value_text_area)
        self.group.append(left_mid_value_group)
        # mid_value
        mid_value_x = left_value_x + 2* values_spacing
        mid_value_group = displayio.Group(scale=1, x=mid_value_x, y=values_bar_y)
        mid_value_text = "000"
        self.mid_value_text_area = label.Label(terminalio.FONT, text=mid_value_text, color=self.palette[0])
        mid_value_group.append(self.mid_value_text_area)
        self.group.append(mid_value_group)
        # right_mid_value
        right_mid_value_x = left_value_x + 3*values_spacing
        right_mid_value_group = displayio.Group(scale=1, x=right_mid_value_x, y=values_bar_y)
        right_mid_value_text = "000"
        self.right_mid_value_text_area = label.Label(terminalio.FONT, text=right_mid_value_text, color=self.palette[0])
        right_mid_value_group.append(self.right_mid_value_text_area)
        self.group.append(right_mid_value_group)
        # right_value
        right_value_x = left_value_x + 4*values_spacing
        right_value_group = displayio.Group(scale=1, x=right_value_x, y=values_bar_y)
        right_value_text = "000"
        self.right_value_text_area = label.Label(terminalio.FONT, text=right_value_text, color=self.palette[0])
        right_value_group.append(self.right_value_text_area)
        self.group.append(right_value_group)

        self.create_plot()

        return self.group

    def hide_all_selections( self ):
        for item in self.selection_rectangles:
            if item.hidden == False:
                item.hidden = True



def make_light_page( instrument ):
    instrument.welcome_page.announce( "make_light_page (~50s)" )
    page = Light_Page( instrument )
    group = page.make_group()
    page.hide()
    instrument.main_display_group.append( group )
    instrument.pages_list.append( page )
    return page



class Light_Missing_Page( Page ):
    def __init__( self, instrument ):
        super().__init__()
        self.page_name = "Light"
        self.instrument = instrument
        self.palette = instrument.palette
        self.selection = 0
        self.selection_count = 0
        self.field_selected = False
    def make_group( self ):
        self.group = displayio.Group()
        status_background = vectorio.Rectangle( pixel_shader=self.palette, color_index = 9, width=320, height=240, x=0, y=0 )
        self.group.append( status_background )
        text_spacing_y = 28
        status_title_group = displayio.Group(scale=2, x=10, y=18)
        status_title_text = "No spectral sensor(s):"
        status_title_text_area = label.Label(terminalio.FONT, text=status_title_text, color=self.palette[0])
        status_title_group.append(status_title_text_area)
        self.group.append(status_title_group)

        text_group = displayio.Group(scale=2, x=10, y=18+text_spacing_y)
        text = "connect either "
        text_area = label.Label(terminalio.FONT, text=text, color=self.palette[0])
        text_group.append(text_area)
        self.group.append(text_group)

        text_group = displayio.Group(scale=2, x=10, y=18+2*text_spacing_y)
        text = "Remote Sensing plugin"
        text_area = label.Label(terminalio.FONT, text=text, color=self.palette[0])
        text_group.append(text_area)
        self.group.append(text_group)

        text_group = displayio.Group(scale=2, x=10, y=18+3*text_spacing_y)
        text = "or a spectral sensor"
        text_area = label.Label(terminalio.FONT, text=text, color=self.palette[0])
        text_group.append(text_area)
        self.group.append(text_group)

        text_group = displayio.Group(scale=2, x=10, y=18+4*text_spacing_y)
        text = "and restart"
        text_area = label.Label(terminalio.FONT, text=text, color=self.palette[0])
        text_group.append(text_area)
        self.group.append(text_group)


        # RETURN
        select_width = 4
        return_height = 28
        return_select_y = 240 - 4 - 2 - return_height - select_width
        return_select_height = return_height + 2*select_width
        return_y = return_select_y + select_width
        return_text_y = return_y + 12
        return_select_width = 100
        return_select_x = 320 - 4 - return_select_width
        return_x = return_select_x + select_width
        self.return_select = vectorio.Rectangle(pixel_shader=self.palette, color_index=0, width=return_select_width, height=return_select_height, x=return_select_x, y=return_select_y)
        self.group.append( self.return_select )
        #self.return_select.hidden = True
        return_control_width = return_select_width - 2 * select_width
        self.return_color = vectorio.Rectangle(pixel_shader=self.palette, color_index=19, width=return_control_width, height=return_height, x=return_x, y=return_y)
        self.group.append( self.return_color )
        return_text_x = return_x + 10
        return_group = displayio.Group(scale=2, x=return_text_x, y=return_text_y)
        return_text = "RETURN"
        self.return_text_area = label.Label(terminalio.FONT, text=return_text, color=self.palette[0])
        return_group.append(self.return_text_area)
        self.group.append(return_group)
        return self.group
    def hide_all_selections( self ):
        pass
    def action( self ):
        self.instrument.active_page_number = self.instrument.pages_dict["Main"]
    def update_selection( self ):
        pass
    def update_plot( self ):
        pass

def make_light_missing_page( instrument ):
    instrument.welcome_page.announce( "make_light_missing_page" )
    page = Light_Missing_Page( instrument )
    group = page.make_group()
    page.hide()
    instrument.main_display_group.append( group )
    instrument.pages_list.append( page )
    return page
