paulmirel/STELLA-1/STELLA_1.2/STELLA_1.2_code_and_libraries/1.3.3_version_unstable/code.py

SOFTWARE_VERSION_NUMBER = "1.3.3"
DEVICE_TYPE = "STELLA-1.2"
# STELLA-1.2 multifunction instrument
# Copyright NASA 2026 under MIT open source license
# Author Paul Mirel

# gather startup statistics
import time
startup_start_time = time.monotonic()
import gc
gc.collect()
start_mem_free_kB = gc.mem_free()/1000
print("start memory free {0:.2f} kB".format( start_mem_free_kB ))

# configuration imports
from configuration_files import user_settings

# operational imports
import os
import microcontroller
import board
import digitalio
import busio
import displayio
import rotaryio
#import terminalio
#from adafruit_display_text import label
#import vectorio
import rtc
from analogio import AnalogIn
import sys

# functional imports
import math

# scan the i2c_bus for devices present
i2c_bus = board.I2C()
i2c_bus.try_lock()
devices_present = i2c_bus.scan()
devices_present_hex = []
for device_address in devices_present:
    devices_present_hex.append(hex(device_address))
i2c_bus.unlock()
print( devices_present_hex )

# supported devices by i2c_address:
# 0x12 pmsa0031 particulates sensor
# 0x18 DS248x   1 wire thermometer reader
# 0x19 lsm303   accelerometer
# 0x1c lsm6ds   Accelerometer and gyroscope
# 0x1e lis2mdl  Magnetic field sensor
# 0x1f mcp9808  Thermometer ### close a0, a1, a2 address jumpers on board to set address
# TBD 0x28 soil_con Soil conductance sensor
# 0x29 vl53l1x  Lidar range finder
# TBD 0x33 mlx90640 Thermal camera
# 0x34 buzzer   Qwiic buzzer
# 0x36 max1704x Battery monitor
# TBD 0x37 seesaw soil_cap Soil capacitance sensor
# 0x38 focaltouch   Capacitive touch screen sensor
# 0x39 as7341   Visible spectral sensor
# 0x44 hdc302x  Precision temperature and humidity sensor
# 0x44 sht40  Precision temperature and humidity sensor
# 0x48 ads1015  Analog to digital converter, 12 bits, 4 channels
# 0x49 as7265x  Visible and Near Infrared spectral sensor
# 0x4a ads1115  Analog to digital converter, 16 bits, 4 channels ### connect ADDR to SDA to set address
# 0x4f pcf8591  Analog to digital converter, 8 bits, 4 channels, and digital to analog converter, 1 channel ### close a0, a1, a2 address jumpers on board to set address
# 0x53 ltr390   UV and total illumination sensor
# 0x59 tcs3448  Spectral sensor VNIR
# 0x5a mlx90614 Thermal infrared remote surface thermometer
# 0x60 mcp4728  Quad DAC
# 0x61 scd30    CO2 sensor, NDIR: nondispersive infrared absorption, with temperature and humidity sensors
# 0x62 scd4x    CO2 sensor, thermo-acoustic: pulsed infrared resonant heating and microphone, with temperature and humidity sensors
# 0x68 pcf8523  Real time clock
# 0x6a lis3mdl  Magnetic field sensor
# 0x74 as7331   Ultraviolet spectral sensor
# 0x77 bme280   Barometric pressure sensor, with temperature and humidity sensors

mem_free_after_imports = gc.mem_free()
print( "mem free after imports = {} kB, {} %".format(int(gc.mem_free()/1000), int(100*(gc.mem_free()/1000)/start_mem_free_kB )) )

from software_modules import classm_device
from software_modules import functionm_file, functionm_palette
from software_modules import devicem_pcf8523_rtc, devicem_neopixel
from software_modules import devicem_ili9341_display, devicem_gps
from software_modules import devicem_rotary_encoder, devicem_focaltouch
from software_modules import pagem_welcome, pagem_controls, pagem_main_menu, pagem_status
from software_modules import pagem_settings, pagem_sensors, pagem_lab_spec
from software_modules import pagem_light, pagem_exposure, pagem_heat, pagem_air, pagem_time_place
from software_modules import pagem_calibration
from software_modules import devicem_supply_5V

load_wifi = False
if load_wifi:
    try:
        # wifi is optional
        from software_modules import wifi as wifi_module
    except ImportError as e:
        if 'software_modules.wifi' in str(e):
            print(f"wifi module")
            class wifi_module:
                # the only api from code.py
                def initialize(instrument):
                    return None
        else:
            raise e
    try:
        # ntp is optional
        from software_modules import ntp
    except ImportError as e:
        if 'software_modules.ntp' in str(e):
            print(f"ntp module: no internet time")
            class NTPTime:
                def update(self):
                    pass
            class ntp:
                # the only api from code.py
                def initialize():
                    return NTPTime()
        else:
            raise e
    try:
        # httpd for sd card is optional
        from software_modules import sd_httpd
    except ImportError as e:
        if 'software_modules.sd_httpd' in str(e):
            print(f"sd_httpd module: no web-page")
            class sd_httpd:
                # the only api from code.py
                def initialize(instrument):
                    return None
                def update():
                    pass
        else:
            raise e
    try:
        # mdns is optional
        from software_modules import mdns
    except ImportError as e:
        if 'software_modules.mdns' in str(e):
            print(f"mdns module: use ip address in url")
            class mdns:
                # the only api from code.py
                def initialize(instrument):
                    return None
                def update():
                    pass
        else:
            raise e
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
