paulmirel/STELLA-1/(commit log)

2025-10-20 add 1.1 and 1.2 files
    [S12 GPS window color change at 0.4 and 0.8 and 1.5.STL, S12 QT alignment fixture.STL, S12 REC window change color at 0.4 and 0.8 and 1.5.STL, S12 UID side tag change color at 1.6.STL, S12 UID side tag.STEP, S12 assembly fixture _ print w supports on build plate.STL, S12 aux sensor retainer.STL, S12 battery spacer.STL]
2025-10-22 add stella-1.2 documentation, start exposure control development
    [STELLA-1.2 package control lists 20251022.xlsx, color lookup table.xlsx]
2025-10-23 add pins for rotary encoder
2025-10-23 add sensor choice box
2025-10-24 set exposure bracket high and low positions in log base 10
2025-10-27 adapting to the new sparkfun library for as7265x in circuitpython
2025-10-29 init other spectra sensors
2025-10-30 init all three sensors, set gain for the first one
2025-11-03 respond to sample button push
2025-11-04 choose sensor through interface.
2025-11-04 live control of gain for as7265x, with correct value and slider showing.
    [code.py]
2025-11-04 implement integration time. Need to build integration time lists in sensor objects.
2025-11-05 correct sensor_gain_choices variable names
    [code.py]
2025-11-05 implement log and linear exposure bracket sliders, implement bracket shading.
2025-11-05 implement integration time and lamp current slider shading
2025-11-08 set the as7341 sensor astep and atime. Excellent.
2025-11-09 if setting mode is Manual, allow setting of gain and int time. Else, grey out and skip over those two fields
    [code.py]
2025-11-11 clean up sensor select highlighting
2025-11-12 begin action on button press
2025-11-12 sensor selection working
2025-11-13 rework the as7265x module completely to query and report in wavelength order
    [as7265x_spectral_sensor_module.py, code.py]
2025-11-13 new library is being recalcitrant. Sensor takes one reading and then won't take another.
    [as7265x_spectral_sensor_module.py, code.py]
2025-11-13 read_counts_by_index doesn't work properly, won't update values, where as7265x_spectrometer.swob.get_c()does work. A useful difference.
    [code.py]
2025-11-15 show gain in value bar. Gain is not setting in the sensor yet.
2025-11-15 grab the default gains for all sensors present, and set the gain at the sensor.
2025-11-15 get control of a single lamp current, and show it on the display
2025-11-16 implement lamp selection, and skip fields if no lamp or only one lamp
    [as7265x_spectral_sensor_module.py, code.py]
2025-11-16 show LIMIT message if current setting is maximum and below 90mA
2025-11-17 implement lamp selection and current setting with limits.
2025-11-18 add parent class to device modules
2025-11-18 initialize devices from devicem modules.
2025-11-18 init encoder and touch
2025-11-20 reorganize code and library files for clarity, unstable versus stable.
    [code.py, devicem_ads1015.py, devicem_ads1115.py, devicem_bme280.py, devicem_ds2484.py, devicem_focaltouch.py, devicem_gps.py, devicem_hdc3022.py]
2025-11-20 begin rebuilding main loop with sensor reads.
2025-11-20 init and read battery monitor
2025-11-20 reorganize sensor imports and intiialzations
2025-11-21 import Device parent class
2025-11-23 import the Device and Page class to devicem and pagem modules.
2025-11-23 correct the import statements to . from /, and add __init__.py to the directory
    [code.py, devicem_ads1015.py, devicem_ads1115.py, devicem_bme280.py, devicem_ds2484.py, devicem_focaltouch.py, devicem_gps.py, devicem_hdc3022.py]
2025-11-26 remove % from battery level display if >= 100
2025-11-27 restore button push
2025-11-28 configure log for sensors, arrange serial out.
2025-11-28 begin building sensors page
2025-11-28 build sensors list page structure.
2025-11-28 populate sensor list with sensors present
2025-11-28 add CO2 sensor to test list
2025-11-28 add NIR lidar to list
2025-11-29 create generic sensor page, populate with name and part number.
2025-11-29 live data on sensor page from battery monitor.
2025-11-29 sensor page 12 bit adc
2025-11-29 sensor page scd4x
2025-11-29 sensor page add two more
2025-11-29 sensor page add more sensors
2025-11-29 sensor page add last sensors on active list
2025-11-30 remove sensor list page, go directly to generic sensor page
2025-11-30 outstanding. get generic sensor page to use rotary input to choose sensor, display data in real time.
2025-11-30 build single spectral channel sensors from as7265x
2025-12-01 get calibrated irradiances, report in si units.
2025-12-01 get temperatures.
2025-12-02 rewrite main logic with flying intervals for sample and serial, instead of delay intervals
2025-12-03 read and record only one sensor when in generic sensor page mode.
2025-12-06 add heat page
2025-12-07 start laying out values and labels on heat page.
2025-12-13 heat page shows live data
2025-12-13 restore goto light page if spectral sensors
2025-12-14 skip unavailable selections in exposure control.
    [pagem_exposure.py]
2025-12-14 grey out lamp current when no lamp
2025-12-14 build in a Heat page banner to report when no temperature sensors are present.
2025-12-14 attempted to box in all controls so it can't hang or crash.
    [code.py, pagem_controls.py, pagem_settings.py, pagem_status.py]
2025-12-24 set spectrum ranges to match sensors
2025-12-24 remove spectrum listing print
2025-12-31 selections rotate with encoder rotations
2025-12-31 show gain and integration time. skip measurment in main loop, in favor of measuring in lab_spec page at update, to avoid reading other sensors present.
    [code.py, pagem_lab_spec.py]
2026-01-01 make lab_spec page tolerate missing plugin.
    [pagem_lab_spec.py]
2026-01-01 change 5V to disable
2026-01-02 supply_5V object, with controls and field calibrated readout
2026-01-02 orange unit shows voltages as expected, no field cal needed.
2026-01-02 show on off for 5V supply on labspec screen
2026-01-02 polynomial fit to convert desired current into DAC counts. Lousy fit, but that's why we read the actual current at the shunt
2026-01-02 add current setting, gain control, and channel selections
2026-01-07 add CP10 libraries, begin work on Appetizer
    [bunny.obj, cat_top.stl]
2026-01-08 start and describe the I2C bus
2026-01-08 check buttons, look for button events
2026-01-09 set startup screen by sensors present
2026-01-26 begin work on ver 0.9, problem with input controls not responding.
    [code.py, devicem_gps.py, devicem_hdc3022.py, devicem_ili9341_display.py, devicem_lis2mdl.py, devicem_lis3mdl.py, devicem_lsm303.py, devicem_lsm6ds.py]
2026-02-01 move storage evaluation to status page init, to not interrupt and thus corrupt the files during writing with an os query
2026-02-02 repair point placement on x axis
2026-02-06 detect lab spec devices and go to page if all()
2026-02-08 set REQ current
2026-02-08 add gain choice of 512 to as7341
    [bunny.obj, cat_top.stl]
2026-02-12 get and average lamp currents
2026-02-15 create device objects
2026-02-15 create gps on i2c
2026-02-15 fix bug in updatee_filename
    [code.py, devicem_gps.py, pagem_welcome_LSQ.py]
2026-02-15 begin to add battery monitor
2026-02-16 fix bug in main code, update to 1.0.2
    [code.py]
2026-02-19 reconfigure lab spec page for just the one sensor, as7341_spectrometer
2026-02-19 one more fix for missing buzzer in main, check inputs
    [code.py]
2026-02-20 rearrange main menu, truncate DR on labspec mmt readouts, add battery and calendar day check to main loop level
2026-03-05 make mcp4728 tolerant of both address variants, check the battery each loop cycle
2026-03-05 allow new measurement to reset status from no current to OK
    [code.py, devicem_mcp4728.py, pagem_lab_spec.py]
2026-04-18 Lab-spec drawings and STL part files.
    [LS-C2 blackout shutter.STL, LS-C2 cuvette block foot pair.STL, LS-C2 cuvette block.STL, LS-C2 cuvette pedestal.STL, LS-C2 cuvette swing lid.STL, LS-C2 detector block for cuvette - assembly fixture.STL, LS-C2 detector block for cuvette.STL, LS-C2 end cover.STL]
2026-04-18 add spreadsheet w instructions and lists
    [LS_housing_base.3mf, Lab Spec Build Instructions.xlsx]
2026-04-18 add schematic
2026-04-19 improve lable on LS-P2 end cap
    [LS-P2 end cover.STL]
2026-04-19 add lable to LS-C2 lid
    [LS-C2 cuvette swing lid.STL]
2026-04-19 add led2 fixtures
    [led2 dip pins fixture.STL, led2 stencil fixture.STL]
2026-04-20 critical update to instructions
    [Lab Spec Build Instructions.xlsx]
2026-04-20 add fixture print files
    [full board magnet coupler fixture plate.STL, led2 dip pins fixture.STL, led2 stencil fixture.STL, magnet coupler alignment fixture mirror.STL, magnet coupler alignment fixture.STL]
2026-04-20 updated, corrected, added costs to spreadsheet
    [Lab Spec Build Instructions.xlsx]
2026-04-22 updated side led cover and detector block for LS-C2
    [LS-C2 detector block for cuvette.STL, LS-C2 side led cover flag.STL, LS-C2 side led cover plain.STL]
2026-04-27 change current selection to percent, improve precision
2026-04-28 restore current REQ% setting
2026-04-28 important but incomplete updates to build spreadsheet
    [Lab Spec Build Instructions.xlsx]
2026-04-29 updates to build instructions
    [Lab Spec Build Instructions.xlsx]
2026-05-03 less verbose. cleanup edge case.
2026-05-03 copy over mdns, fix http_update
    [code.py, sd_httpd.py]
2026-05-13 fix ntp when module missing
    [code.py]
2026-05-13 mdns: fix disappearing, optional TXT, longer ttl
    [mdns.py]
2026-05-13 http: fix error catch
    [sd_httpd.py]
2026-05-13 Multiple ssid/passwords in settings.toml
    You must setup the file CIRCUITPY/settings.toml:
    CIRCUITPY_WIFI_SSID="Your WiFi SSID Here"
    CIRCUITPY_WIFI_PASSWORD="Your WiFi Password Here"
    # optionally, more credentials, up to 20
    CIRCUITPY_WIFI_SSID1="another WiFi SSID Here"
    CIRCUITPY_WIFI_PASSWORD1="another WiFi Password Here"
2026-05-23 roatry encoder response imroved
2026-05-29 Reorganize some more
    [LS-C2 blackout shutter.STL, LS-C2 cuvette block foot pair.STL, LS-C2 cuvette block.STL, LS-C2 cuvette pedestal.STL, LS-C2 cuvette swing lid.STL, LS-C2 detector block for cuvette - assembly fixture.STL, LS-C2 detector block for cuvette.STL, LS-C2 end cover.STL]
2026-08-02 begin experimental work on RS-B plugin support code
    [bunny.obj, cat_top.stl]
2026-08-02 minor changes to main board build list
2026-08-05 reenable lidar rangefinder
2026-08-08 as7343 working at sensor page and at light page
2026-08-13 as7341 working with new whole sensor unit read
2026-08-13 as7265x working with full sensor read. Everybody reports properly normalized ct per s nm, and reports only 0 for irradiance.
2026-08-14 add action to More to go to future calibration page
2026-08-14 go to calibration page
2026-08-14 build calibration page structure from labspec structure.
2026-08-14 change colors on calibration panel
2026-08-16 restore color scheme to calibration page
2026-08-16 change button to self-test/reset
    [pagem_calibration.py]
2026-08-16 wrong step size by three orders of magnitude. Corrected and reprogrammed for the much easier task.
    [pagem_calibration.py]
2026-09-08 add calibration test code -- i2c bus scan
2026-09-09 add calibration test code -- servo test
2026-09-13 tune servo motion
2026-09-22 check angle sensors and flash spectral sensor lamps for AS7341 and AS7343
2026-09-24 got the ds3231 clock working at address 0x18 after changer
    [bunny.obj, cat_top.stl]
2026-09-30 check angle sensors. Magnet is too weak.
    [code.py]
2026-10-07 wheel positions code
2026-10-08 resume work on calibration page in main software
2026-10-08 arrange startup to skip non-calibration page creations to reduce startup time.
    [code.py, pagem_calibration.py]
2026-10-08 add support for SHT40 sensor
2026-10-09 sync system to precision clock in calibration system.
2026-10-09 make load wifi optional, rearrange line 2 on calibration page.
2026-10-14 add sensors to cal page
2026-10-19 switch to compiled library for tcs3448
2026-10-21 turn off the blue indicator led on startup
2026-10-21 set current all lamps, exposure control working
2026-10-23 write cal_lookup files for wheel configurations
2026-10-23 restore wheel positions code file
2026-10-23 restore calibration page to working order
2026-10-23 load wheel lookup values
2026-10-23 load filter wheel lookup values
2026-10-23 build function for sensor wheel display line values
2026-10-23 build function for filter wheel display line values
2026-10-24 sensor wheel twist and crawl.
2026-10-24 tuned wheel 8
2026-10-24 tuned wheel 1
2026-10-24 tuned wheel 3 and 5
2026-10-24 filter wheel twist and crawl and tuned
2026-10-24 sensor wheel seems less zippy now, compared to filter wheel. Much larger rotational inertia.
2026-10-26 run measurement sequence works athrough to the wheels
2026-10-27 sensor and filter positions not known on startup, display as such
2026-10-27 display sensor tracking and filter info
2026-10-28 add read_gain() to spectral sensor modules
2026-10-28 read gain of current sensor
2026-10-28 read integration time of current sensor. only works for tcs3448 so far
2026-10-28 read integration time of current sensor.
2026-10-28 set gain for active sensor with front panel control
2026-10-28 set integration time for active sensor with front panel control
2026-10-29 set integration time for active sensor with front panel control, including as7265x
2026-10-29 set integration time for active sensor with front panel control, including as7343
2026-10-29 set integration time for active sensor with front panel control, including as7341
2026-11-04 write data to file. also, repair sticky gain and integration time by returning them from autoset instead of askign again right after. i2c bus just isn't that fast for these sensors
2026-11-05 direct filter lookup to more than one filter wheel
2026-11-05 add filter pn and value and placeholder for chip temperature to the data line
2026-11-05 remove chip temperature placeholder, as it's only available on the as7265x
2026-11-05 create external sensor mode
2026-11-05 external sensor mode functional
2026-11-06 careful tuning of filter wheel positions
2026-11-07 giving up on Dean Miller sparkfun triad library, going to try AWGrover AS7265X_sparkfun library instead.
2026-11-07 remove some print statements
2026-11-08 working properly. too much light makes the as7265x sensor behave in unphysical ways. Sensor remains undamaged
2026-11-10 full set of filter config files
2026-11-10 retired F0 and F1 filter wheel configurations
2026-11-10 completed F2,F3, F4 filter wheel configurations
