paulmirel/STELLA-1/(notices)

Notices in the files:
Everything_else/Circuitpython_10_libraries/adafruit-circuitpython-bundle-py-20260924/examples/bno055/bno055_webgl_demo/static/bunny.obj:
3ds Max Wavefront OBJ Exporter v0.94b - (c)2007 guruware
